ChrisHayward-dev/SapphireKicad/README.md

See the LastProduction branch for the most current revision
