ChrisHayward-dev/SapphireKicad/SapphirePinout.xlsx

Sheet: E Mini Pin Connection
Sapphire Pin Connection Table
 |  |  |  |  |  |  | Proposed E Series Mini
ATSAMD21E18_QFN
Pin E Series | Adafruit Name | Ports (J Series) | Ports | GCLK | SERCOM | Int | Sapphire | Global Name | Pullup | PinMode | Idle State | Use Interrupt | DS3231 Pin | DHLR Pin | TPS22929 GNSS Pin | TPS22929 SD Pin | Other
1 | 32 KHz xtal |  | PA00 |  | S1_0 | 0 | DS3231 32KHz | 32KHz | Y | Input |  |  | 1
2 | 32 KHz xtal |  | PA01 |  | S1_1 | 1 | FRAM CS | FRAM_CS | Y | Input |  | 1 | 3
3 | A0 |  | PA02 |  |  | 2 | RED_LED | RED_LED
4 | AREF |  | PA03 |  |  | 3 | AREF | AREF | N | Input
5 | A3 |  | PA04 |  | S0_0 | 4 | PB1 | PB1 | N | Input
6 | A4 |  | PA05 |  | S0_1 | 5 | VBAT_MON | VBAT_MON | N | Input
7 | D8/NEO PIXEL |  | PA06 | pwd | S0_2 | 6 | RS232_TXD5 | ~~RS232_TXD ~~ | ~~N~~ | ~~Input~~ | xmit
8 | D9 |  | PA07 | : | S0_3 | 7 | RS232_RXD5 | ~~RS232_RXD~~ | ~~N~~ | ~~Output~~ | recv
9 | VDDA
10 | GNDA
11 |  |  | PA08 |  | S0_0 | NMI | SD_CS | SD_CS | U | Output
12 |  |  | PA09 |  | S0_2/S2_1 | 17 | SD_CD | SD_CD | N | Output
13 | D1 |  | PA10 | GCLK4 | S0_2/S2_2 | 10 | SD_PWR | SD_PWR | U | Output
14 | D0 |  | PA11 | GCLK5 | S0_3/S2_3 | 11 | GNSS_PWR | GNSS_PWR | D
15 | D2/FL MISO |  | PA14 | GCLK0 | S2_2/S4_2 | 14 | TIMEMARK | GNSS_PPS | N | Input
16 | D5 |  | PA15 | GCLK1 | S2_3/S4_3 | 15 | RED_LED2 | RED_LED2 | N
17 | D11 |  | PA16 | GCLK2 | S1_0/S3_0 | 0 | SPI1_MOSI | SPI1_MOSI | N
18 | D13 |  | PA17 | GCLK3 | S1_1/S3_1 | 1 | SPI1_SCK | SPI1_SCK | N | Output
19 | D10 |  | PA18 |  | S1_2/S3_2 | 2 | DLHR_EOC | DLHR_EOC | N | Input |  | 2
20 | D12 |  | PA19 |  | S1_3/S3_3 | 3 | SPI1_MISO | SPI1_MISO | N | Input |  | 3
21 | SDA |  | PA22 |  | S3_0/S5_0 | 6 | mcu SDA | mcu SDA | U | I/O |  |  | 15
22 | SCL |  | PA23 |  | S3_1/S5_1 | 7 | mcu SCL | mcu SCL | U | I/O |  |  | 16
23 | D- |  | PA24 |  | S3_2/S5_2 | 12 | USB DM | USB DM |  | I/O
24 | D+ |  | PA25 |  | S3_3/S5_3 | 13 | USB DP | USB DP |  | I/O
25 | TXLED |  | PA27 | GCLK0 |  | 15 | GREEN_LED | GREEN_LED | N | Input
26 | RESET |  |  |  |  |  | RESET | RESET | U | Input |  |  | 4
27 | USBHOSTEN |  | PA28 | GCLK0 |  | 8 | LOCAL_PPS | LOCAL_PPS | N | Output
28 | GND
29 | VDDCORE
30 | VDDIN
31 | SWCLK |  | PA30 | GCLK0 | S1_2 | 10 | SWCLK | SWCLK | U | DEBUG
32 | SWDIO |  | PA31 |  | S1_3 | 11 | SWDIO/FRAM HOLD | SWDIO | U | DEBUG

Sheet: Copy of E Mini Pin Connection
Sapphire Pin Connection Table
 |  |  |  |  |  |  |  | Proposed E Series Mini
ATSAMD21E18_QFN
Pin E Series | Adafruit Name | Ports (J Series) | Ports | GCLK | SERCOM | Int | Prototype Sapphire Use | Sapphire | Global Name | Pullup | PinMode | Changes | Idle State | Use Interrupt | DS3231 Pin | DHLR Pin | TPS22929 GNSS Pin | TPS22929 SD Pin | Other
1 | 32 KHz xtal |  | PA00 |  | S1_0 | 0 | XTAL | DS3231 32KHz | 32KHz | Y | Input |  |  |  | 1
2 | 32 KHz xtal |  | PA01 |  | S1_1 | 1 | XTAL | DS3231 SQW | LOCAL_PPS | Y | Input | Unused |  | 1 | 3
3 | A0 |  | PA02 |  |  | 2 | VCXO cntrl | RED_LED | RED_LED
4 | AREF |  | PA03 |  |  | 3 | spare | AREF | AREF | N | Input
5 | A3 |  | PA04 |  | S0_0 | 4 | VCUR MON | PWR_GOOD | PWR_GOOD | N | Input
6 | A4 |  | PA05 |  | S0_1 | 5 | VBAT MON | VBAT_MON | VBAT_MON | N | Input
7 | D8/NEO PIXEL |  | PA06 | pwd | S0_2 | 6 | Green LED | ~~RS232_TXD ~~ | ~~RS232_TXD ~~ | ~~N~~ | ~~Input~~ | RS232_RXD | xmit
8 | D9 |  | PA07 | : | S0_3 | 7 | spare | ~~RS232_RXD~~ | ~~RS232_RXD~~ | ~~N~~ | ~~Output~~ | RS232_TXD | recv
9 | VDDA
10 | GNDA
11 |  |  | PA08 |  | S0_0 | NMI |  | SD_CS | SD_CS | U | Output
12 |  |  | PA09 |  | S0_2/S2_1 | 17 | spare | SD_CD | SD_CD | N | Output
13 | D1 |  | PA10 | GCLK4 | S0_2/S2_2 | 10 | spare | SD_PWR | SD_PWR | U | Output
14 | D0 |  | PA11 | GCLK5 | S0_3/S2_3 | 11 | spare | GNSS_PWR | GNSS_PWR | D
15 | D2/FL MISO |  | PA14 | GCLK0 | S2_2/S4_2 | 14 | Accel Int1 | RED_LED2 | RED_LED2 | N | Input
16 | D5 |  | PA15 | GCLK1 | S2_3/S4_3 | 15 | Accel Int2 | GNSS_PPS | GNSS_PPS | N
17 | D11 |  | PA16 | GCLK2 | S1_0/S3_0 | 0 | 7124 RDY | SPI1_MOSI | SPI1_MOSI | N
18 | D13 |  | PA17 | GCLK3 | S1_1/S3_1 | 1 | Red LED | SPI1_SCK | SPI1_SCK | N | Output
19 | D10 |  | PA18 |  | S1_2/S3_2 | 2 | DLHR EOC | DLHR_EOC | DLHR_EOC | N | Input |  |  | 2
20 | D12 |  | PA19 |  | S1_3/S3_3 | 3 | Timemark | SPI1_MISO | SPI1_MISO | N | Input |  |  | 3
21 | SDA |  | PA22 |  | S3_0/S5_0 | 6 | mcu SDA | mcu SDA | mcu SDA | U | I/O |  |  |  | 15
22 | SCL |  | PA23 |  | S3_1/S5_1 | 7 | mcu SCL | mcu SCL | mcu SCL | U | I/O |  |  |  | 16
23 | D- |  | PA24 |  | S3_2/S5_2 | 12 | USB DM | USB DM | USB DM |  | I/O
24 | D+ |  | PA25 |  | S3_3/S5_3 | 13 | USB DP | USB DP | USB DP |  | I/O
25 | TXLED |  | PA27 | GCLK0 |  | 15 | GNSS 3D fix | GNSS_GO2SLEEP | GNSS_GO2SLEEP | N | Input | GREEN_LED
26 | RESET |  |  |  |  |  |  | RESET | RESET | U | Input |  |  |  | 4
27 | USBHOSTEN |  | PA28 | GCLK0 |  | 8 | GNSS 2 sleep | GREEN_LED | GREEN_LED | N | Output | Local PPS
28 | GND
29 | VDDCORE
30 | VDDIN
31 | SWCLK |  | PA30 | GCLK0 | S1_2 | 10 | SWCLK | SWCLK | SWCLK | U | DEBUG
32 | SWDIO |  | PA31 |  | S1_3 | 11 | SWDIO | SWDIO | SWDIO | U | DEBUG

Sheet: Original BOM
Reference | Value | Footprint | Datasheet | MPN | Manufacturer |  |  | Tolerance | Type | voltge | count
> BT601, BT602 | Battery | geo_sci_SMU:Keystone_2464_batt_holder | ~ | 2464 | Keystone |  |  |  |  |  | 2
> C201, C401, C501, C502, C512, C516, C601, C607, C608, C613-C618, C701, C802, C809 | 10uF | ... | ~ | ... | ... |  |  | ... | ... | ... | 18
> C202, C301, C402, C403, C503-C505, C507, C511, C513-C515, C517-C521, C602, C605, C609, C610, C612, C702, C703, C801, C803, C805-C808, C813, C814, C816 | 100nF | ... | ~ | ... | ... |  |  | ... | ... | 50V | 33
 |  |  |  | CGA3E2X7R1H104K080AA | TDK |  |  | 10% | X7R | 50V
> C506, C603, C604, C606, C804, C817 | 1uF | Capacitors_SMD:C_0603 | ~ | CC0603KRX5R8BB105 | Yageo |  |  | 10% | X5R | 25V | 6
> C508, C509 | 22nF | Capacitors_SMD:C_0603 | ~ | GRM21B5C1H223JA01L | Murata |  |  | 5% | C0G | 50V | 2
C510 | 220nF | Capacitors_SMD:C_1206 | ~ | GRM31C5C1H224JE02L | Murata |  |  | 5% | CoG | 50V | 1
C611 | 2.2pF | Capacitors_SMD:C_0603 | ~ | CC0603KRX5R8BB105 | Yageo |  |  | 10% | X5R | 25V | 1
> C810, C811 | 12pF | Capacitors_SMD:C_0603 | ~ | GCM1885C2A120FA16D | Murata |  |  | 1% | C0G | 100V | 2
C815 | 4u7 | Capacitors_SMD:C_0603 | ~ | GRM188R61E475KE11D | Murata |  |  | 10% | X5R | 25V | 1
CR801 | TPD4E1U06DCK | TO_SOT_Packages_SMD:SOT-363_SC-70-6 |  | TPD4E1U06DCKR | Texas Instruments |  |  |  |  |  | 1
D601 | MBR180 | Diodes_SMD:D_SOD-123 | ~ | MBR180S1-7 | Diodes Inc |  |  |  |  |  | 1
D801 | RGB | geo_sci_SMU:SML_LX0303_RGB | https://www.mouser.com/datasheet/2/244/SML-LX0303SIUPGUSB-1509215.pdf | SML-LX0303SIUPGUSB | LUMEX |  |  |  |  |  | 1
D802 | GREEN | LEDs:LED_0603 | ~ | APHD1608LCGCK | Kingbright |  |  |  |  |  | 1
D803 | RED | LEDs:LED_0603 | ~ | APTD1608SURCK | Kingbright |  |  |  |  |  | 1
D804 | YELLOW | LEDs:LED_0603 | ~ | APHD1608LSYCK | Kingbright |  |  |  |  |  | 1
> FB401, FB501, FB502, FB801 | 600 | Resistors_SMD:R_0603 | ~ | BLM18KG601SZ1D | Murata |  | BLM18KG601SZ1D |  |  |  | 4
> FID101-FID103 | Fiducial | Fiducials:Fiducial_1mm_Dia_2.54mm_Outer_CopperTop | ~ |  |  |  |  |  |  |  | 3
> H101-H104 | MountingHole | Mounting_Holes:MountingHole_3.2mm_M3_Pad_Via | ~ |  |  |  |  |  |  |  | 4
J501 | Conn_01x02 | Connectors_Molex:Molex_KK-6410-02_02x2.54mm_Straight | ~ | 22-23-2023 | Molex |  |  |  |  |  | 1
J502 | Conn_02x03_Odd_Even | geo_sci_SMU:Socket_Strip_Straight_2x03_Pitch2.54mm | ~ | M20-9980346 | Harwin |  |  |  |  |  | 1
J801 | Conn_02x10_Odd_Even | geo_sci_SMU:Socket_Strip_Straight_2x10_Pitch2.54mmL_R | ~ | 77313-824-20LF | Amphenol FCI |  |  |  |  |  | 1
J802 | Conn_02x05_Odd_Even | geo_sci_SMU:Socket_Strip_Straight_2x05_Pitch2.54mm_shrouded | ~ | N2510-6002RB | 3M |  |  |  |  |  | 1
J803 | USB_B_Micro | geo_sci_SMU:uUSB_B | ~ | 10118192-0001LF | Amphenol FCI |  |  |  |  |  | 1
L601 | 1.2 uH |  | ~ |  |  |  |  |  |  |  | 1
> P501-P503 | SHUNT |  |  | 382811-6 | TE Connectivity |  |  |  |  |  | 3
P801 | sdcard_conn | geo_sci_SMU:Molex_1051620001_uSDcard | https://www.molex.com/pdm_docs/sd/1051620001_sd.pdf | 1051620001 | Molex |  |  |  |  |  | 1
Q601 | BC857B | TO_SOT_Packages_SMD:SOT-363_SC-70-6 | ~ | BC857BDW1T1G | On Semiconductor |  |  |  |  |  | 1
Q602 | IRLML6402 | TO_SOT_Packages_SMD:SOT-23 | ~ | IRLML6402TRPBF | Infineon Technologies |  |  |  |  |  | 1
> R201, R304, R704-R706 | 10K | Resistors_SMD:R_0603 | ~ | CRCW060310K0FKEA | Vishay |  |  | 1% | thick film |  | 5
> R202, R203, R301-R303, R401-R403, R504, R511-R514, R520, R523, R526, R527, R701-R703, R801, R803-R805, R807, R808, R814-R818, R840 | 51R1 | Resistors_SMD:R_0603 | ~ | CRCW060351R1FKEA | Vishay |  |  | 1% | thick film |  | 32
R503 | 2K0 | Resistors_SMD:R_0603 | ~ | CRCW06032K00FKEAC | Vishay |  |  | 1% | thick film |  | 1
R505 | 499K | Resistors_SMD:R_0603 | ~ | CRCW0603499KFKEB | Vishay |  |  |  |  |  | 1
> R502, R506 | 11K3 | Resistors_SMD:R_0603 | ~ | CRCW060311K3FKEA | Vishay |  |  |  |  |  | 2
R507 | 22K6 | Resistors_SMD:R_0603 | ~ | CRCW060322K6FKEA | Vishay |  |  |  |  |  | 1
> R501, R508, R510, R601-R603, R607-R610 | 100K | Resistors_SMD:R_0603 | ~ | CRCW0603100KFKEAC | Vishay |  |  |  |  |  | 10
> R509, R515-R519, R606, R841 | 1K0 | Resistors_SMD:R_0603 | ~ | CRCW06031K00FKEAC | Vishay |  |  | 1% | thick film |  | 8
> R522, R524, R525, R802, R806, R809-R811, R820, R822-R830, R832, R834-R839, R843, R844 | 47K5 | Resistors_SMD:R_0603 | ~ | CRCW060347K5FKEAC | Vishay |  |  | 1% | thick film |  | 27
R604 | 150K | Resistors_SMD:R_0603 | ~ | CRCW0603150KFKEB | Vishay |  |  |  |  |  | 1
R605 | 0R1 | Resistors_SMD:R_1206 | ~ | SR732BTTDR100F | KOA Speer |  |  |  |  |  | 1
> R611, R612 | ? | Resistors_SMD:R_0603 | ~ | CRCW0603100KFKEAC | Vishay |  |  |  |  |  | 2
R813 | 68K1 | Resistors_SMD:R_0603 | ~ | CRCW060368K1FKEB | Vishay |  |  |  |  |  | 1
> R819, R821 | 3K16 | Resistors_SMD:R_0603 | ~ | CRCW06033K16FKEA | Vishay |  |  | 1% | thick film |  | 2
> R842, R846 | 2K2 | Resistors_SMD:R_0603 | ~ | CRCW06032K20FKEA | Vishay |  |  | 1% | thick film |  | 2
> R812, R845 | 4K75 | Resistors_SMD:R_0603 | ~ | CRCW06034K75FKEAC | Vishay |  |  | 1% | thick film |  | 2
SW801 | PB_SW | geo_sci_SMU:SW_PB_4.5x4.5mm |  | PTS647SN50SMTR2LFS | C&K |  |  |  |  |  | 1
TP501 | TP | geo_sci_SMU:TP_Keystone |  | 5007 | Keystone Electronics |  |  |  |  |  | 1
TP502 | GND | geo_sci_SMU:TP_Keystone |  | 5006 | Keystone Electronics |  |  |  |  |  | 1
U201 | SIM33ELA | geo_sci_SMU:SIM33ELA | http://en.simcom.com/upload/file/1544000733.pdf | SIM33ELA | SimCom |  |  |  |  |  | 1
U301 | BMP388 | geo_sci_SMU:BMP388 | https://ae-bst.resource.bosch.com/media/_tech/media/datasheets/BST-BMP388-DS001.pdf | BMP388 | Bosch Sensortec |  |  |  |  |  | 1
U401 | DLHR_pressure_sense | geo_sci_SMU:DLHR_E1BD | https://www.allsensors.com/cad/DS-0350_Rev_B.PDF | DLHR-F05D-E1BD-C | All Sensors |  |  |  |  |  | 1
U501 | OPA2388 | ... | http://www.ti.com/lit/ds/symlink/opa2388.pdf | OPA2388IDGKR | Texas Instruments |  |  |  |  |  | 1
U502 | BLVR_pressure_sensor | geo_sci_SMU:BLVR_B1NS-D | https://www.allsensors.com/datasheets/DS-0280-Rev-A2.pdf | BLVR-L05D-B1NS-P | All Sensors |  |  |  |  |  | 1
U503 | Si5351B | geo_sci_SMU:QFN-20-1EP_4x4mm_Pitch0.5mm | https://www.silabs.com/documents/public/data-sheets/Si5351-B.pdf | SI5351B-B-GMR | Silicon Labs |  |  |  |  |  | 1
U504 | AD7124 | Housings_SSOP:TSSOP-24_4.4x7.8mm_Pitch0.65mm | https://www.analog.com/media/en/technical-documentation/data-sheets/AD7124-4.pdf | AD7124-4BRUZ | Analog Devices |  |  |  |  |  | 1
U505 | LVC2G00 | Housings_SOIC:SOIC-8_3.9x4.9mm_Pitch1.27mm |  | SN74LVC2G00DCTR | Texas Instruments |  |  |  |  |  | 1
U601 | INA181 | TO_SOT_Packages_SMD:SOT-23-6 | http://www.ti.com/lit/ds/symlink/ina181.pdf | INA181A3IDBVR | Texas Instruments | 100V/V |  |  |  |  | 1
U602 | TLV70233 | TO_SOT_Packages_SMD:SOT-23-5 | http://www.ti.com/lit/ds/symlink/tlv702.pdf | TLV70233DBVR | Texas Instruments |  |  |  |  |  | 1
U603 | TPS63060 | Package_SON:Texas_S-PWSON-N10_ThermalVias | http://www.ti.com/lit/ds/symlink/tps63060.pdf |  |  |  |  |  |  |  | 1
U701 | LIS2DE12 | Housings_LGA:LGA-12_2x2mm_Pitch0.5mm | https://www.st.com/resource/en/datasheet/lis2DE12.pdf | LIS2DE12TR | ST Microelectronics |  |  |  |  |  | 1
U801 | APX811 | TO_SOT_Packages_SMD:SOT-143 | https://www.mouser.com/datasheet/2/115/APX811_812-9047.pdf | APX811-29UG-7 | Diodes Inc |  |  |  |  |  | 1
U802 | NCP5623 | Housings_SSOP:TSSOP-14_4.4x5mm_Pitch0.65mm | https://www.onsemi.com/pub/Collateral/NCP5623-D.PDF | NCP5623DTBR2G | On Semiconductor |  |  |  |  |  | 1
U803 | ATSAMD21G18A | Housings_QFP:TQFP-48_7x7mm_Pitch0.5mm | http://ww1.microchip.com/downloads/en/DeviceDoc/SAMD21-Family-DataSheet-DS40001882D.pdf | ATSAMD21G18A-AU | Microchip |  |  |  |  |  | 1
Y501 | 27MHz | geo_sci_SMU:AB11AIG_1.6x2mm | ~ | ABM11AIG-27.000MHz-1-T | Abracon |  |  |  |  |  | 1
Y801 | 32.768KHz | geo_sci_SMU:ABS25_8mmx3.8mm | https://www.mouser.com/datasheet/2/3/abs25-35653.pdf | ABS25-32.768KHZ-T | Abracon |  |  |  |  |  | 1

Sheet: Operations Calculations
Operations Calculations
DS3231 Accuracy | 2 | ppm
Daily Drift | 0.1728 | seconds
Run Time | 30 | days
Maximum Drift | 5.184 | Seconds
Sample Rate | 16 | Hz
Sample Period | 0.0625 | Seconds
Time to drift 1 sample | 31250 | Seconds | 8.7 | Hours
Required precision | 0.01 | Seconds
Update Period | 5000 | Seconds | 1.4 | Hours
GPS Current | 30 | mA
GPS Lock Time | 30 | Seconds
GPS Power Req | 0.825 | mWH
GPS Power/Day | 14.256 | mWH /day
Recorder Base Current | 6 | mA | Battery Size | AAA | AA | C
Recorder Base Power | 19.8 | mWH | Capacity (mAH) | 750 | 2500 | 8000
Recorder Base Power/Day | 475.2 | mWH/day
Total Power/Day | 489.456 | mWH/day
Cell Capacity | 2500 | mAH
Number Cells | 4
Total Power | 15000 | mWH
Derating | 80.00%
Run Time | 24.5 | Days

Sheet: Pneumatics
Backing Volume Calculator
Constants
air shear viscosity | 0.00018013 | gm/(cm-sec) |  |  | 0.00018013 | gm/(mm-s) | pjoise
atmospheric pressure | 81 | KPa |  |  | 810000 | Pa
adiabatic gas constant | 1.403 |  |  |  | 1.403
Hyperdermic Needle Case
Backing Volume | 2 | ml
Capillary length | 0.75 | in |  |  | 1.905 | cm
Capillary radius | 36.5 | gauge | 0.002359191754 | in | 0.005992347056 | cm
RC Model
Resistance | 677693.4845 | acoustic ohms
Capacitance | 1.759897222e-06 | acoustic farads
RC constant | 1.19
RC cutoff | 0.13 | Hz |  |  | 7.49 | seconds
Capillary Case
Backing Volume | 2 | ml |  |  | 2 | ml
Capillary length | 0.016 | m |  |  | 1.6 | cm
Capillary radius | 30 | um | 0.001181102362 | in | 0.003 | cm
Max outside diameter | 373 | um |  |  | 0.01468503937 | in
AWG Outside | 20.7 | gauge
RC Model
Resistance | 9060686.98 | acoustic ohms
Capacitance | 1.759897222e-06 | acoustic farads
RC constant | 15.95
RC cutoff | 0.00998 | Hz |  |  | 100.19 | seconds
Adiabatic to isothermal Transistion
Thermal conductivity | 0.025 | W/(m K) | kg m^2 s^-3/m K |  | 0.00025 | W/(cm K)
Heat Capacity/volume | 1100 | J/m^2/K | kg m^2 s^-3/m^2/K |  | 0.0011 | J/cm^3/K
Thermal diffusivity | 2.272727273e-05 | 1/m |  |  | 0.2272727273 | 1/cm
Length | 1.1 | in |  |  | 2.79 | cm
Diameter | 0.38 | in |  |  | 0.97 | cm
Volume | 0.12 | in^3 |  |  | 2.04 | ml
Internal Surface | 1.54 | in^2 |  |  | 25.24 | cm^2
Characteristic Size | 0.08 | cm |  |  | 0.08 | cm
Transistion Freq |  |  |  |  | 11.02 | Hz
Fore Volume
Case Height | 1.8 | in |  |  | 4.57 | cm
Case Width | 2.3 | in |  |  | 5.84 | cm
Case Length | 3.45 | in |  |  | 8.76 | cm
Nominal Volume | 14.28 | in^3 |  |  | 234.06 | cm^3
Battery Diameter | 0.55 | in |  |  | 1.40 | cm
Battery Length | 1.92 | in |  |  | 4.88 | cm
Number Batteries | 8 |  | includes case bosses
Battery Volume | 3.65 | in^3 |  |  | 59.80 | cm^3
Internal Volume | 10.63 | in^3 |  |  | 174.26 | cm^3
Capacitance | 0.0001533359275 | Acoustic farads
Resistance | 200 | Acoustic Ohms
RC Constant | 0.03
RC cutoff | 5.18975 | Hz |  |  | 0.19 | seconds

Sheet: Maker Verions
Maker Version Costs
Part | Price | Qty | Extended
Adalogger | $19.95 | 1 | $19.95
Stacking Header | $1.25 | 2 | $2.50
DS3231 | $13.95 | 1 | $13.95
Feather GPS | $39.95 | 1 | $39.95
Feather Proto | $4.95 | 1 | $4.95
Feather Doubler | $7.50 | 1 | $7.50
DLHR sensor | $50.00 | 1 | $50.00
Total |  |  |  | $138.80
3 AA battery holder | $7.99 | 0.25 | $2.00
SK-13 enclosure | $13.19 | 1 | $13.19

Sheet: PackCalculation
Pack Calculation
 |  |  |  |  | This calculation is for the WH-02 design with all the goodies, the 3 channel adc with C-cell option
WH-02 with hose connector
Height | 3 | in |  |  | 2.3
Length | 6 | in |  |  | 3.7
Width | 4.5 | in |  |  | 2.55
Weight
C-Cell (3) | 210 | gm | 70.00 | gm
AA-Cell (3) | 72 | gm | 24.00 | gm
AA-Cell (4) | 96 | gm | 24.00 | gm
AA-LiCell (3) | 42 | gm | 14.00 | gm | 58.33% | Lithium to alkaline weight
Backing V | 23 | gm
PCB | 80 | gm
base plate | 19 | gm
WH-02 | 184 | gm
Total 3-C | 516 | gm | 40.69767442%
Total 3-AA | 378 | gm | 19.04761905%
Total 4-AA | 402 | gm | 23.88059701% |  | 230 | gm
Total 4-AA Li | 348 | gm | 12.06896552% |  | 190 | gm
Total No Bat | 306 | gm |  |  | 134 | gm
Pack Size
Num High | 5 | unit
Num long | 4 | unit
Num Wide | 5 | unit
Totals
Num Units | 100
Weight 3C | 51.6 | kg | 113.66 | lbs
Weight 3AA | 37.8 | kg | 83.26 | lbs
Weight 4AA | 40.2 | kg | 88.55 | lbs | 23 | 50.66
Weight 3AA Li | 34.8 | kg | 76.65 | lbs | 19 | 41.85
Weigth w/o bat | 30.6 | kg | 67.40 | lbs | 13.4 | 29.52
Height | 12 | in | 1.00 | ft | 11.5 | 0.96
Length | 24 | in | 2.00 | ft | 14.8 | 1.23
Width | 22.5 | in | 1.88 | ft | 12.75 | 1.06
 |  |  |  |  |  |  | 1.26
