ChrisHayward-dev/SapphireKicad/Custom_3dModels/LGA-12_STM.step

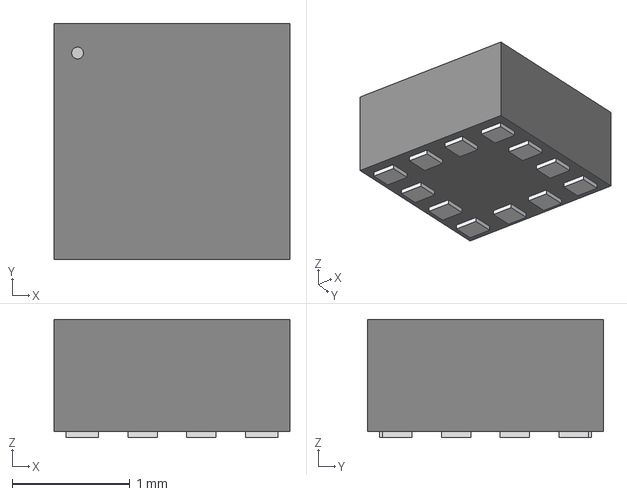
[picture p1: CAD file, 2023-02-20]
Custom_3dModels/LGA-12_STM.step
2.00 x 2.00 x 1.00 mm
