ChrisHayward-dev/SapphireKicad/Custom_3dModels/Trash/DLHR-F50D-E1BD-C-NAV8.stp

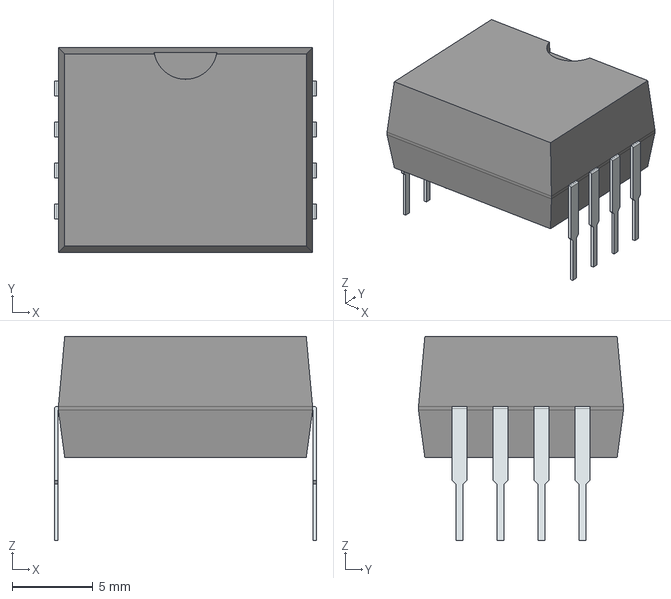
[picture p2: CAD file, 2022-09-25]
Custom_3dModels/Trash/DLHR-F50D-E1BD-C-NAV8.stp
16.2 x 12.7 x 12.7 mm
PinsArrayLR
