ChrisHayward-dev/SapphireKicad/Sapphire_AnalogMicR2/Sapphire_AnalogMic.step

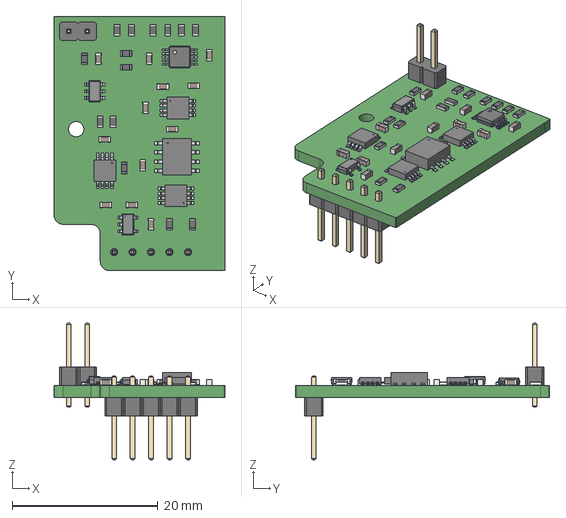
[picture p3: CAD file, 2022-09-22]
Sapphire_AnalogMicR2/Sapphire_AnalogMic.step
23.5 x 34.9 x 18.8 mm
