ChrisHayward-dev/SapphireKicad/Custom_3dModels/RSCSK2043R3D01004T.stp

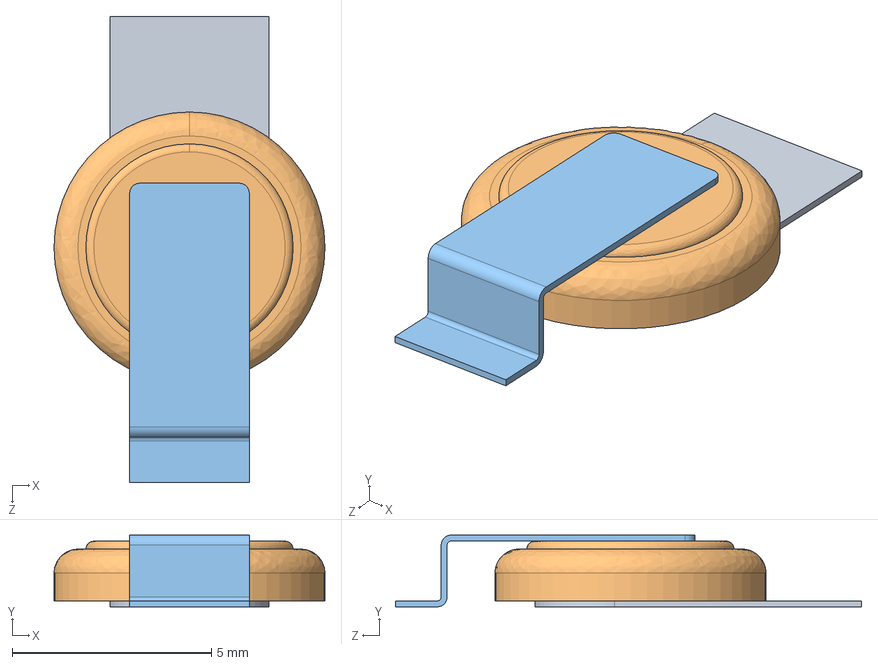
[picture p4: CAD file, 2023-02-20]
Custom_3dModels/RSCSK2043R3D01004T.stp
6.80 x 1.80 x 11.7 mm
