ChrisHayward-dev/SapphireKicad/Custom_3dModels/5525DSO-DB001DS.step

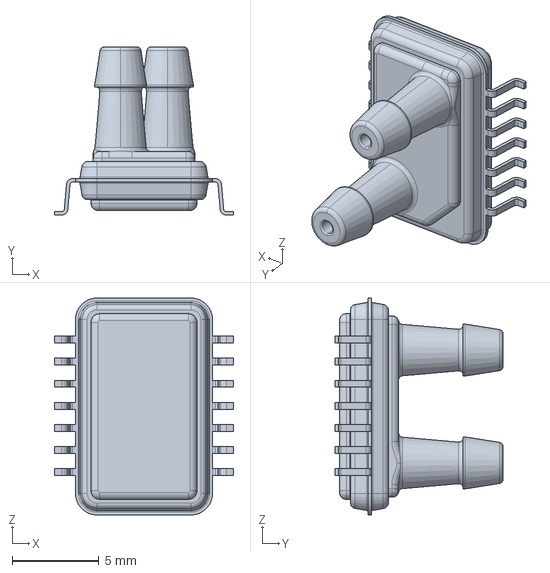
[picture p5: CAD file, 2022-10-13]
Custom_3dModels/5525DSO-DB001DS.step
10.3 x 9.68 x 12.5 mm
