ChrisHayward-dev/SapphireKicad/Custom_3dModels/IND_TAIYO_NR3012_TAY.step

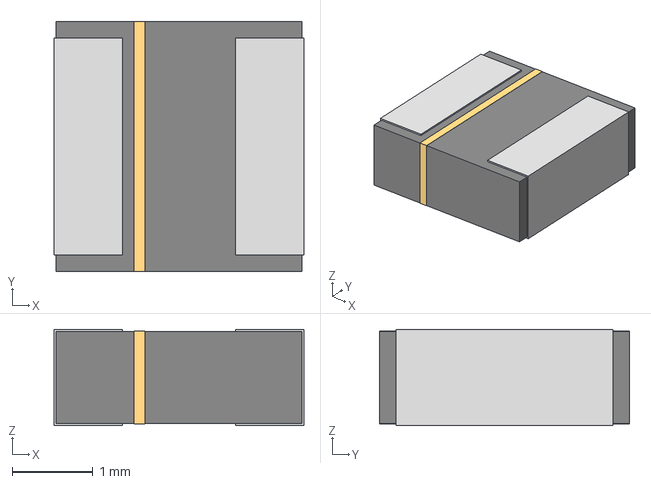
[picture p6: CAD file, 2022-10-03]
Custom_3dModels/IND_TAIYO_NR3012_TAY.step
3.10 x 3.10 x 1.19 mm
