ChrisHayward-dev/SapphireKicad/Custom_3dModels/CONB127P-2R-34W_TH.STEP

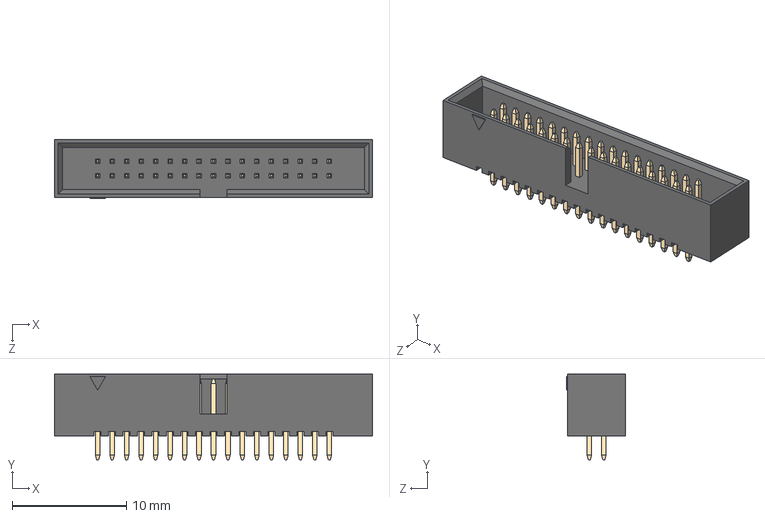
[picture p7: CAD file, 2022-09-25]
Custom_3dModels/CONB127P-2R-34W_TH.STEP
27.9 x 7.50 x 5.20 mm
