ChrisHayward-dev/SapphireKicad/Custom_3dModels/GNSS_module.step

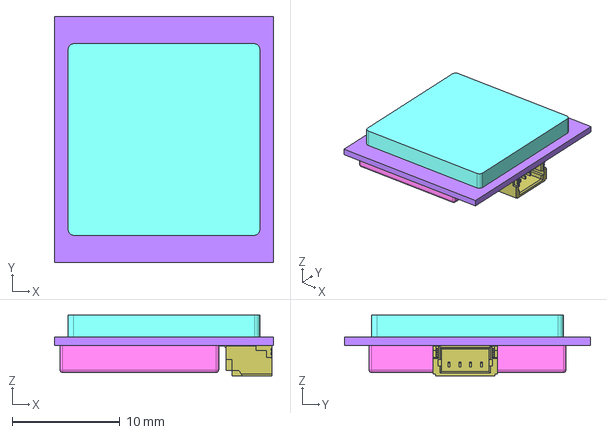
[picture p8: CAD file, 2022-09-25]
Custom_3dModels/GNSS_module.step
20.3 x 22.9 x 5.63 mm
