ChrisHayward-dev/SapphireKicad/Custom_3dModels/CONB127P-2R-20W_TH.STEP

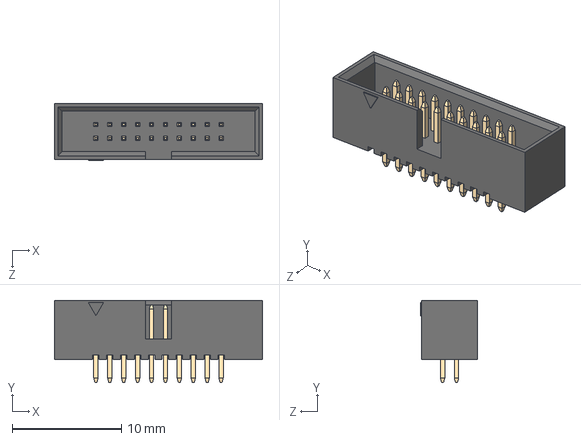
[picture p9: CAD file, 2022-09-25]
Custom_3dModels/CONB127P-2R-20W_TH.STEP
19.0 x 7.50 x 5.20 mm
