ChrisHayward-dev/SapphireKicad/Custom_3dModels/3220-10-0100.igs

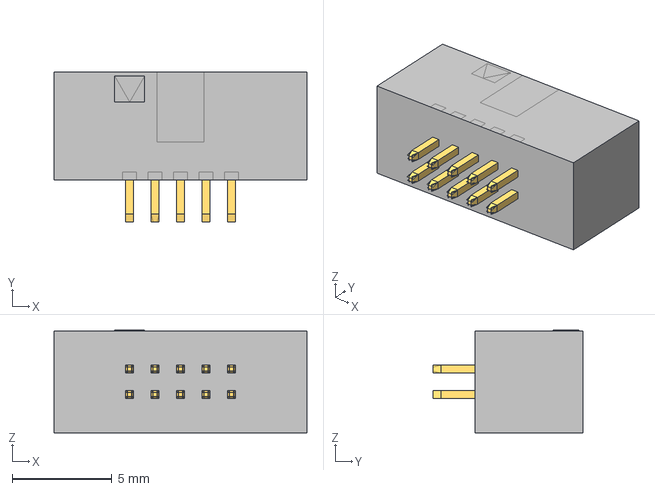
[picture p11: CAD file, 2022-09-25]
Custom_3dModels/3220-10-0100.igs
12.7 x 7.50 x 5.13 mm
