ChrisHayward-dev/SapphireKicad/Custom_3dModels/2908-05WB-MG--3DModel-STEP-56544.stp

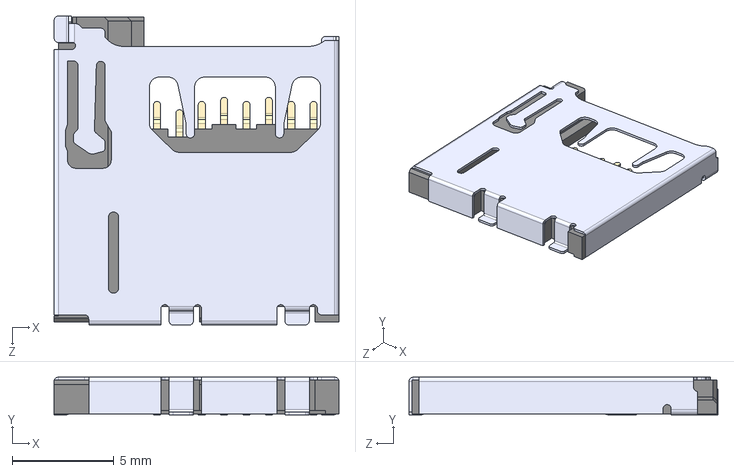
[picture p12: CAD file, 2022-09-25]
Custom_3dModels/2908-05WB-MG--3DModel-STEP-56544.stp
14.0 x 1.85 x 15.2 mm
