ChrisHayward-dev/SapphireKicad/Custom_3dModels/PTS810SJK250SMTRLFS--3DModel-STEP-56544.stp

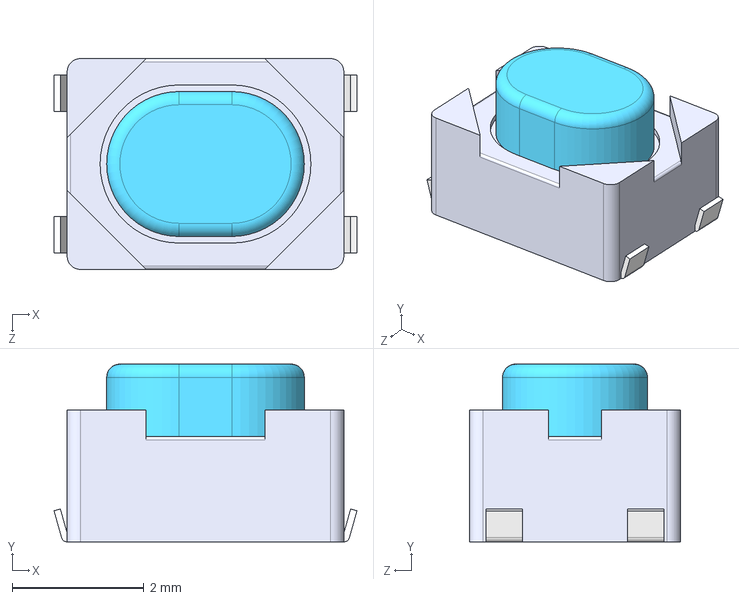
[picture p13: CAD file, 2022-09-25]
Custom_3dModels/PTS810SJK250SMTRLFS--3DModel-STEP-56544.stp
4.60 x 2.70 x 3.20 mm
