ChrisHayward-dev/SapphireKicad/Custom_3dModels/REF2030AIDDCR.STEP

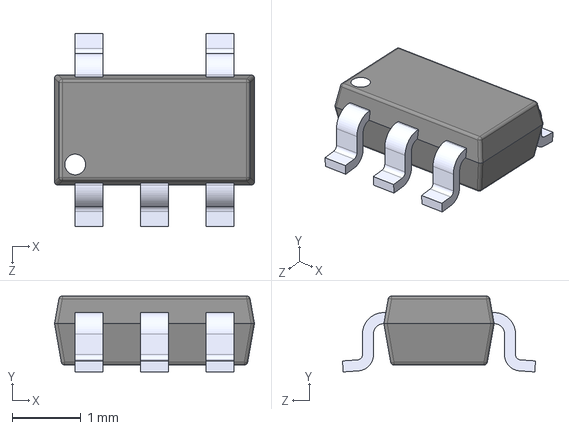
[picture p14: CAD file, 2022-09-25]
Custom_3dModels/REF2030AIDDCR.STEP
2.90 x 1.10 x 2.80 mm
