ChrisHayward-dev/SapphireKicad/Custom_3dModels/MAX7404.step

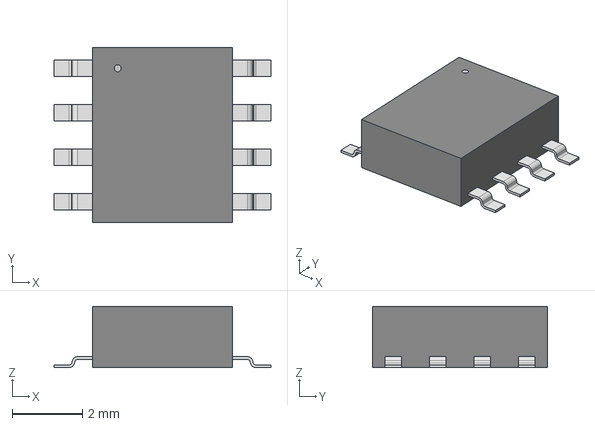
[picture p15: CAD file, 2022-09-25]
Custom_3dModels/MAX7404.step
6.20 x 5.00 x 1.75 mm
