ChrisHayward-dev/SapphireKicad/Custom_3dModels/Adafruit LIS3DH.step

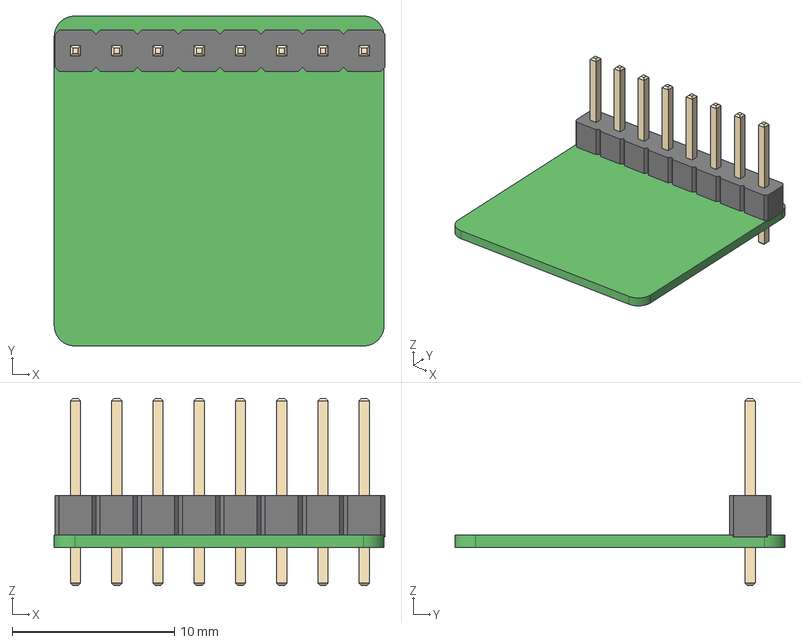
[picture p16: CAD file, 2022-09-25]
Custom_3dModels/Adafruit LIS3DH.step
20.4 x 20.3 x 11.5 mm
