ChrisHayward-dev/SapphireKicad/Custom_3dModels/CONB127P-2R-40W_TH.STEP

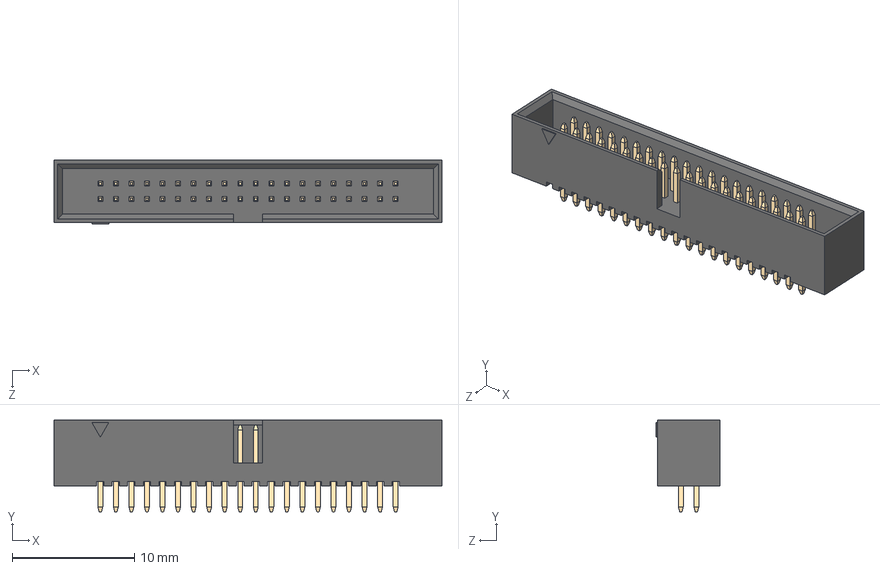
[picture p17: CAD file, 2022-09-25]
Custom_3dModels/CONB127P-2R-40W_TH.STEP
31.7 x 7.50 x 5.20 mm
