ChrisHayward-dev/SapphireKicad/Custom_3dModels/DAC7571.stp

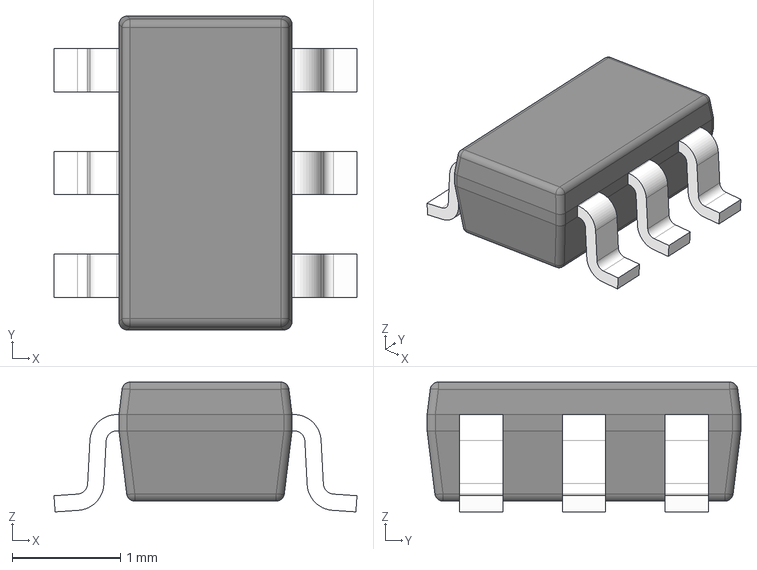
[picture p18: CAD file, 2022-09-25]
Custom_3dModels/DAC7571.stp
2.80 x 2.90 x 1.20 mm
BODY-SOT
LEAD-SOT x 6
