ChrisHayward-dev/SapphireKicad/Custom_3dModels/EVQP7-JA-01P.stp

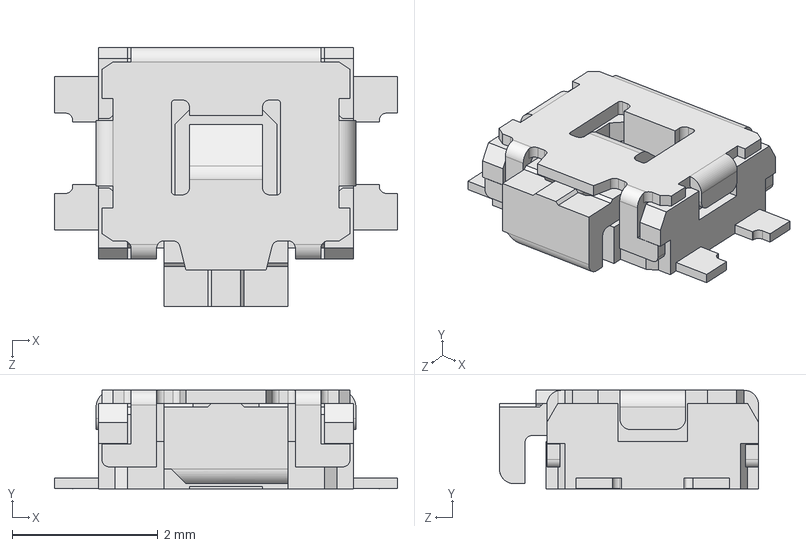
[picture p19: CAD file, 2022-09-25]
Custom_3dModels/EVQP7-JA-01P.stp
4.70 x 1.35 x 3.55 mm
