ChrisHayward-dev/SapphireKicad/Custom_3dModels/CONB127P-2R-14W_TH.STEP

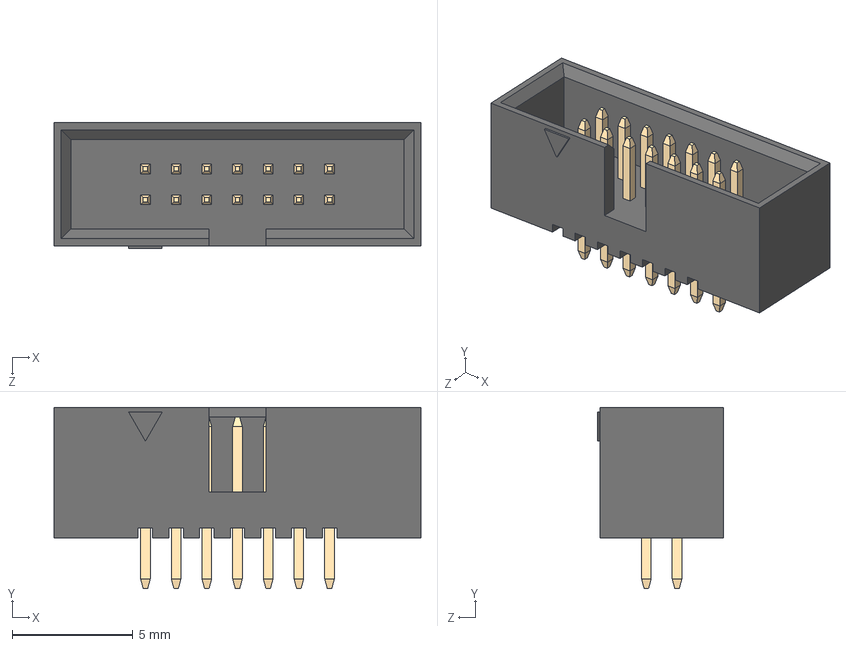
[picture p20: CAD file, 2022-09-25]
Custom_3dModels/CONB127P-2R-14W_TH.STEP
15.2 x 7.50 x 5.20 mm
