ChrisHayward-dev/SapphireKicad/Custom_3dModels/MSOP8_MC_MCH.step

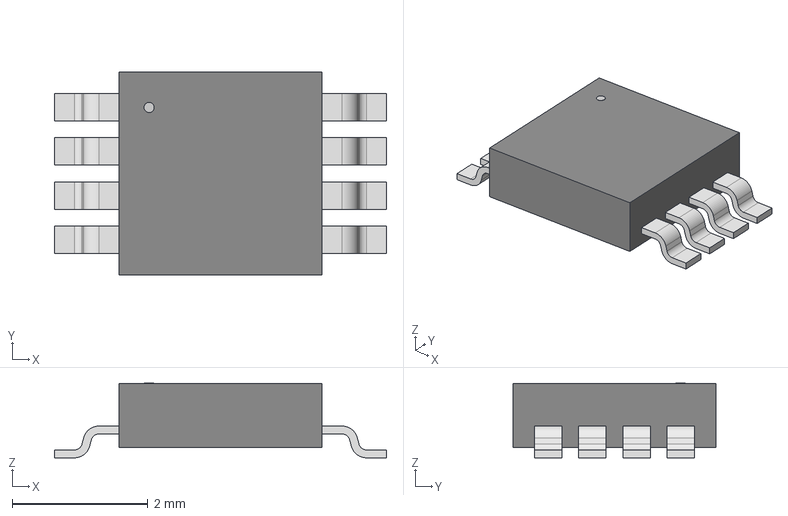
[picture p21: CAD file, 2022-09-25]
Custom_3dModels/MSOP8_MC_MCH.step
4.90 x 3.00 x 1.10 mm
