ChrisHayward-dev/SapphireKicad/Custom_3dModels/CONB127P-2R-50W_TH.STEP

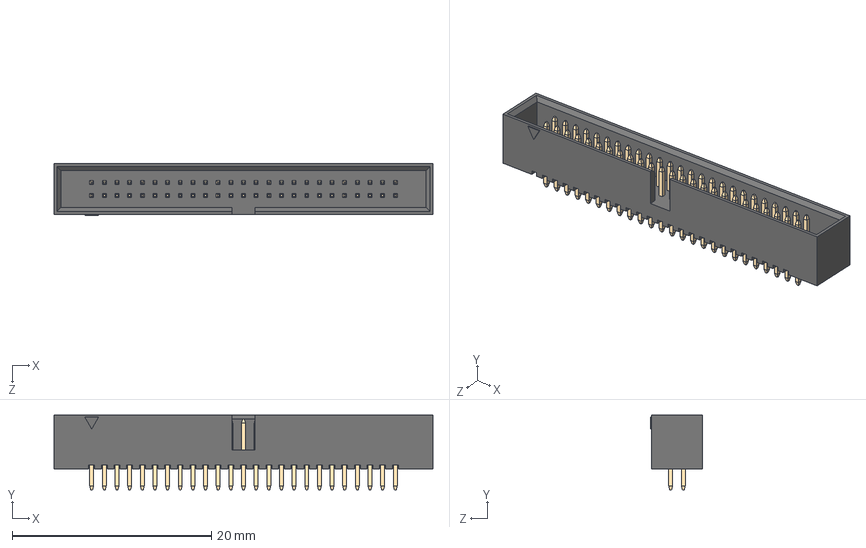
[picture p22: CAD file, 2022-09-25]
Custom_3dModels/CONB127P-2R-50W_TH.STEP
38.0 x 7.50 x 5.20 mm
