ChrisHayward-dev/SapphireKicad/Custom_3dModels/EEE-1EA100WR.stp

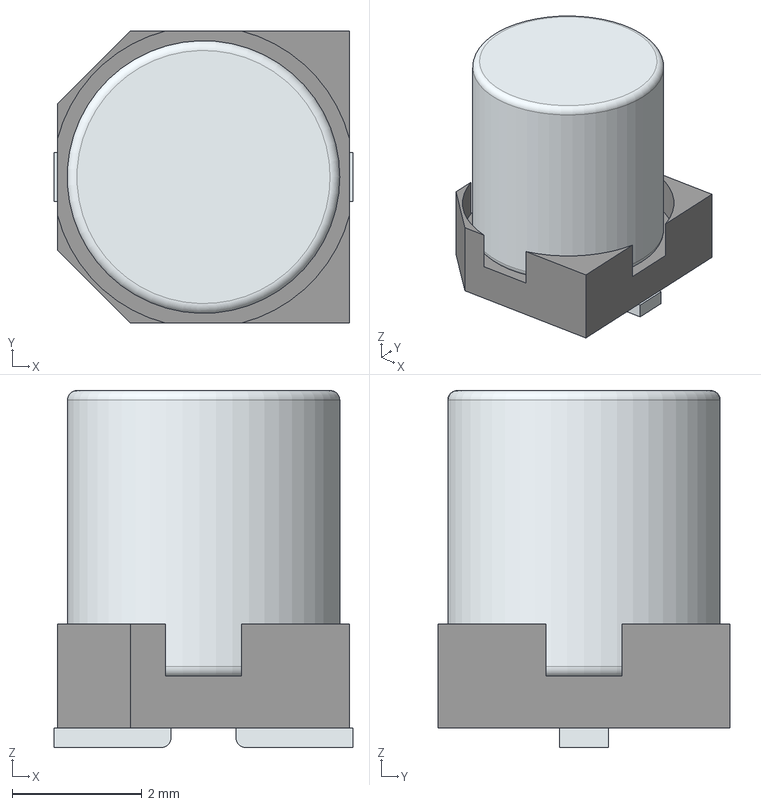
[picture p23: CAD file, 2022-09-25]
Custom_3dModels/EEE-1EA100WR.stp
4.60 x 4.50 x 5.50 mm
Base
Pin1Fillet
Pin2Fillet
