ChrisHayward-dev/SapphireKicad/Custom_3dModels/IND_74439344022_WRE.step

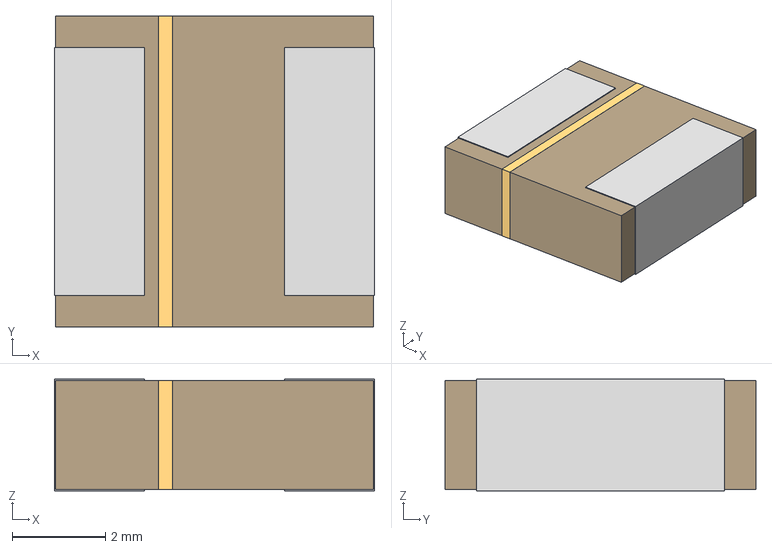
[picture p24: CAD file, 2022-09-25]
Custom_3dModels/IND_74439344022_WRE.step
6.86 x 6.66 x 2.39 mm
