ChrisHayward-dev/SapphireKicad/Custom_3dModels/TC33X-2-202E.step

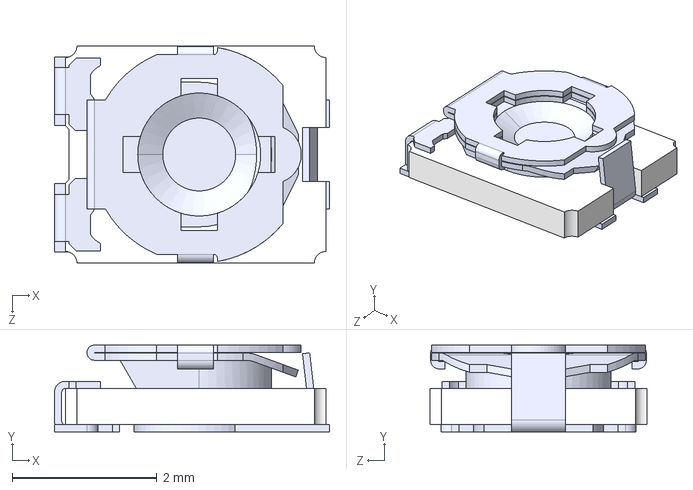
[picture p25: CAD file, 2022-09-25]
Custom_3dModels/TC33X-2-202E.step
3.80 x 1.20 x 3.00 mm
