ChrisHayward-dev/SapphireKicad/Custom_3dModels/CONB127P-2R-26W_TH.STEP

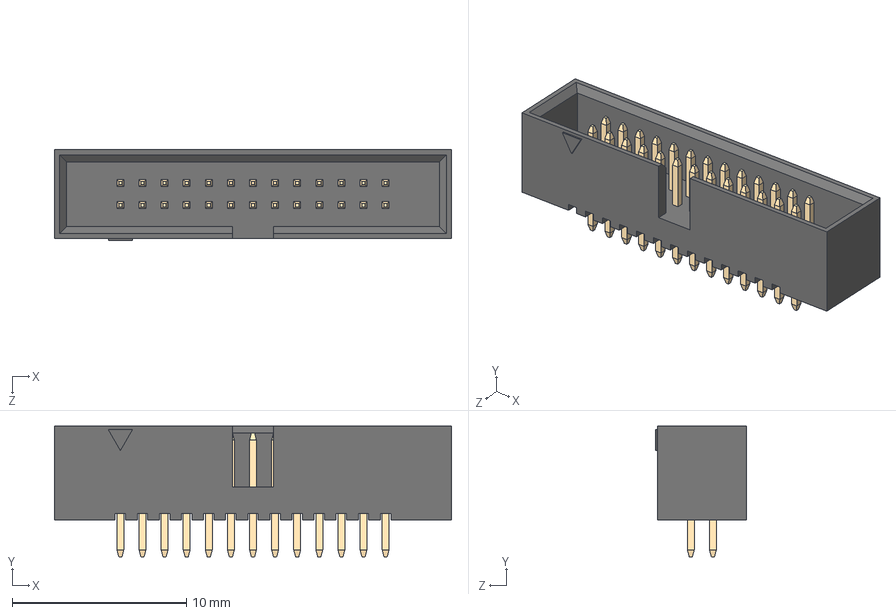
[picture p26: CAD file, 2022-09-25]
Custom_3dModels/CONB127P-2R-26W_TH.STEP
22.8 x 7.50 x 5.20 mm
