ChrisHayward-dev/SapphireKicad/Custom_3dModels/CONB127P-2R-30W_TH.STEP

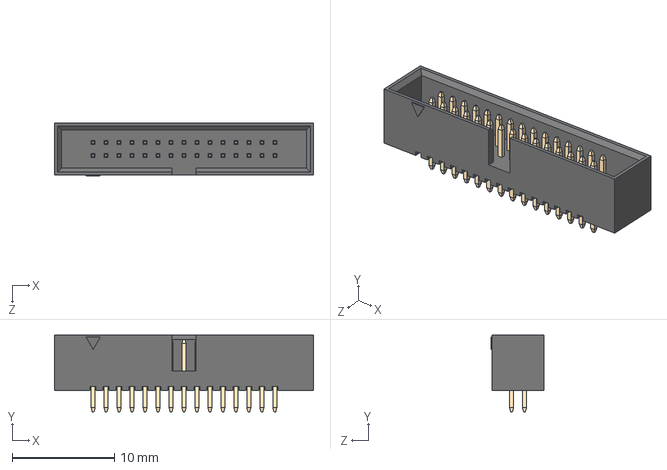
[picture p27: CAD file, 2022-09-25]
Custom_3dModels/CONB127P-2R-30W_TH.STEP
25.4 x 7.50 x 5.20 mm
