ChrisHayward-dev/SapphireKicad/Custom_3dModels/PCA9536D.stp

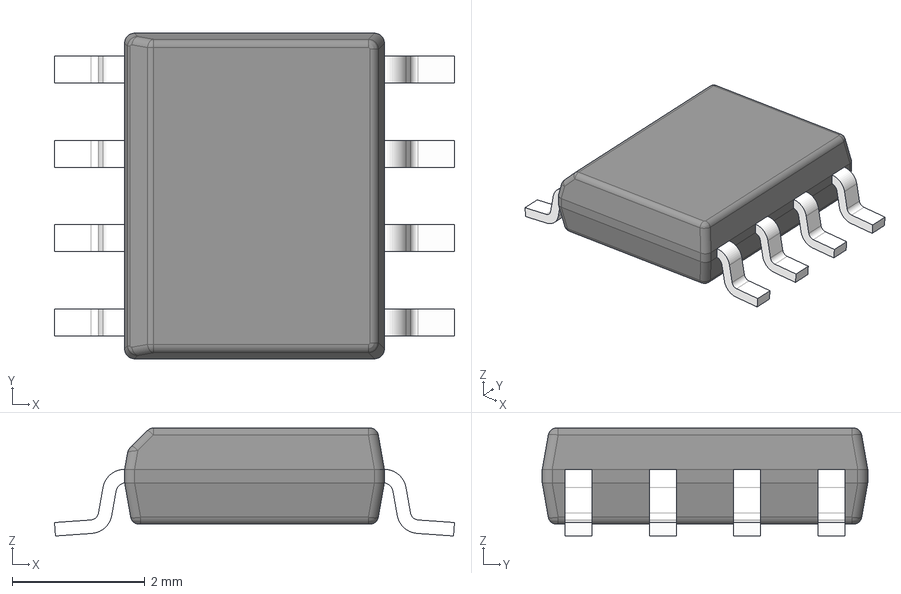
[picture p28: CAD file, 2022-09-25]
Custom_3dModels/PCA9536D.stp
6.02 x 4.90 x 1.63 mm
BODY-SO
LEAD-D0008A x 8
