ChrisHayward-dev/SapphireKicad/Custom_3dModels/TQFP32_MC.step

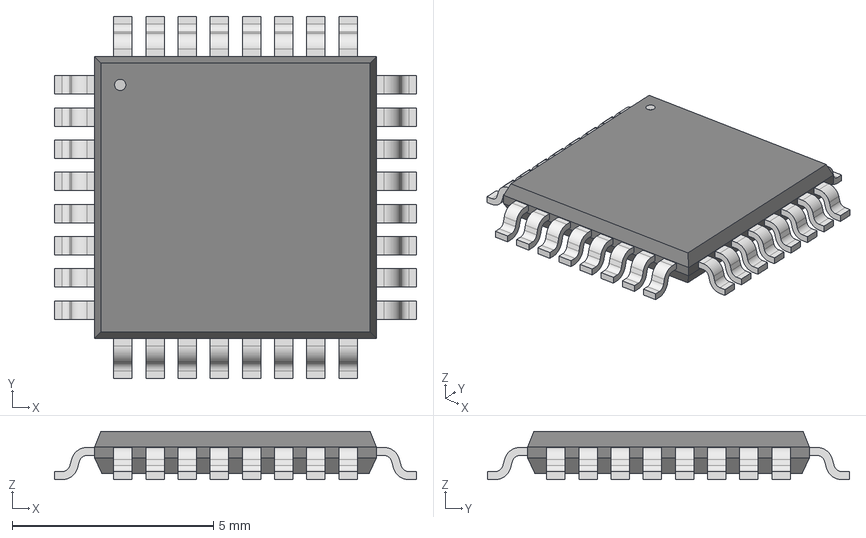
[picture p29: CAD file, 2022-09-25]
Custom_3dModels/TQFP32_MC.step
9.00 x 9.00 x 1.20 mm
