ChrisHayward-dev/SapphireKicad/Custom_3dModels/CAM-M8Q-0--3DModel-STEP-56544.stp

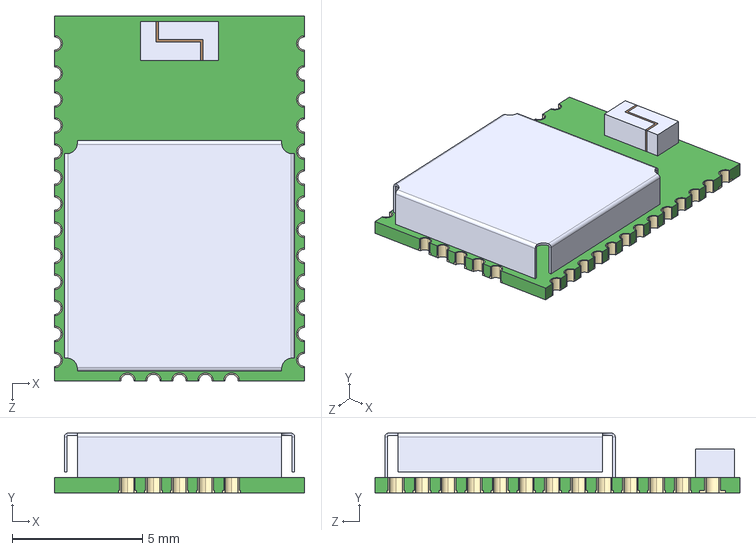
[picture p30: CAD file, 2022-09-25]
Custom_3dModels/CAM-M8Q-0--3DModel-STEP-56544.stp
9.60 x 2.30 x 14.0 mm
