ChrisHayward-dev/SapphireKicad/Custom_3dModels/FPT-8P-M02_FUJ.step

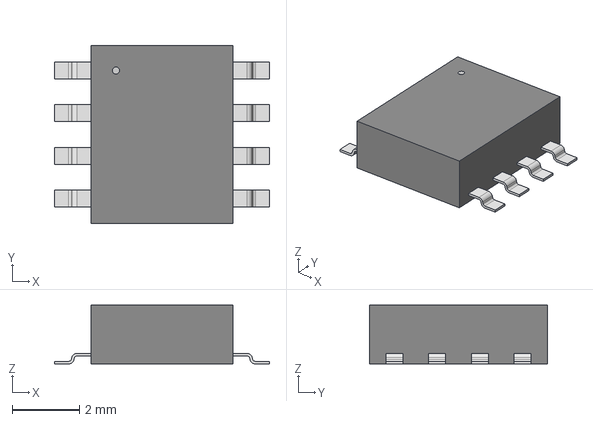
[picture p31: CAD file, 2022-09-25]
Custom_3dModels/FPT-8P-M02_FUJ.step
6.40 x 5.31 x 1.75 mm
