ChrisHayward-dev/SapphireKicad/Custom_3dModels/Adafruit_BMP388.step

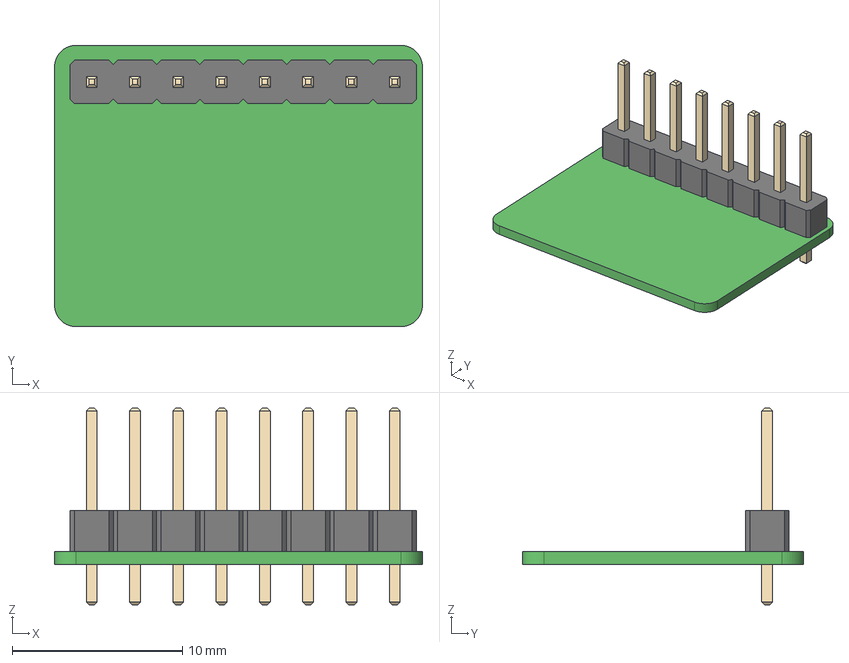
[picture p32: CAD file, 2022-09-25]
Custom_3dModels/Adafruit_BMP388.step
21.6 x 16.5 x 11.5 mm
