ChrisHayward-dev/SapphireKicad/Custom_3dModels/CONB127P-2R-16W_TH.STEP

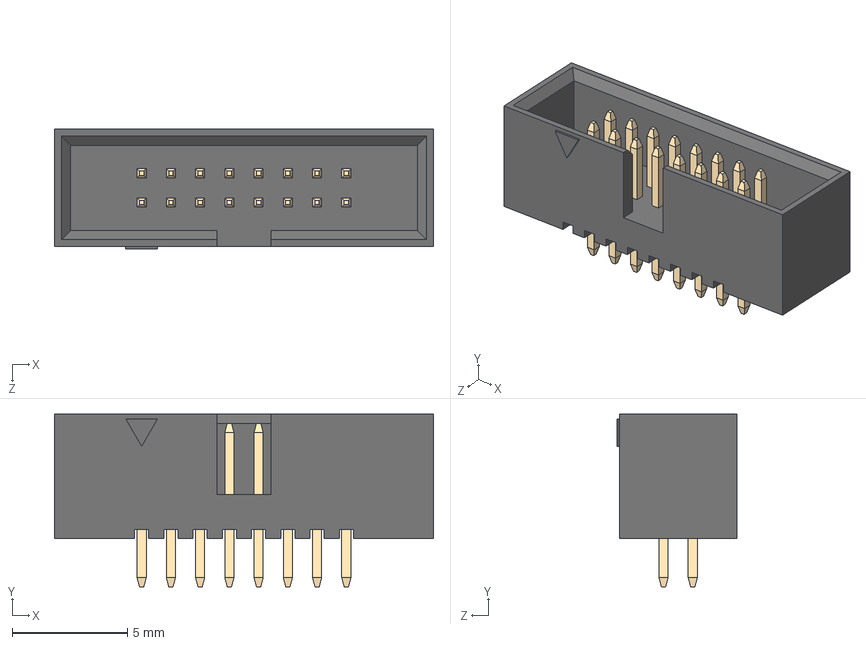
[picture p33: CAD file, 2022-09-25]
Custom_3dModels/CONB127P-2R-16W_TH.STEP
16.5 x 7.50 x 5.20 mm
