ChrisHayward-dev/SapphireKicad/Custom_3dModels/S2B-PH-SM4-TB(LF)(SN)--3DModel-STEP-56544.stp

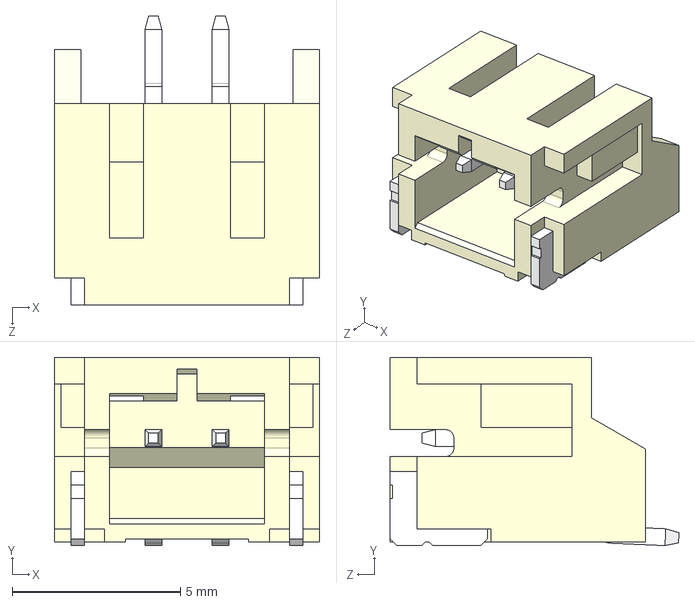
[picture p34: CAD file, 2022-09-25]
Custom_3dModels/S2B-PH-SM4-TB(LF)(SN)--3DModel-STEP-56544.stp
7.90 x 5.60 x 8.60 mm
