ChrisHayward-dev/SapphireKicad/(list of files, cad)

Other CAD files:
Custom_3dModels/TQFP32_MC-M.step
Custom_3dModels/TQFP32_MC-L.step
Custom_3dModels/014441219.stp
Custom_3dModels/10118193-0001LF--3DModel-STEP-56544.STEP
Custom_3dModels/74439344010_STP_WE-XHMI-6030_rev1.stp
Custom_3dModels/TPS22860DBVR.step
Custom_3dModels/TPS62150.stp
Custom_3dModels/TPS82150SILR.stp
Custom_3dModels/Trash/DLHR-F50D-E1BD-C-NAV8.stl
