ChrisHayward-dev/SapphireKicad/PowerDesign1.pdf

## WEBENCH ® Design Report

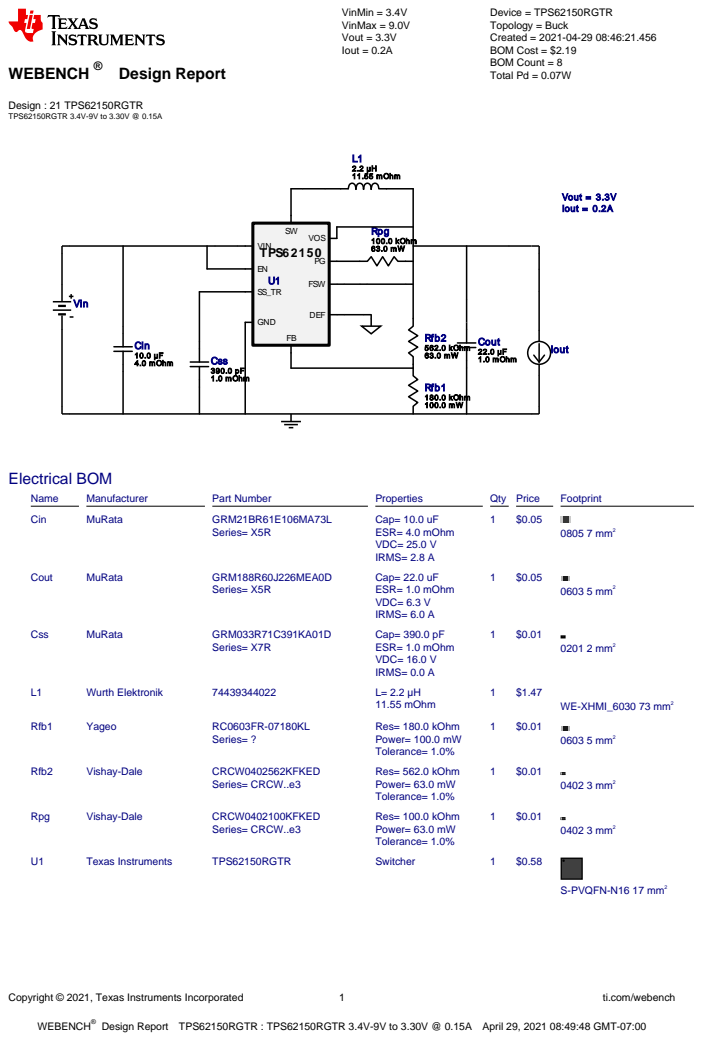
[picture p35: page 1]
Copyright © 2021, Texas Instruments Incorporated; ti.com/webench; WEBENCH®; Design : 21 TPS62150RGTR TPS62150RGTR 3.4V-9V to 3.30V @ 0.15A; VinMin = 3.4V VinMax = 9.0V Vout = 3.3V Iout = 0.2A; Device = TPS62150RGTR Topology = Buck Created = 2021-04-29 08:46:21.456 BOM Cost = $2.19 BOM Count = 8 Total Pd = 0.07W; Cin 10.0 µF 4.0 mOhm; TPS62150; GND; DEF; FSW; VIN; VOS; Rfb1 180.0 kOhm 100.0 mW; Css 390.0 pF 1.0 mOhm; Rpg 100.0 kOhm 63.0 mW; Vout = 3.3V Iout = 0.2A; Rfb2 562.0 kOhm 63.0 mW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

Design Report TPS62150RGTR : TPS62150RGTR 3.4V-9V to 3.30V @ 0.15A April 29, 2021 08:49:48 GMT-07:00

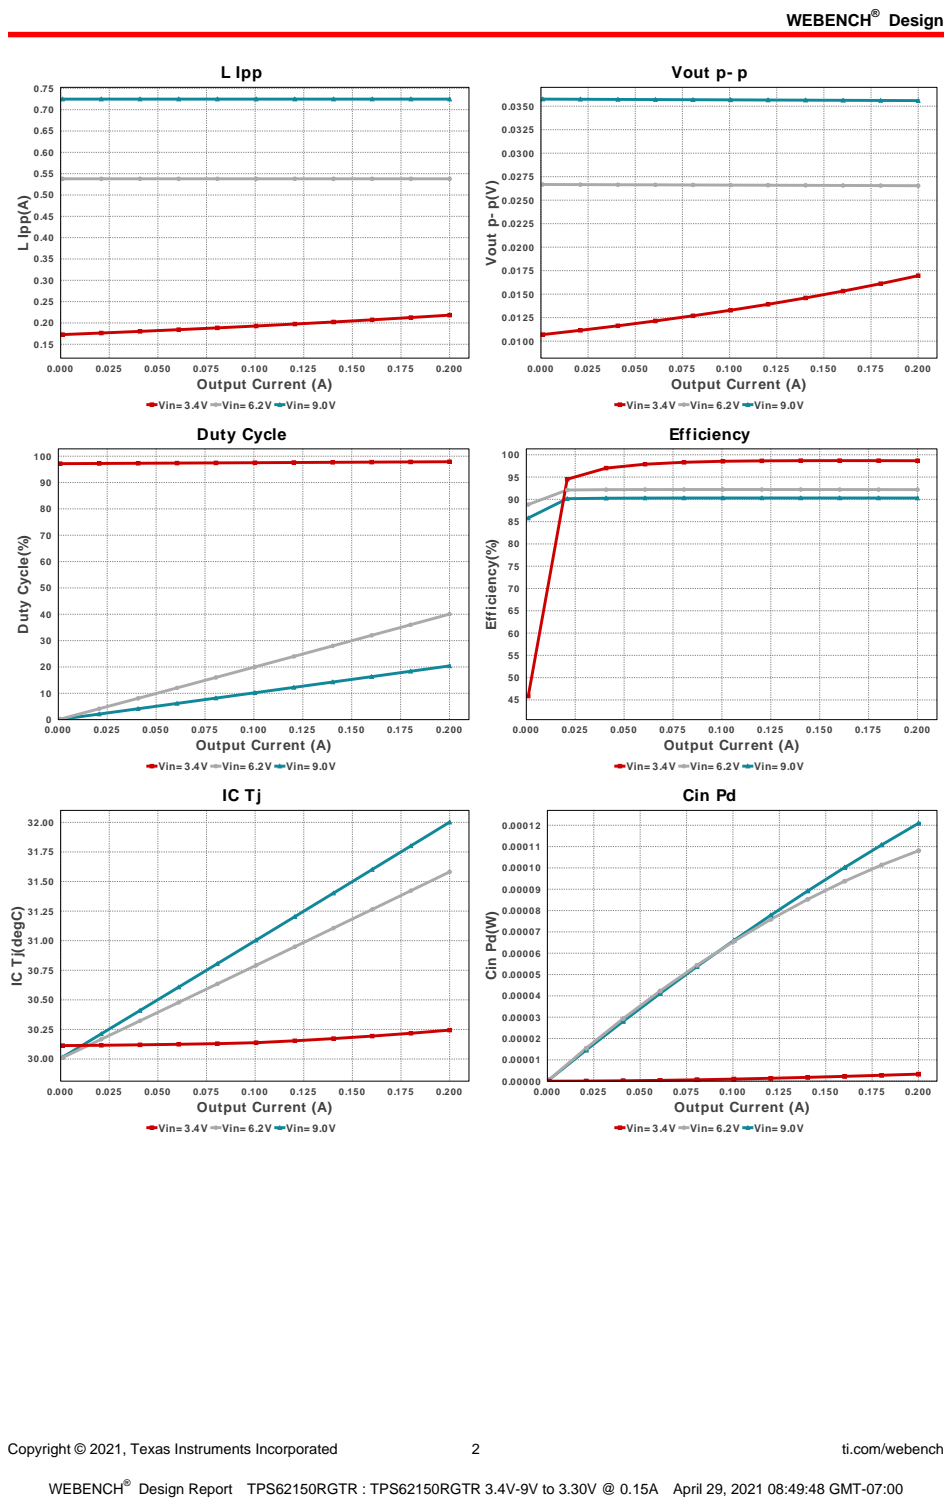
[picture p36: page 2]
Design; Copyright © 2021, Texas Instruments Incorporated; ti.com/webench; L Ipp; 0.200 Output Current (A); L Ipp(A); Vout p- p; Vout p- p(V); Duty Cycle(%); Efficiency(%); Cin Pd(W)

Vin= 3.4V Vin= 6.2V Vin= 9.0V
Duty Cycle

Efficiency

Cin Pd

IC Tj(degC)

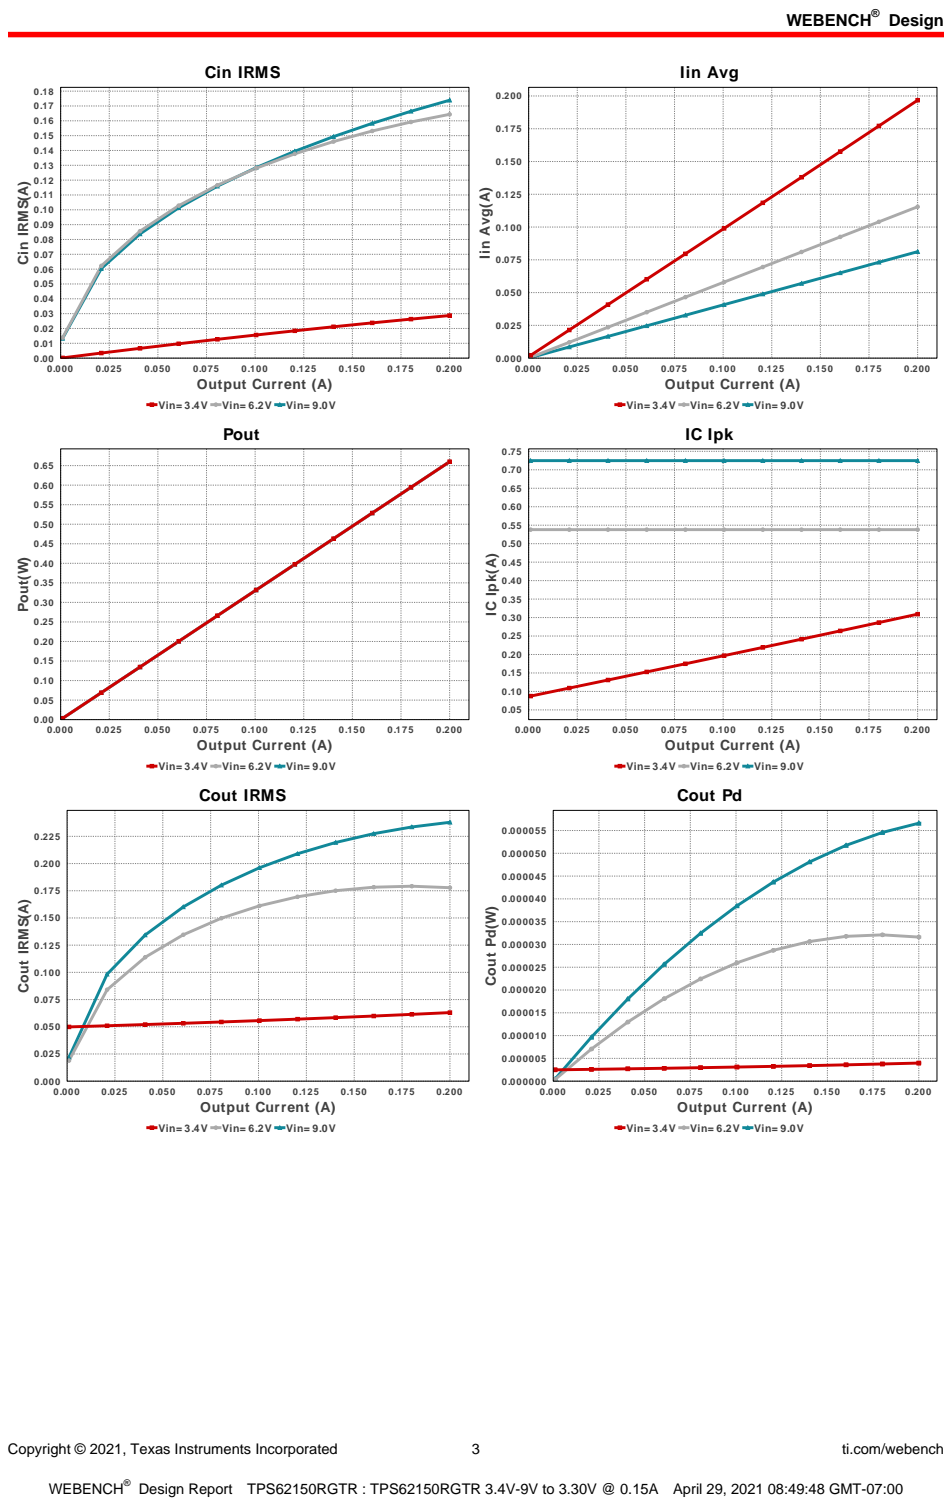
[picture p37: page 3]
Copyright © 2021, Texas Instruments Incorporated; ti.com/webench; Cin IRMS; 0.200 Output Current (A); Cin IRMS(A); Iin Avg; Iin Avg(A); Pout; Pout(W); IC Ipk; IC Ipk(A); Cout IRMS(A); Cout Pd(W)

Vin= 3.4V Vin= 6.2V Vin= 9.0V

Cout IRMS

Cout Pd

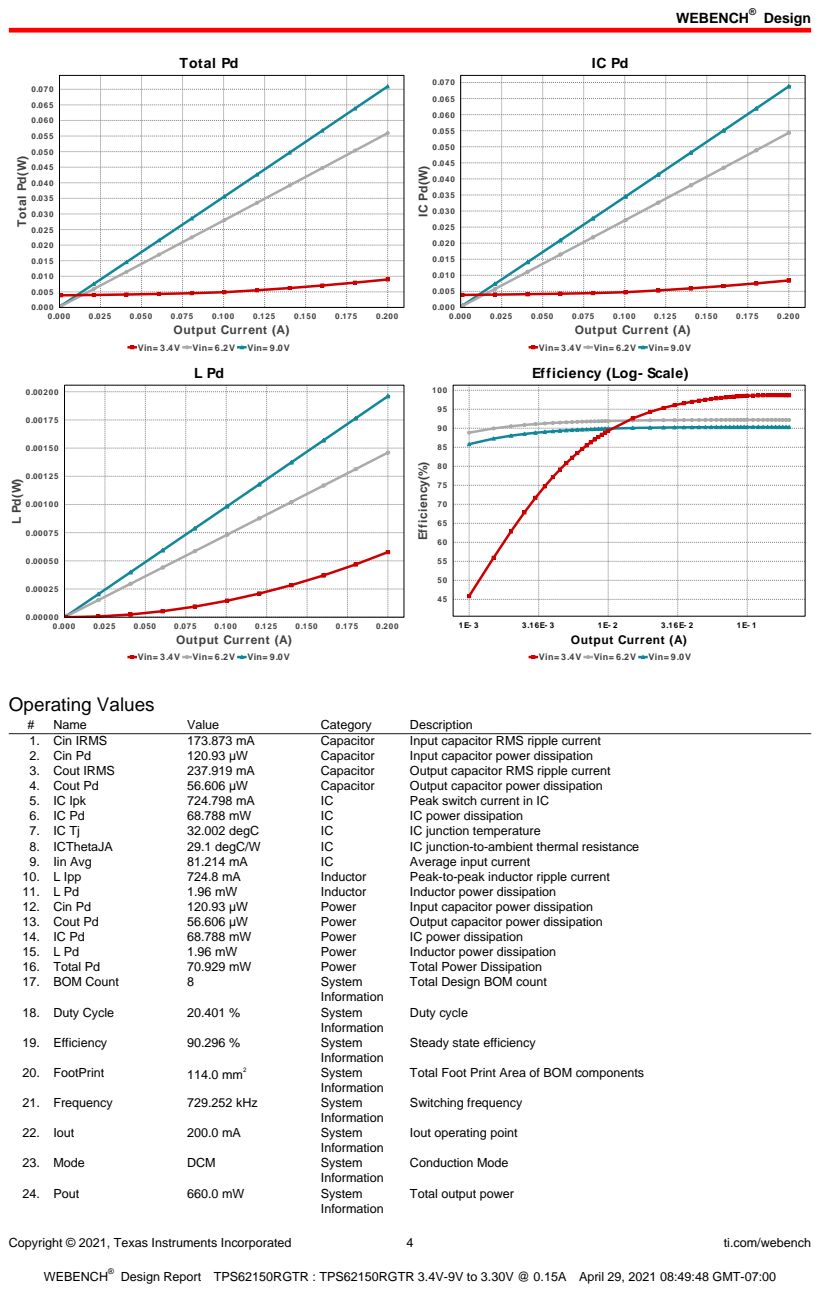
[picture p38: page 4]
Copyright © 2021, Texas Instruments Incorporated; ti.com/webench; Total Pd; 0.200 Output Current (A); Total Pd(W); 1E- 1 Output Current (A); Efficiency(%); Operating Values; Name; Value; Category; Description; 1. Cin IRMS; Capacitor; Input capacitor RMS ripple current; 2. Cin Pd; Input capacitor power dissipation; 3. Cout IRMS; Output capacitor RMS ripple current; 4. Cout Pd; Output capacitor power dissipation; 5. IC Ipk; Peak switch current in IC; IC power dissipation; 32.002 degC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

Vin= 3.4V Vin= 6.2V Vin= 9.0V

Efficiency (Log- Scale)

Total Design BOM count

Steady state efficiency

Total Foot Print Area of BOM components

Iout operating point

Total output power

Copyright © 2021, Texas Instruments Incorporated | 5 | ti.com/webench
# | Name | Value | Category | Description

25. Total BOM | $2.19 | System
| | | Information | Total BOM Cost
26. Vin | 9.0 V | System
| | | Information | Vin operating point
27. Vout | 3.3 V | System
| | | Information | Operational Output Voltage
28. Vout Actual | 3.298 V | System
| | | Information | Vout Actual calculated based on selected voltage divider resistors
29. Vout Tolerance | 3.358 % | System
| | | Information | Vout Tolerance based on IC Tolerance (full load) and voltage divider resistors if applicable
30. Vout p-p | 35.595 mV | System
| | | Information | Peak-to-peak output ripple voltage

## Design Inputs

Name | Value | Description
| Iout | | 200.0 m | Maximum Output Current
VinMax | 9.0 | Maximum input voltage
VinMin | 3.4 | Minimum input voltage
Vout | 3.3 | Output Voltage
| base_pn | | TPS62150 | Base Product Number
source | DC | Input Source Type
Ta | 30.0 | Ambient temperature


Copyright © 2021, Texas Instruments Incorporated | 6 | ti.com/webench

## Assembly

## Component Testing

Some published data on components in datasheets such as Capacitor ESR and Inductor DC resistance is based on conservative values that will guarantee that the components always exceed the specification. For design purposes it is usually better to work with typical values. Since this data is not always available it is a good practice to measure the Capacitance and ESR values of Cin and Cout, and the inductance and DC resistance of L1 before assembly of the board. Any large discrepancies in values should be electrically simulated in WEBENCH to check for instabilities and thermally simulated in WebTHERM to make sure critical temperatures are not exceeded.

## Soldering Component to Board

If board assembly is done in house it is best to tack down one terminal of a component on the board then solder the other terminal. For surface mount parts with large tabs, such as the DPAK, the tab on the back of the package should be pre-tinned with solder, then tacked into place by one of the pins. To solder the tab town to the board place the iron down on the board while resting against the tab, heating both surfaces simultaneously. Apply light pressure to the top of the plastic case until the solder flows around the part and the part is flush with the PCB. If the solder is not flowing around the board you may need a higher wattage iron (generally 25W to 30W is enough).

## Initial Startup of Circuit

It is best to initially power up the board by setting the input supply voltage to the lowest operating input voltage 3.4V and set the input supply's current limit to zero. With the input supply off connect up the input supply to Vin and GND. Connect a digital volt meter and a load if needed to set the minimum Iout of the design from Vout and GND. Turn on the input supply and slowly turn up the current limit on the input supply. If the voltage starts to rise on the input supply continue increasing the input supply current limit while watching the output voltage. If the current increases on the input supply, but the voltage remains near zero, then there may be a short or a component misplaced on the board. Power down the board and visually inspect for solder bridges and recheck the diode and capacitor polarities. Once the power supply circuit is operational then more extensive testing may include full load testing, transient load and line tests to compare with simulation results.

## Load Testing

The setup is the same as the initial startup, except that an additional digital voltmeter is connected between Vin and GND, a load is connected between Vout and GND and a current meter is connected in series between Vout and the load. The load must be able to handle at least rated output power + 50% ( 7.5 watts for this design). Ideally the load is supplied in the form of a variable load test unit. It can also be done in the form of suitably large power resistors. When using an oscilloscope to measure waveforms on the prototype board, the ground leads of the oscilloscope probes should be as short as possible and the area of the loop formed by the ground lead should be kept to a minimum. This will help reduce ground lead inductance and eliminate EMI noise that is not actually present in the circuit.

## Design Assistance

1. Feature Highlights: DCS-Control(TM) Architecture with upto 1A output current, 3V to 17V Input Voltage Range, Adjustable output voltage from 0.9V to 6VSelectable operating frequency, Optional Softstart Capacitor for slow startup, Tracking,Pin selectable output voltage (nominal, +5%) Seamless Power Save Mode for Light Load Efficiency, Power Good Output, 100% Duty Cycle mode, Short Circuit Protection, Thermal Shutdown
2. Master key : 037E22F8EF040D24[v1]
3. TPS62150 Product Folder : http://www.ti.com/product/TPS62150 : contains the data sheet and other resources.

Copyright © 2021, Texas Instruments Incorporated | 7 | ti.com/webench

Important Notice and Disclaimer

TI provides technical and reliability data (including datasheets), design resources (including reference designs), application or other design advice, web tools, safety information, and other resources AS IS and with all faults, and disclaims all warranties. These resources are intended for skilled developers designing with TI products. You are solely responsible for (1) selecting the appropriate TI products for your application, (2) designing, validating and testing your application, and (3) ensuring your application meets applicable standards, and any other safety, security, or other requirements.

These resources are subject to change without notice. TI grants you permission to use these resources only for development of an application that uses the TI products described in the resource. Other reproduction and display of these resources is prohibited. No license is granted to any other TI intellectual property right or to any third party intellectual property right. TI disclaims responsibility for, and you will fully indemnify TI and its representatives against, any claims, damages, costs, losses, and liabilities arising out of your use of these resources.

Providing these resources does not expand or otherwise alter TI's applicable Terms of Sale or other applicable terms available either on ti.com or provided in conjunction with TI products.
