ChrisHayward-dev/SapphireKicad/SapphireMini_Review1 PCB.pdf

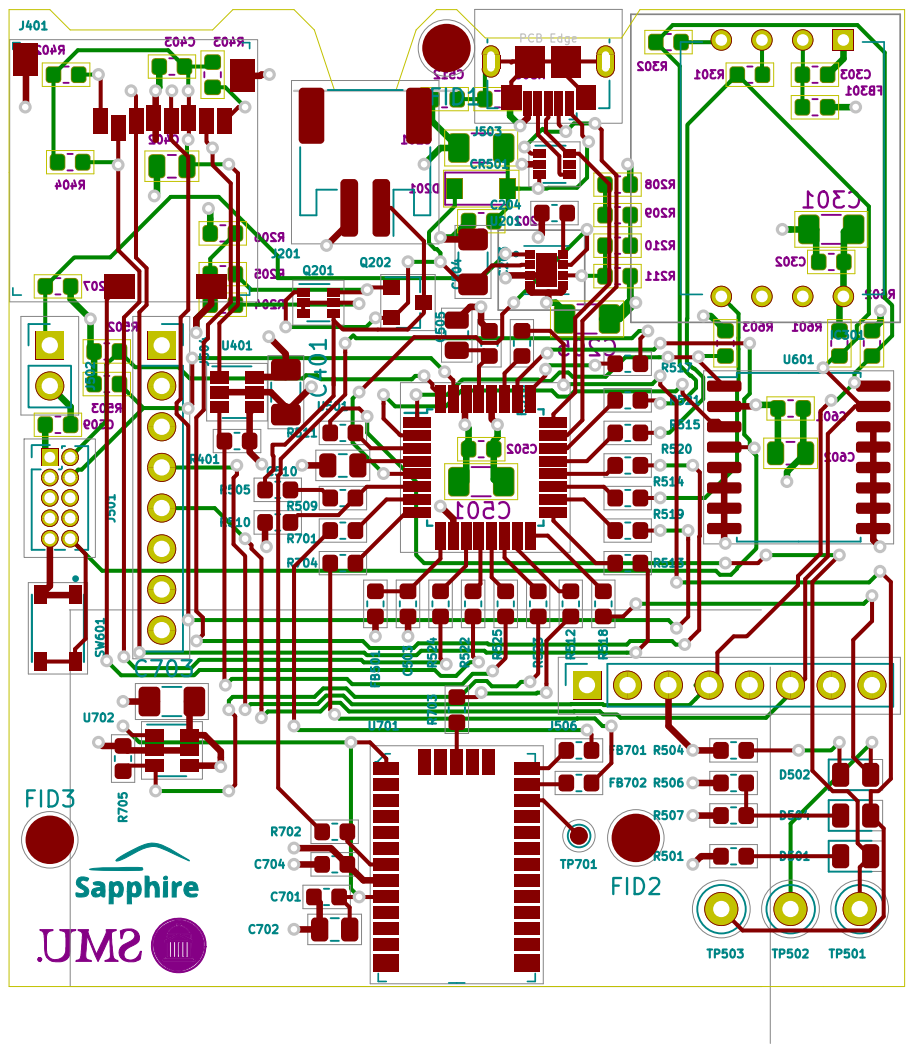
[picture p47: page 1]
