ChrisHayward-dev/SapphireKicad/SapphineMinimal.kicad_pcb

## KiCad design SapphineMinimal.kicad_pcb (2024-02-04)

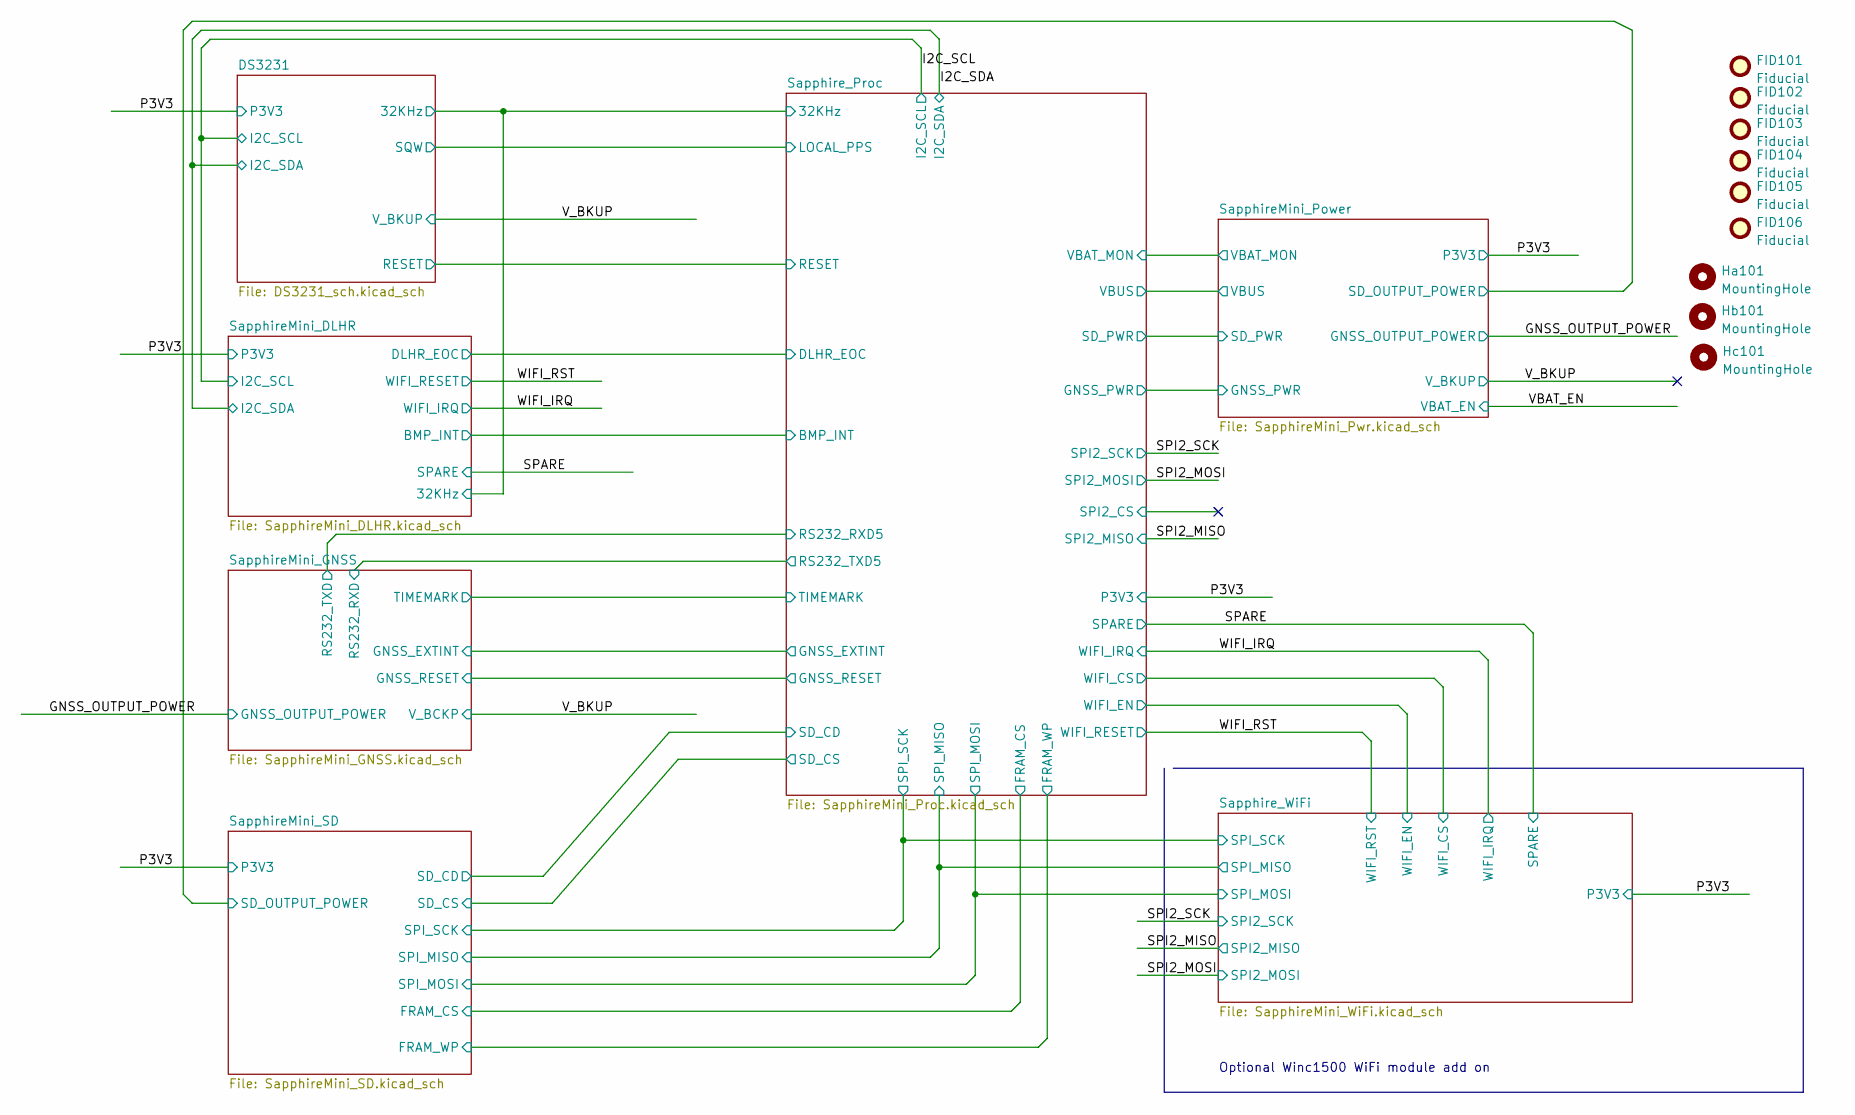
[picture p55: schematic SapphineMinimal.kicad_sch, Sapphire Mini M2]

Parts:
FID101, FID102, FID103, FID104, FID105, FID106: Fiducial; Fiducial_0.5mm_Mask1mm
Ha101: MountingHole; MountingHole_3.2mm_M3
Hb101: MountingHole; MountingHole_3.2mm_M3
Hc101: MountingHole; MountingHole_3.2mm_M3

Notes on the sheet:
Optional Winc1500 WiFi module add on

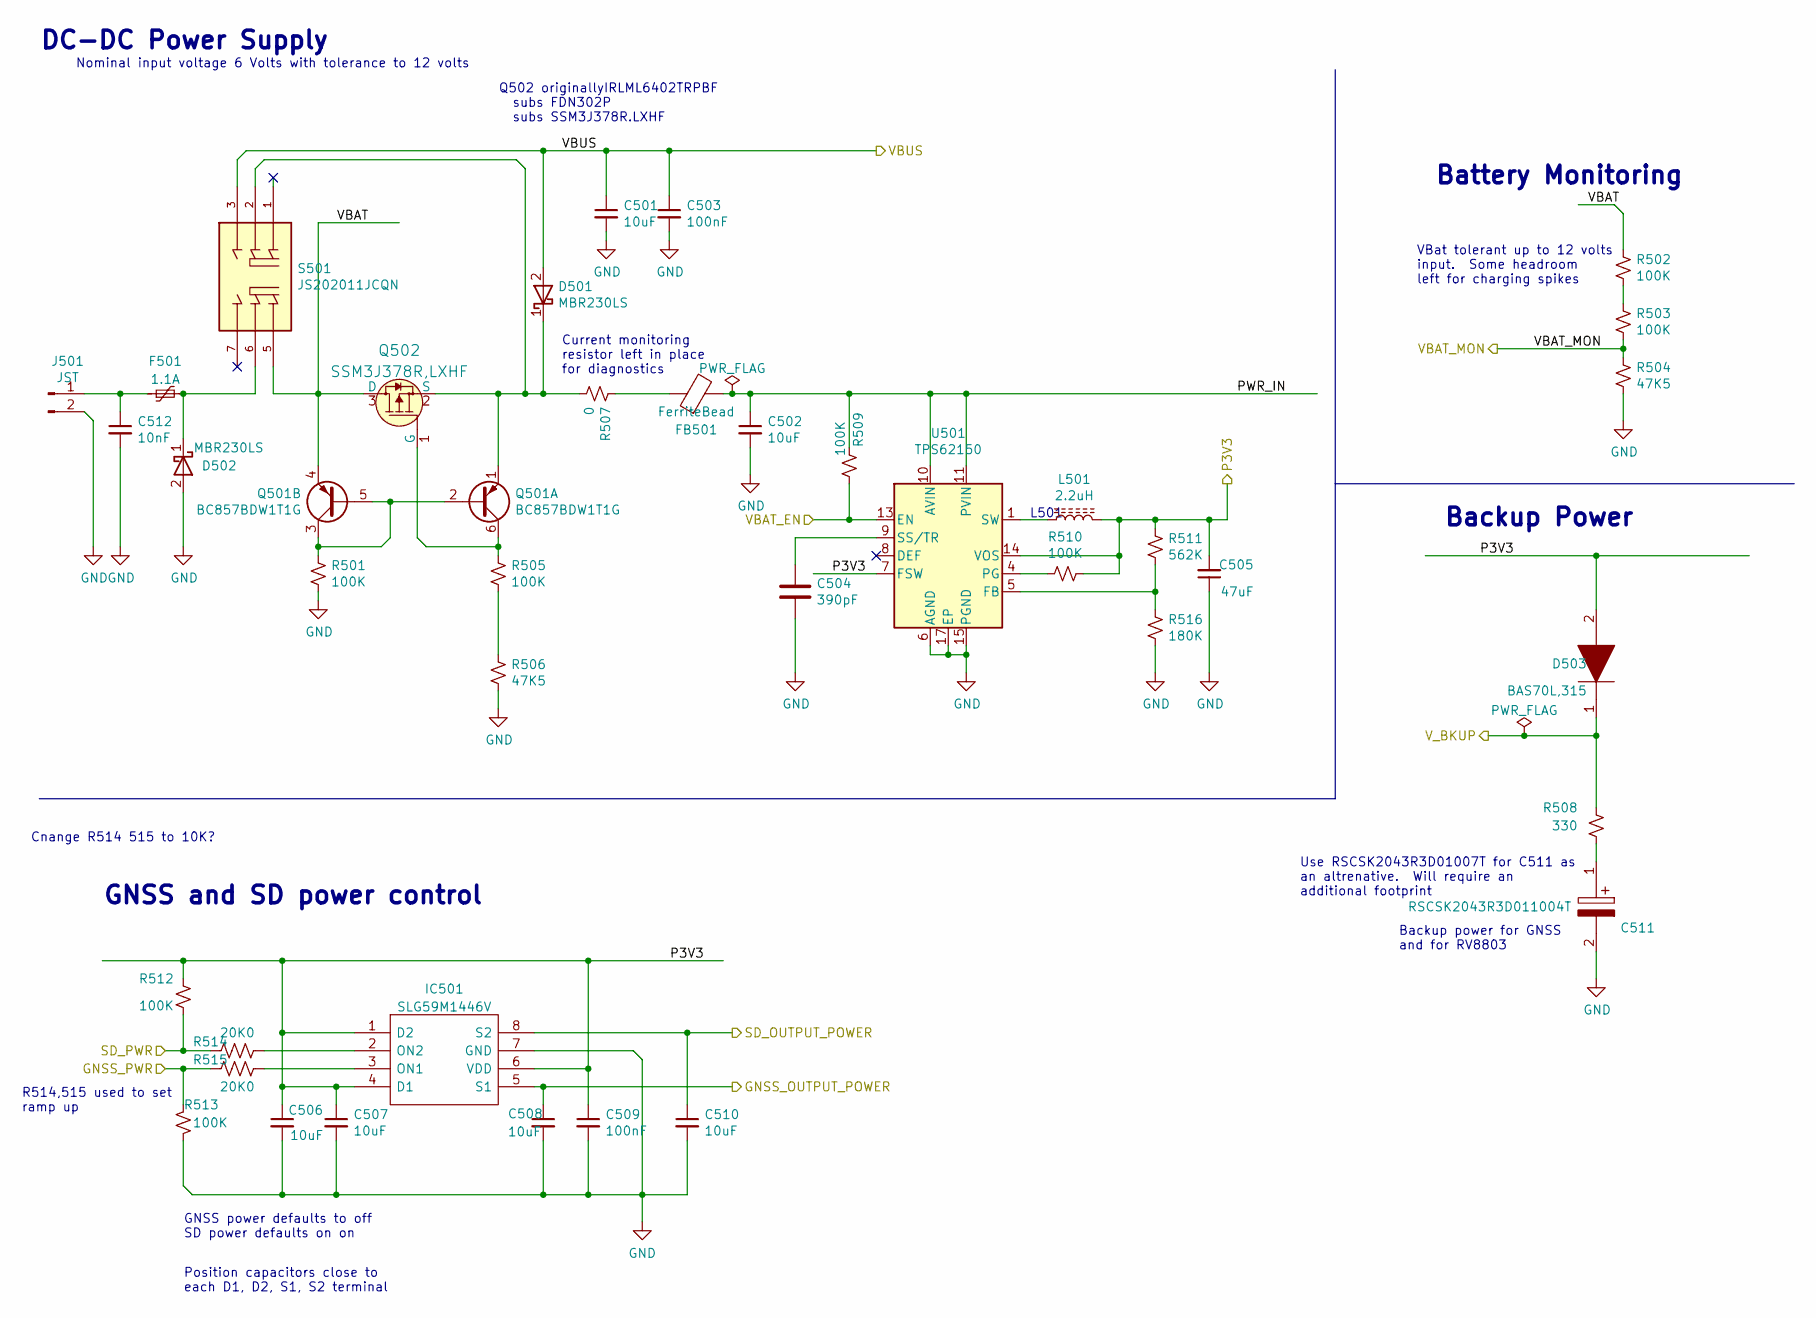
[picture p56: schematic SapphireMini_Pwr.kicad_sch, Sapphire Mini M2]

Parts:
C501, C506, C507, C508, C510: 10uF; C_0805_2012Metric; Voltage Rating (DC) 25 volt; Voltage 25; MPN CL21A106KAYNNNE; Digi-Key_PN 490-10748-1-ND
C502: 10uF; C_0805_2012Metric; Voltage Rating (DC) 16 volt; Voltage 16; MPN GRM21BR61E106MA73L; Digi-Key_PN 490-10748-1-ND
C503, C509: 100nF; C_0402_1005Metric; Tolerance 10%; Voltage 25; MPN CL05A104KA5NNNC; DigiKey Price 0.10
C504: 390pF; C_0603_1608Metric; MPN CL10C391JB81PNC; Digi-Key_PN 1276-2284-1-ND
C505: 47uF; C_1210_3225Metric; Voltage Rating (DC) 16 volt; Voltage 16; MPN CL32A476KOJNNNE; Digi-Key_PN 490-10748-1-ND
C511: RSCSK2043R3D011004T; RSCSK2043R3D01004T; Mouser Part Number 80-FC0H224ZFTBR24
C512: 10nF; C_0402_1005Metric; Tolerance 10%; Voltage 25; MPN CL05B103KB5NNNC; DigiKey Price 0.10
D501, D502: MBR230LS; D_SOD-123; MPN MBR230LS; DigiKey Price 0.29
D503: BAS70L,315; PESD5V0S1BL315; Mouser Part Number 771-BAS70L315
F501: 1.1A; R_1812_4532Metric; MPN 0ZCG0110CF2B
FB501: FerriteBead; L_0603_1608Metric; MPN BLM18AG221SN1D
IC501: SLG59M1446V; Manufacturer_Part_Number SLG59M1446V
J501: JST; JST_PH_S2B-PH-SM4-TB_1x02-1MP_P2.00mm_Horizontal; MPN JST S2B-PH-SM4-TB(LF)(SN); DigiKey Price 0.58
L501: 2.2uH; 74439344022; MPN 74439344022; Digi-Key_PN 732-10701-1-ND
Q501: BC857BDW1T1G; SOT-363_SC-70-6; MPN BC857BDW1T1G; DigiKey Price 0.24
Q502: SSM3J378R,LXHF; SOT-23-3; MPN SSM3J378R,LXHF; Digi-Key_PN IRLML6402PBFCT-ND
R501, R502, R503, R505, R509, R512, R513: 100K; R_0603_1608Metric; Tolerance 5%; MPN CRCW0603100KFKEAC; DigiKey Price 0.05
R504, R506: 47K5; R_0603_1608Metric; Tolerance 1%; MPN CRCW060347K5FKEAC; DigiKey Price 0.10
R507: 0; R_0603_1608Metric; MPN RMCF0603ZT0R00; Digi-Key_PN WSLJ-.1CT-ND
R508: 330; R_0603_1608Metric; Tolerance 1%; MPN RC0603JR-07330RL; DigiKey Price 0.10
R510: 100K; R_0603_1608Metric; MPN CRCW0603100KFKEAC; Digi-Key_PN 541-3950-1-ND
R511: 562K; R_0603_1608Metric; MPN CRCW0603562KFKEA; Digi-Key_PN 541-562KHCT-ND
R514, R515: 20K0; R_0603_1608Metric; MPN RMCF0603FT20K0
R516: 180K; R_0603_1608Metric; MPN CRCW0603180KFKEAC; Digi-Key_PN 541-5203-1-ND
S501: JS202011JCQN; SW_JS202011JCQN_handSolder; PARTREV 11 Nov 19; Digi-Key_PN CKN10723CT-ND
U501: TPS62150; VQFN-16-1EP_3x3mm_P0.5mm_EP1.68x1.68mm_ThermalVias; MPN TPS62150RGTT; Digi-Key_PN 296-30007-1-ND

Connections:
/GNSS_OUTPUT_POWER: C508.1, IC501.5 (S1); also elsewhere on the board
/P3V3: C505.2, C506.1, C507.1, C509.1, D503.2, IC501.1 (D2), IC501.4 (D1), IC501.6 (VDD), L501.2, R510.1, R511.1, R512.1, U501.7 (FSW), U501.14 (VOS); also elsewhere on the board
/SapphireMini_Power/GNSS_PWR: R513.1, R515.1; also elsewhere on the board
/SapphireMini_Power/PWR_IN: C502.1, FB501.2, R509.1, U501.10 (AVIN), U501.11 (PVIN), U501.12 (PVIN)
/SapphireMini_Power/SD_OUTPUT_POWER: C510.1, IC501.8 (S2); also elsewhere on the board
/SapphireMini_Power/SD_PWR: R512.2, R514.1; also elsewhere on the board
/SapphireMini_Power/VBAT: Q501.4 (E2), Q502.3 (D), R502.1, S501.5
/SapphireMini_Power/VBAT_MON: R503.2, R504.1; also elsewhere on the board
/SapphireMini_Power/VBUS: C501.1, C503.1, D501.2 (A), S501.3; also elsewhere on the board
/VBAT_EN: R509.2, U501.13 (EN)
/V_BKUP: D503.1, R508.2; also elsewhere on the board
GND: C501.2, C502.2, C503.2, C504.2, C505.1, C506.2, C507.2, C508.2, C509.2, C510.2, C511.2, C512.2, D502.2 (A), IC501.7 (GND), J501.2, R501.2, R504.2, R506.2, R513.2, R516.2, U501.6 (AGND), U501.15 (PGND), U501.16 (PGND), U501.17 (EP); also elsewhere on the board
unnamed: C504.1, U501.9 (SS/TR)
unnamed: C511.1, R508.1
unnamed: C512.1, F501.1, J501.1
unnamed: D501.1 (K), Q501.1 (E1), Q502.2 (S), R507.1, S501.2
unnamed: D502.1 (K), F501.2, S501.6
unnamed: FB501.1, R507.2
unnamed: IC501.2 (ON2), R514.2
unnamed: IC501.3 (ON1), R515.2
unnamed: L501.1, U501.1 (SW), U501.2 (SW), U501.3 (SW)
unnamed: Q501.2 (B1), Q501.3 (C2), Q501.5 (B2), R501.1
unnamed: Q501.6 (C1), Q502.1 (G), R505.1
unnamed: R502.2, R503.1
unnamed: R505.2, R506.1
unnamed: R510.2, U501.4 (PG)
unnamed: R511.2, R516.1, U501.5 (FB)

Notes on the sheet:
L501
R514,515 used to set ramp up
Current monitoring resistor left in place for diagnostics
GNSS power defaults to off SD power defaults on on
DC-DC Power Supply
VBat tolerant up to 12 volts input. Some headroom left for charging spikes
Battery Monitoring
Position capacitors close to each D1, D2, S1, S2 terminal
Nominal input voltage 6 Volts with tolerance to 12 volts
Backup Power
Use RSCSK2043R3D01007T for C511 as an altrenative. Will require an additional footprint
Cnange R514 515 to 10K?
Backup power for GNSS and for RV8803
Q502 originallyIRLML6402TRPBF subs FDN302P subs SSM3J378R.LXHF
GNSS and SD power control

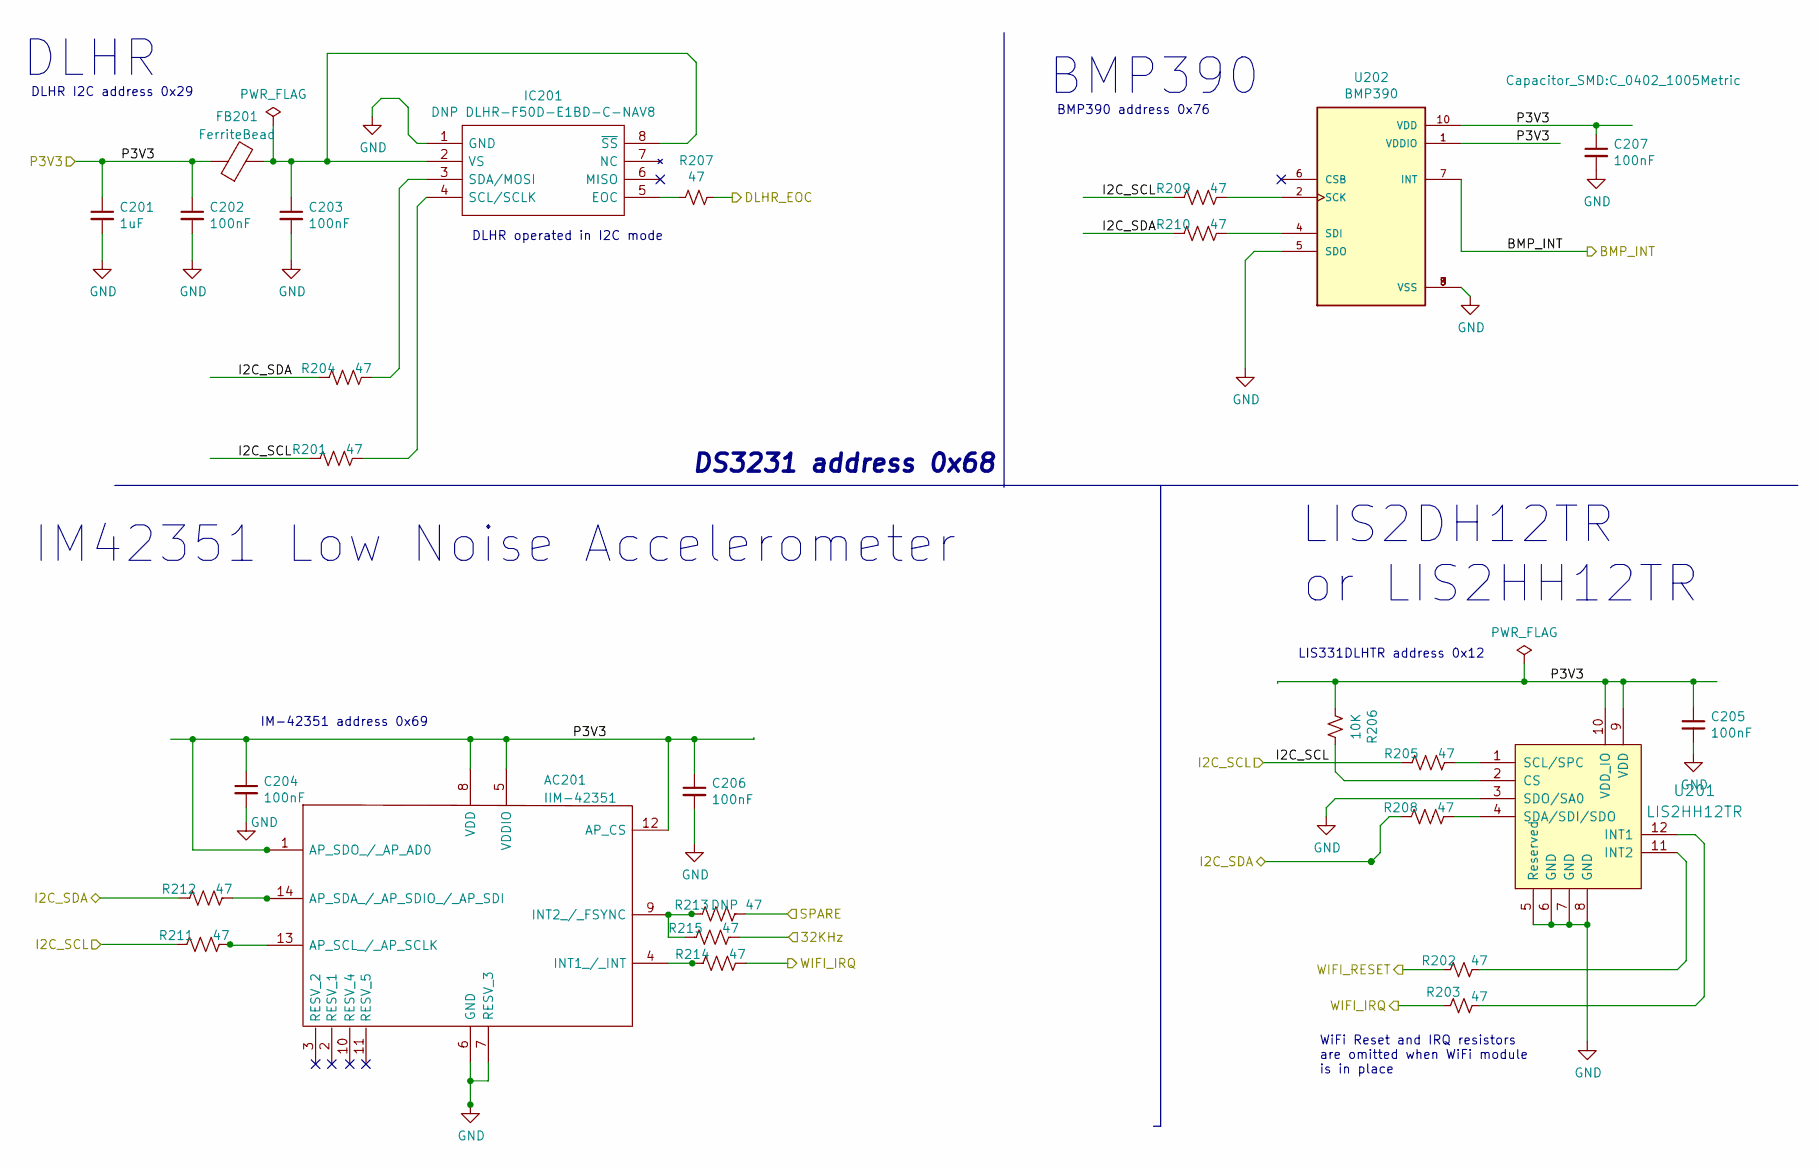
[picture p57: schematic SapphireMini_DLHR.kicad_sch, Sapphire Mini M2]

Parts:
AC201: IIM-42351; IIM42352; Manufacturer_Part_Number IIM-42351; Mouser Part Number 410-IIM-42351
C201: 1uF; C_0805_2012Metric; Tolerance 10%; Voltage 16; MPN CL21B105KOFNNNG; DigiKey Price 0.06
C202, C203, C204, C205, C206, C207: 100nF; C_0402_1005Metric; Tolerance 10%; Voltage 25; MPN CL05A104KA5NNNC; DigiKey Price 0.10
FB201: FerriteBead; L_0603_1608Metric; MPN BLM18AG221SN1D
IC201: DNP DLHR-F50D-E1BD-C-NAV8; DLHRF50DE1BDCNAV8; Manufacturer_Part_Number DLHR-F50D-E1BD-C-NAV8; Mouser Part Number 683-LHRF50DE1BDCNAV8
R201, R204, R205, R208, R209, R210, R211, R212, R214, R215: 47; R_0603_1608Metric; MPN CRCW060347R0FKEAC
R202, R203, R207: 47; R_0603_1608Metric; Tolerance 5%; MPN CRCW060347R0FKEAC; DigiKey Price 0.05
R206: 10K; R_0603_1608Metric; Tolerance 5%; MPN CRCW060310K0FKEAC; DigiKey Price 0.05
R213: DNP 47; R_0603_1608Metric; MPN CRCW060347R0FKEAC
U201: LIS2HH12TR; LIS2DH12TR; MPN LIS2DH12TR; Digi-Key_PN 497-14851-1-ND
U202: BMP390; BMP388; PARTREV 1.1; Digi-Key_PN 828-1079-1-ND

Connections:
/DS3231/32KHz: R215.1; also elsewhere on the board
/I2C_SCL: R201.2, R205.2, R209.2, R211.2; also elsewhere on the board
/I2C_SDA: R204.2, R208.2, R210.2, R212.2; also elsewhere on the board
/P3V3: AC201.1 (AP_SDO_/_AP_AD0), AC201.5 (VDDIO), AC201.8 (VDD), AC201.12 (AP_CS), C201.1, C202.1, C204.1, C205.1, C206.1, C207.1, FB201.1, R206.2, U201.9 (VDD), U201.10 (VDD_IO), U202.1 (VDDIO), U202.10 (VDD); also elsewhere on the board
/SPARE: R213.1; also elsewhere on the board
/SapphireMini_DLHR/BMP_INT: U202.7 (INT); also elsewhere on the board
/SapphireMini_DLHR/DLHR_EOC: R207.1; also elsewhere on the board
/WIFI_IRQ: R203.2, R214.1; also elsewhere on the board
/WIFI_RST: R202.2; also elsewhere on the board
GND: AC201.6 (GND), AC201.7 (RESV_3), C201.2, C202.2, C203.2, C204.2, C205.2, C206.2, C207.2, IC201.1 (GND), U201.3 (SDO/SA0), U201.5 (Reserved), U201.6 (GND), U201.7 (GND), U201.8 (GND), U202.3 (VSS), U202.5 (SDO), U202.8 (VSS), U202.9 (VSS); also elsewhere on the board
unnamed: AC201.4 (INT1_/_INT), R214.2
unnamed: AC201.9 (INT2_/_FSYNC), R213.2, R215.2
unnamed: AC201.13 (AP_SCL_/_AP_SCLK), R211.1
unnamed: AC201.14 (AP_SDA_/_AP_SDIO_/_AP_SDI), R212.1
unnamed: C203.1, FB201.2, IC201.2 (VS), IC201.8 (~SS)
unnamed: IC201.3 (SDA/MOSI), R204.1
unnamed: IC201.4 (SCL/SCLK), R201.1
unnamed: IC201.5 (EOC), R207.2
unnamed: R202.1, U201.11 (INT2)
unnamed: R203.1, U201.12 (INT1)
unnamed: R205.1, U201.1 (SCL/SPC)
unnamed: R206.1, U201.2 (CS)
unnamed: R208.1, U201.4 (SDA/SDI/SDO)
unnamed: R209.1, U202.2 (SCK)
unnamed: R210.1, U202.4 (SDI)

Notes on the sheet:
IM-42351 address 0x69
BMP390 address 0x76
LIS2DH12TR
LIS331DLHTR address 0x12
or LIS2HH12TR
DLHR operated in I2C mode
BMP390
DLHR
DS3231 address 0x68
IM42351 Low Noise Accelerometer
WiFi Reset and IRQ resistors are omitted when WiFi module is in place
DLHR I2C address 0x29

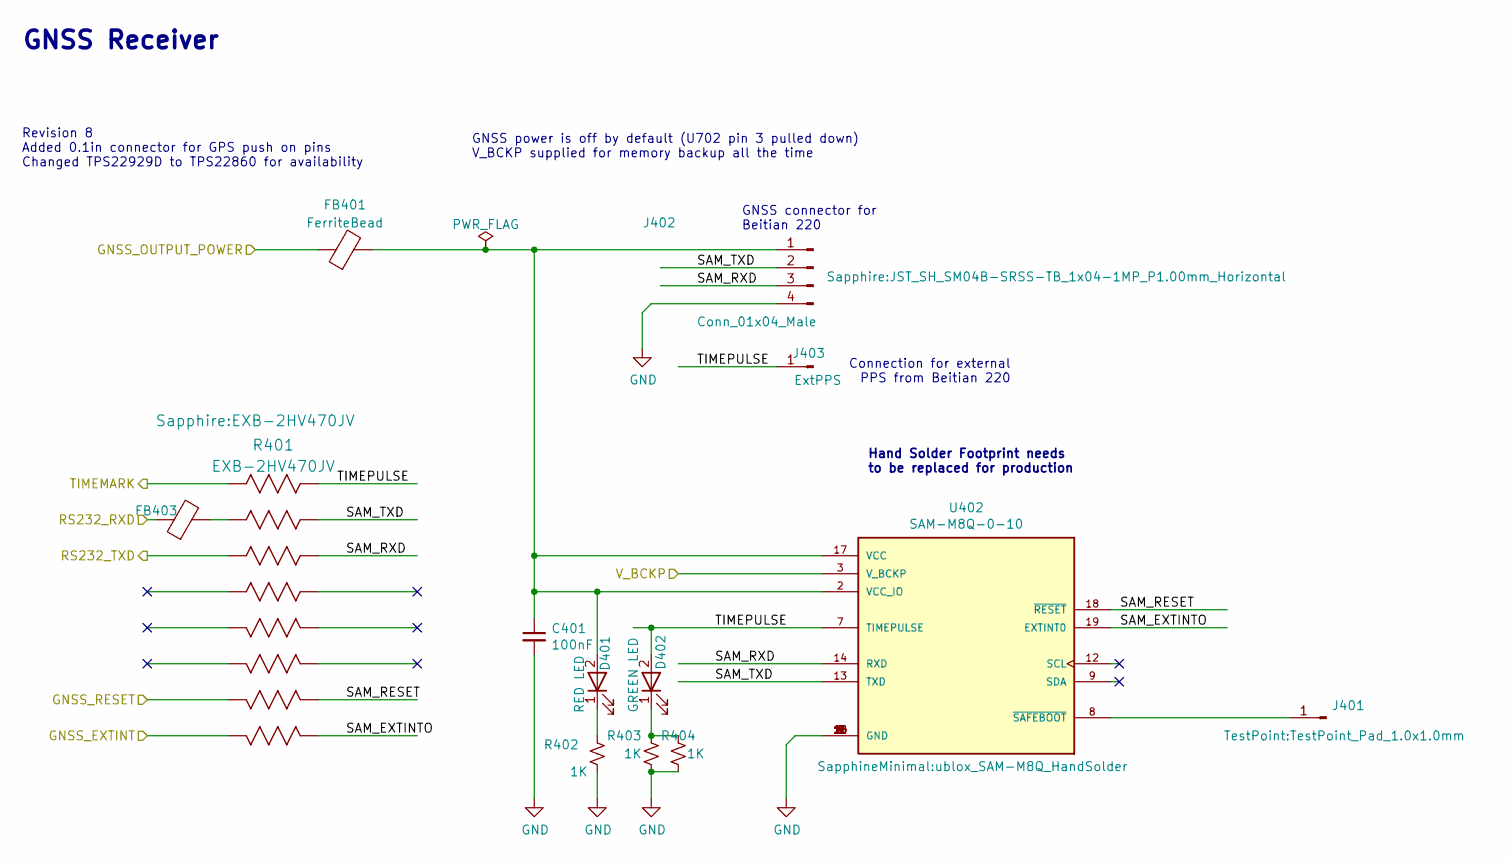
[picture p58: schematic SapphireMini_GNSS.kicad_sch, Sapphire Mini M2]

Parts:
C401: 100nF; C_0402_1005Metric; Tolerance 10%; Voltage 25; MPN CL05A104KA5NNNC; DigiKey Price 0.10
D401: RED LED; LED_0805_2012Metric; MPN LTST-S220KRKT; DigiKey Price 0.28
D402: GREEN LED; LED_0805_2012Metric; MPN LTST-S220KGKT; DigiKey Price 0.28
FB401, FB403: FerriteBead; L_0603_1608Metric; MPN BLM18AG221SN1D
J401: DNP Conn_01x01_Male; TestPoint_Pad_1.0x1.0mm; MPN DNP
J402: Conn_01x04_Male; JST_SH_SM04B-SRSS-TB_1x04-1MP_P1.00mm_Horizontal; MPN SM04B-SRSS-TB(LF)(SN); Digi-Key_PN 455-1804-1-ND
J403: ExtPPS; TestPoint_Pad_1.5x1.5mm
R401: EXB-2HV470JV; MPN EXB-2HV470JV
R402, R403, R404: 1K; R_0603_1608Metric; Tolerance 5%; MPN CRCW06031K00FKEAC; DigiKey Price 0.05
U402: SAM-M8Q-0-10; ublox_SAM-M8Q_HandSolder; PARTREV R07

Connections:
/GNSS_OUTPUT_POWER: FB401.1; also elsewhere on the board
/SapphireMini_GNSS/GNSS_EXTINT: R401.8; also elsewhere on the board
/SapphireMini_GNSS/GNSS_RESET: R401.7; also elsewhere on the board
/SapphireMini_GNSS/RS232_RXD: FB403.1; also elsewhere on the board
/SapphireMini_GNSS/RS232_TXD: R401.3; also elsewhere on the board
/SapphireMini_GNSS/SAM_EXTINTO: R401.9, U402.19 (EXTINT0)
/SapphireMini_GNSS/SAM_RESET: R401.10, U402.18 (~RESET)
/SapphireMini_GNSS/SAM_RXD: J402.3, R401.14, U402.14 (RXD)
/SapphireMini_GNSS/SAM_TXD: J402.2, R401.15, U402.13 (TXD)
/SapphireMini_GNSS/TIMEPULSE: D402.2 (A), J403.1, R401.16, U402.7 (TIMEPULSE)
/Sapphire_Proc/TIMEMARK: R401.1; also elsewhere on the board
/V_BKUP: U402.3 (V_BCKP); also elsewhere on the board
GND: C401.2, J402.4, R402.1, R403.1, R404.1, U402.1 (GND), U402.4 (GND), U402.5 (GND), U402.6 (GND), U402.10 (GND), U402.11 (GND), U402.15 (GND), U402.16 (GND), U402.20 (GND); also elsewhere on the board
unnamed: C401.1, D401.2 (A), FB401.2, J402.1, U402.2 (VCC_IO), U402.17 (VCC)
unnamed: D401.1 (K), R402.2
unnamed: D402.1 (K), R403.2, R404.2
unnamed: FB403.2, R401.2
unnamed: J401.1, U402.8 (~SAFEBOOT)

Notes on the sheet:
Revision 8 Added 0.1in connector for GPS push on pins Changed TPS22929D to TPS22860 for availability
GNSS power is off by default (U702 pin 3 pulled down) V_BCKP supplied for memory backup all the time
Connection for external PPS from Beitian 220
GNSS connector for Beitian 220
GNSS Receiver
Hand Solder Footprint needs to be replaced for production

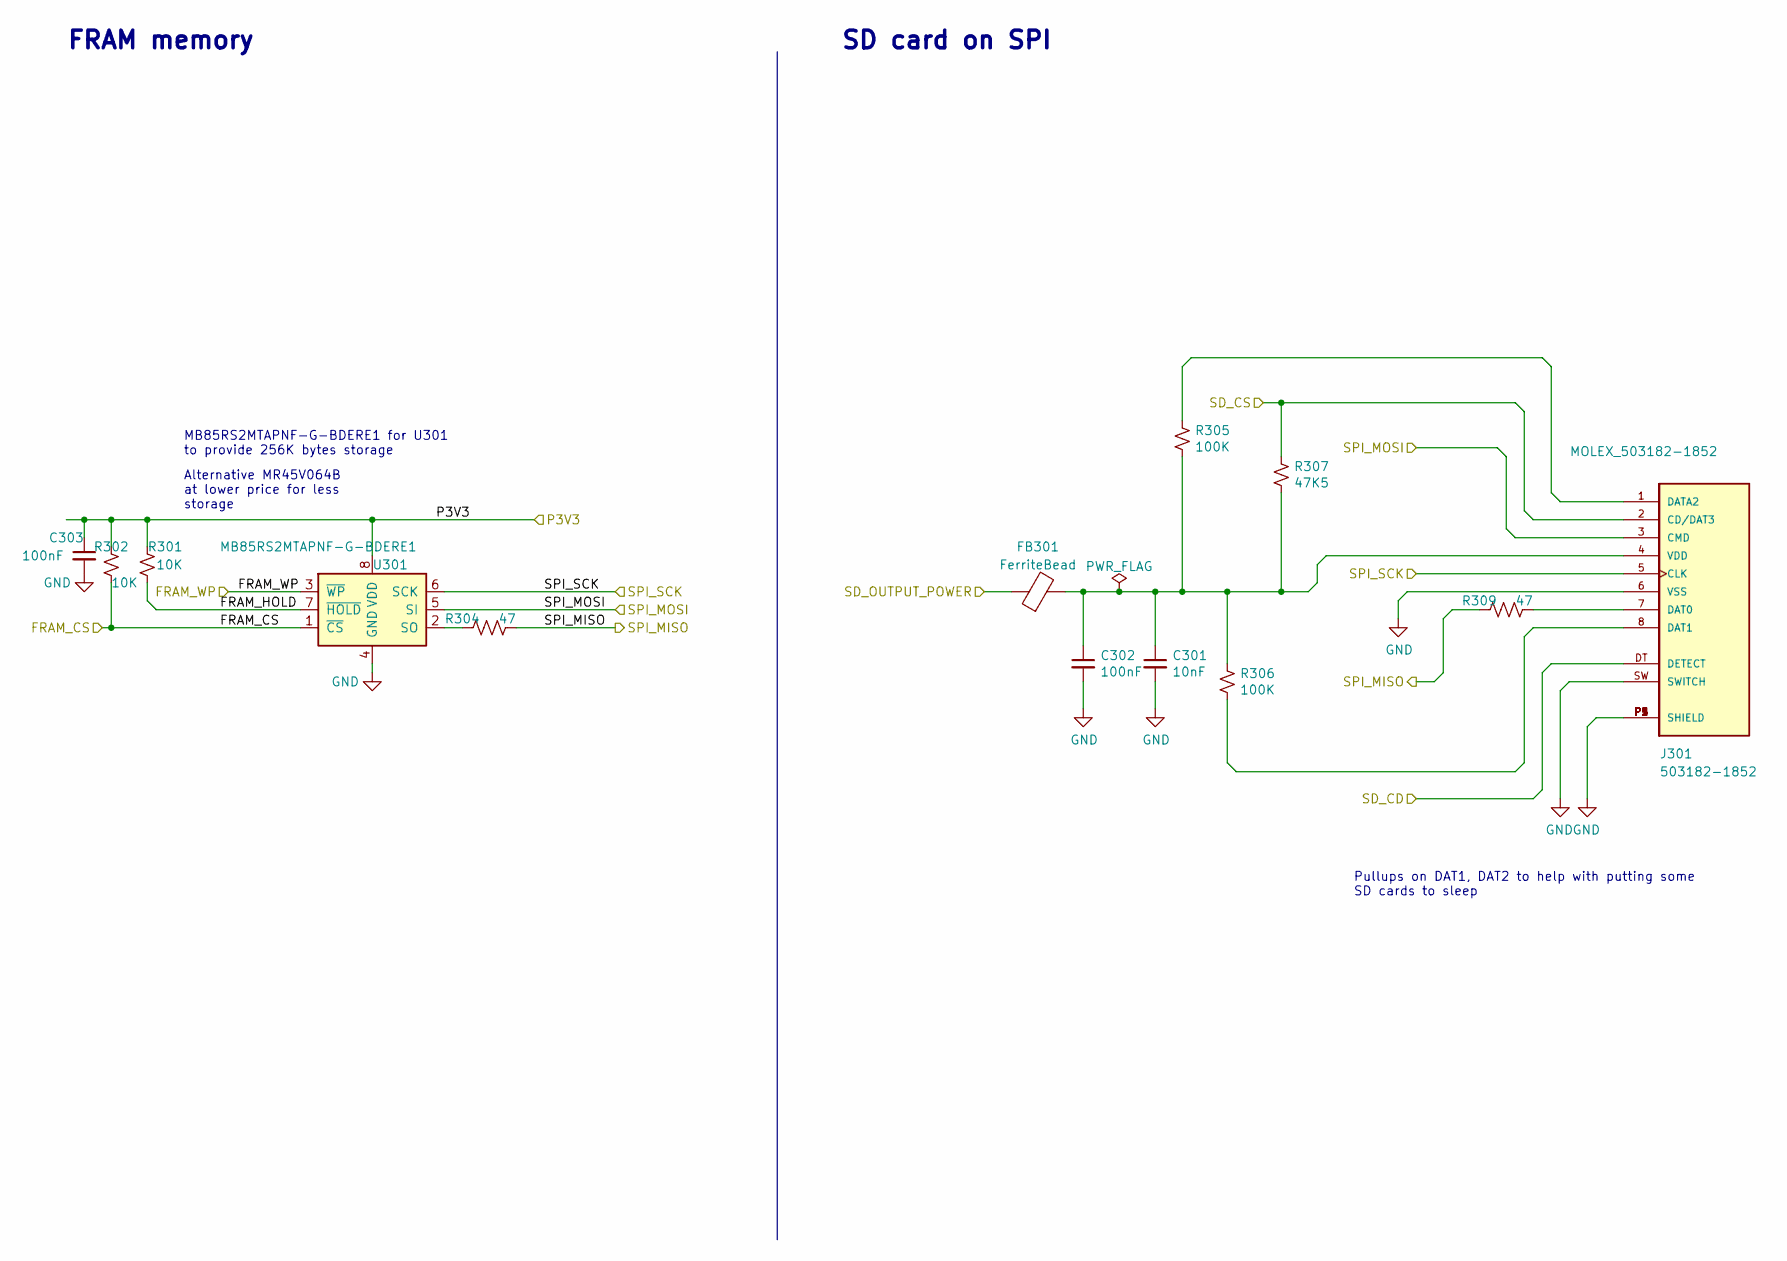
[picture p59: schematic SapphireMini_SD.kicad_sch, Sapphire Mini M2]

Parts:
C301: 10nF; C_0402_1005Metric; Tolerance 10%; Voltage 25; MPN CL05B103KB5NNNC; DigiKey Price 0.10
C302, C303: 100nF; C_0402_1005Metric; Tolerance 10%; Voltage 25; MPN CL05A104KA5NNNC; DigiKey Price 0.10
FB301: FerriteBead; L_0603_1608Metric; MPN BLM18AG221SN1D
J301: 503182-1852; MOLEX_503182-1852; MPN 503182-1852
R301, R302: 10K; R_0603_1608Metric; Tolerance 5%; MPN CRCW060310K0FKEAC; DigiKey Price 0.05
R304, R309: 47; R_0603_1608Metric; MPN CRCW060347R0FKEAC
R305, R306: 100K; R_0603_1608Metric; Tolerance 5%; MPN CRCW0603100KFKEAC; DigiKey Price 0.05
R307: 47K5; R_0603_1608Metric; Tolerance 1%; MPN CRCW060347K5FKEAC; DigiKey Price 0.10
U301: MB85RS2MTAPNF-G-BDERE1; SOP-8_3.9x4.9mm_P1.27mm; MPN MB85RS2MTAPNF-G-BDERE1; Digi-Key_PN MR45V064BMAZAATLCT-ND

Connections:
/P3V3: C303.1, R301.2, R302.2, U301.8 (VDD); also elsewhere on the board
/SapphireMini_Power/SD_OUTPUT_POWER: FB301.1; also elsewhere on the board
/SapphireMini_SD/FRAM_CS: R302.1, U301.1 (~CS); also elsewhere on the board
/SapphireMini_SD/FRAM_HOLD: R301.1, U301.7 (~HOLD)
/SapphireMini_SD/FRAM_WP: U301.3 (~WP); also elsewhere on the board
/SapphireMini_SD/SD_CS: J301.2 (CD/DAT3), R307.2; also elsewhere on the board
/SapphireMini_SD/SPI_MISO: R304.1, R309.2; also elsewhere on the board
/SapphireMini_SD/SPI_MOSI: J301.3 (CMD), U301.5 (SI); also elsewhere on the board
/SapphireMini_SD/SPI_SCK: J301.5 (CLK), U301.6 (SCK); also elsewhere on the board
/Sapphire_Proc/SD_CD: J301.DT (DETECT); also elsewhere on the board
GND: C301.2, C302.2, C303.2, J301.6 (VSS), J301.P1 (SHIELD), J301.P2 (SHIELD), J301.P3 (SHIELD), J301.P4 (SHIELD), J301.P5 (SHIELD), J301.SW (SWITCH), U301.4 (GND); also elsewhere on the board
unnamed: C301.1, C302.1, FB301.2, J301.4 (VDD), R305.2, R306.1, R307.1
unnamed: J301.1 (DATA2), R305.1
unnamed: J301.7 (DAT0), R309.1
unnamed: J301.8 (DAT1), R306.2
unnamed: R304.2, U301.2 (SO)

Notes on the sheet:
FRAM memory
Alternative MR45V064B at lower price for less storage
SD card on SPI
MB85RS2MTAPNF-G-BDERE1 for U301 to provide 256K bytes storage
Pullups on DAT1, DAT2 to help with putting some SD cards to sleep
