ChrisHayward-dev/SapphireKicad/SapphineMinimal.kicad_pcb

## KiCad design SapphineMinimal.kicad_pcb (continued)

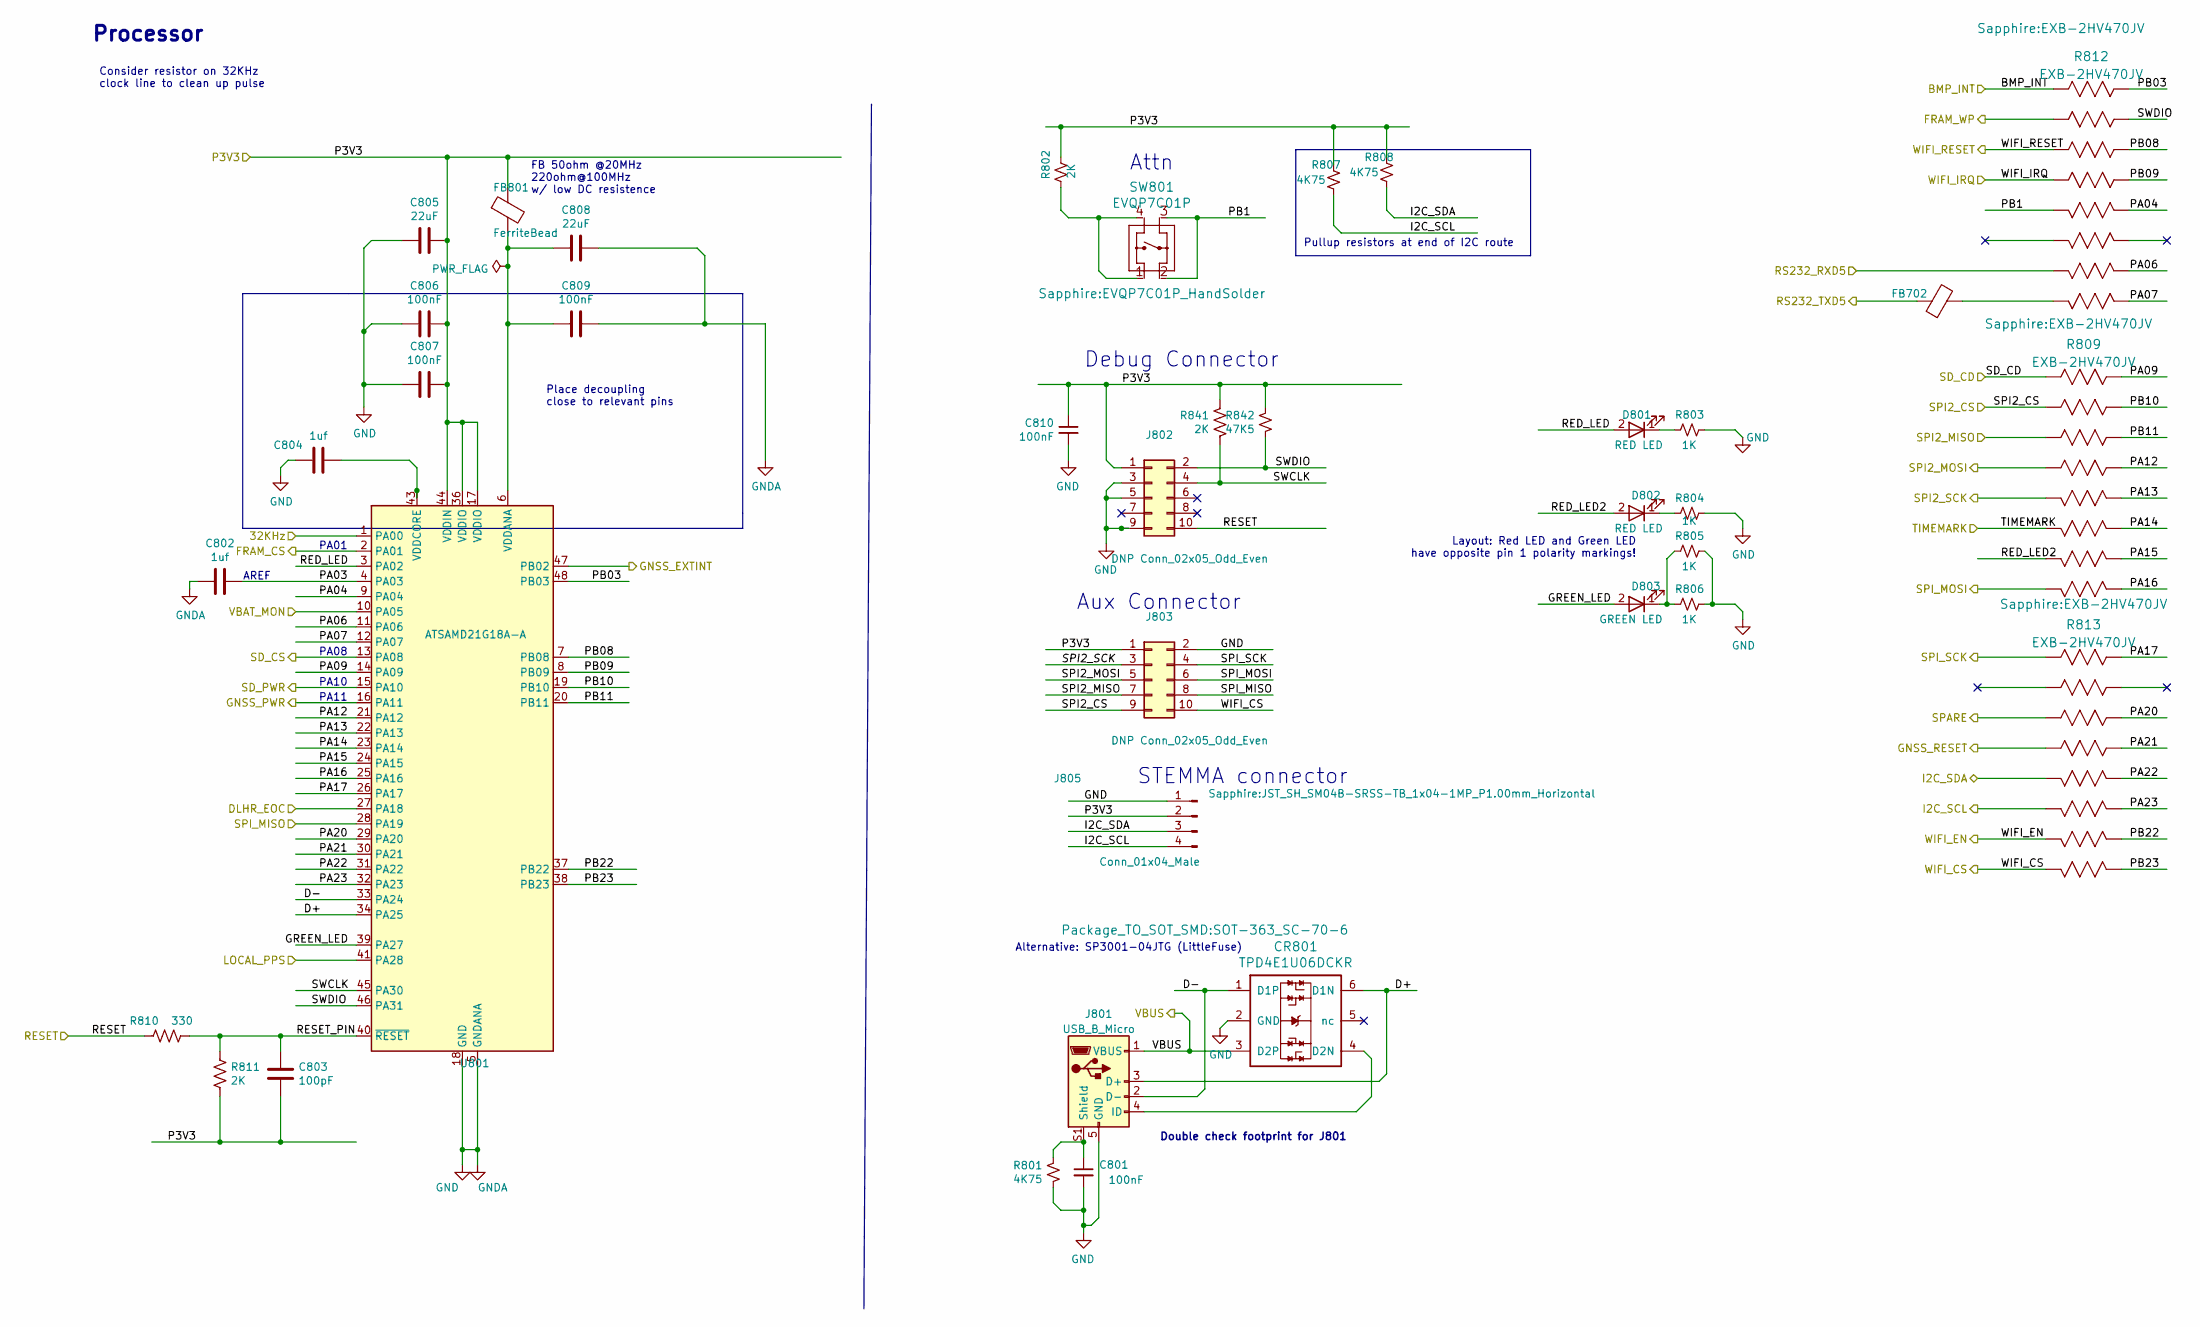
[picture p60: schematic SapphireMini_Proc.kicad_sch, Sapphire Mini M2]

Parts:
C801, C810: 100nF; C_0402_1005Metric; Tolerance 10%; Voltage 25; MPN CL05A104KA5NNNC; DigiKey Price 0.10
C802, C804: 1uf; C_0603_1608Metric; Voltage 16; MPN CL21B105KOFNNNG
C803: 100pF; C_0603_1608Metric; MPN 06035A101JAT2A
C805, C808: 22uF; C_0805_2012Metric; Voltage 16; MPN CL21A226MAYNNNE
C806, C807, C809: 100nF; C_0402_1005Metric; Voltage 25; MPN CL05A104KA5NNNC
CR801: TPD4E1U06DCKR; SOT-363_SC-70-6; MPN SP3001-04JTG; Digi-Key_PN F2915CT-ND
D801, D802: RED LED; LED_0805_2012Metric; MPN LTST-S220KRKT; DigiKey Price 0.28
D803: GREEN LED; LED_0805_2012Metric; MPN LTST-S220KGKT; DigiKey Price 0.28
FB702, FB801: FerriteBead; L_0603_1608Metric; MPN BLM18AG221SN1D
J801: USB_B_Micro; FCI_10118193-0001LF; MPN 10118193-0001LF
J802, J803: DNP Conn_02x05_Odd_Even; 3220-10-0100-00; MPN 3220-10-0100-00; DigiKey Price 0.58
J805: Conn_01x04_Male; JST_SH_SM04B-SRSS-TB_1x04-1MP_P1.00mm_Horizontal; MPN SM04B-SRSS-TB(LF)(SN); Digi-Key_PN 455-1804-1-ND
R801, R807, R808: 4K75; R_0603_1608Metric; Tolerance 5%; MPN CRCW06034K75FKEAC; DigiKey Price 0.05
R802: 2K; R_0603_1608Metric; Tolerance 5%; MPN CRCW06032K00FKEAC; DigiKey Price 0.05
R803, R804, R805, R806: 1K; R_0603_1608Metric; Tolerance 5%; MPN CRCW06031K00FKEAC; DigiKey Price 0.05
R809, R812, R813: EXB-2HV470JV; MPN EXB-2HV470JV
R810: 330; R_0603_1608Metric; MPN RC0603JR-07330RL
R811, R841: 2K; R_0603_1608Metric; MPN CRCW06032K00FKEAC
R842: 47K5; R_0603_1608Metric; Tolerance 1%; MPN CRCW060347K5FKEAC; DigiKey Price 0.10
SW801: EVQP7C01P; EVQP7C01P_HandSolder; MPN EVQ-P7C01P; Digi-Key_PN P16765CT-ND
U801: ATSAMD21G18A-A; TQFP-48_7x7mm_P0.5mm; MPN ATSAMD21G18A-AUT

Connections:
/DS3231/32KHz: U801.1 (PA00); also elsewhere on the board
/DS3231/SQW: U801.41 (PA28); also elsewhere on the board
/I2C_SCL: J805.4, R807.2, R813.6; also elsewhere on the board
/I2C_SDA: J805.3, R808.2, R813.5; also elsewhere on the board
/P3V3: C803.1, C805.1, C806.1, C807.1, C810.1, FB801.1, J802.1, J803.1, J805.2, R802.1, R807.1, R808.1, R811.2, R841.1, R842.2, U801.17 (VDDIO), U801.36 (VDDIO), U801.44 (VDDIN); also elsewhere on the board
/SPARE: R813.3; also elsewhere on the board
/SPI2_MISO: J803.7, R809.3; also elsewhere on the board
/SPI2_MOSI: J803.5, R809.4; also elsewhere on the board
/SPI2_SCK: J803.3, R809.5; also elsewhere on the board
/SapphireMini_DLHR/BMP_INT: R812.1; also elsewhere on the board
/SapphireMini_DLHR/DLHR_EOC: U801.27 (PA18); also elsewhere on the board
/SapphireMini_GNSS/GNSS_EXTINT: U801.47 (PB02); also elsewhere on the board
/SapphireMini_GNSS/GNSS_RESET: R813.4; also elsewhere on the board
/SapphireMini_GNSS/RS232_RXD: FB702.1; also elsewhere on the board
/SapphireMini_GNSS/RS232_TXD: R812.7; also elsewhere on the board
/SapphireMini_Power/GNSS_PWR: U801.16 (PA11); also elsewhere on the board
/SapphireMini_Power/SD_PWR: U801.15 (PA10); also elsewhere on the board
/SapphireMini_Power/VBAT_MON: U801.10 (PA05); also elsewhere on the board
/SapphireMini_Power/VBUS: CR801.3 (D2P), J801.1 (VBUS); also elsewhere on the board
/SapphireMini_SD/FRAM_CS: U801.2 (PA01); also elsewhere on the board
/SapphireMini_SD/FRAM_WP: R812.2; also elsewhere on the board
/SapphireMini_SD/SD_CS: U801.13 (PA08); also elsewhere on the board
/SapphireMini_SD/SPI_MISO: J803.8, U801.28 (PA19); also elsewhere on the board
/SapphireMini_SD/SPI_MOSI: J803.6, R809.8; also elsewhere on the board
/SapphireMini_SD/SPI_SCK: J803.4, R813.1; also elsewhere on the board
/Sapphire_Proc/D+: CR801.6 (D1N), J801.3 (D+), U801.34 (PA25)
/Sapphire_Proc/D-: CR801.1 (D1P), J801.2 (D-), U801.33 (PA24)
/Sapphire_Proc/GREEN_LED: D803.2 (A), U801.39 (PA27)
/Sapphire_Proc/PA03: C802.1, U801.4 (PA03)
/Sapphire_Proc/PA04: R812.12, U801.9 (PA04)
/Sapphire_Proc/PA06: R812.10, U801.11 (PA06)
/Sapphire_Proc/PA07: R812.9, U801.12 (PA07)
/Sapphire_Proc/PA09: R809.16, U801.14 (PA09)
/Sapphire_Proc/PA12: R809.13, U801.21 (PA12)
/Sapphire_Proc/PA13: R809.12, U801.22 (PA13)
/Sapphire_Proc/PA14: R809.11, U801.23 (PA14)
/Sapphire_Proc/PA15: R809.10, U801.24 (PA15)
/Sapphire_Proc/PA16: R809.9, U801.25 (PA16)
/Sapphire_Proc/PA17: R813.16, U801.26 (PA17)
/Sapphire_Proc/PA20: R813.14, U801.29 (PA20)
/Sapphire_Proc/PA21: R813.13, U801.30 (PA21)
/Sapphire_Proc/PA22: R813.12, U801.31 (PA22)
/Sapphire_Proc/PA23: R813.11, U801.32 (PA23)
/Sapphire_Proc/PB1: R812.5, SW801.2, SW801.3
/Sapphire_Proc/PB03: R812.16, U801.48 (PB03)
/Sapphire_Proc/PB08: R812.14, U801.7 (PB08)
/Sapphire_Proc/PB09: R812.13, U801.8 (PB09)
/Sapphire_Proc/PB10: R809.15, U801.19 (PB10)
/Sapphire_Proc/PB11: R809.14, U801.20 (PB11)
/Sapphire_Proc/PB22: R813.10, U801.37 (PB22)
/Sapphire_Proc/PB23: R813.9, U801.38 (PB23)
/Sapphire_Proc/RED_LED: D801.2 (A), U801.3 (PA02)
/Sapphire_Proc/RED_LED2: D802.2 (A), R809.7
/Sapphire_Proc/RESET: J802.10, R810.2; also elsewhere on the board
/Sapphire_Proc/RESET_PIN: C803.2, R810.1, R811.1, U801.40 (~RESET)
/Sapphire_Proc/SD_CD: R809.1; also elsewhere on the board
/Sapphire_Proc/SPI2_CS: J803.9, R809.2
/Sapphire_Proc/SWCLK: J802.4, R841.2, U801.45 (PA30)
/Sapphire_Proc/SWDIO: J802.2, R812.15, R842.1, U801.46 (PA31)
/Sapphire_Proc/TIMEMARK: R809.6; also elsewhere on the board
/Sapphire_Proc/WIFI_CS: J803.10, R813.8; also elsewhere on the board
/Sapphire_Proc/WIFI_EN: R813.7; also elsewhere on the board
/WIFI_IRQ: R812.4; also elsewhere on the board
/WIFI_RST: R812.3; also elsewhere on the board
GND: C801.2, C802.2, C804.2, C805.2, C806.2, C807.2, C808.1, C809.1, C810.2, CR801.2 (GND), J801.5 (GND), J802.3, J802.5, J802.9, J803.2, J805.1, R801.1, R803.2, R804.2, R805.2, R806.2, U801.5 (GNDANA), U801.18 (GND), U801.35 (GND), U801.42 (GND); also elsewhere on the board
unnamed: C801.1, J801.S1 (Shield), R801.2
unnamed: C804.1, U801.43 (VDDCORE)
unnamed: C808.2, C809.2, FB801.2, U801.6 (VDDANA)
unnamed: CR801.4 (D2N), J801.4 (ID)
unnamed: D801.1 (K), R803.1
unnamed: D802.1 (K), R804.1
unnamed: D803.1 (K), R805.1, R806.1
unnamed: FB702.2, R812.8
unnamed: R802.2, SW801.1, SW801.4

Notes on the sheet:
PA08
PA10
PA11
Double check footprint for J801
Processor
Layout: Red LED and Green LED have opposite pin 1 polarity markings!
Debug Connector
AREF
Attn
Alternative: SP3001-04JTG (LittleFuse)
PA01
Pullup resistors at end of I2C route
FB 50ohm @20MHz 220ohm@100MHz w/ low DC resistence
STEMMA connector
Consider resistor on 32KHz clock line to clean up pulse
Place decoupling close to relevant pins
Aux Connector

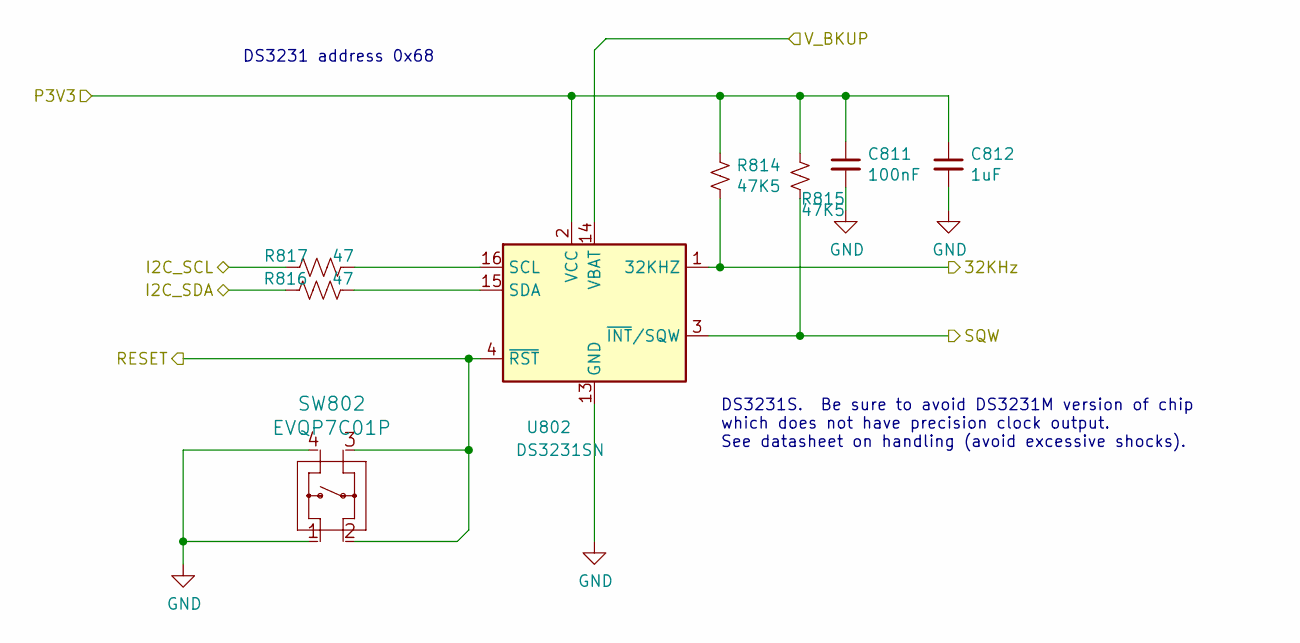
[picture p61: schematic DS3231_sch.kicad_sch]

Parts:
C811: 100nF; C_0402_1005Metric; Tolerance 10%; Voltage 25; MPN CL05A104KA5NNNC; DigiKey Price 0.10
C812: 1uF; C_0805_2012Metric; Tolerance 10%; Voltage 16; MPN CL21B105KOFNNNG; DigiKey Price 0.06
R814, R815: 47K5; R_0603_1608Metric; Tolerance 1%; MPN CRCW060347K5FKEAC; DigiKey Price 0.10
R816, R817: 47; R_0603_1608Metric; MPN CRCW060347R0FKEAC
SW802: EVQP7C01P; EVQP7C01P_HandSolder; MPN EVQ-P7C01P; Digi-Key_PN P16765CT-ND
U802: DS3231SN; SOIC-16W_7.5x10.3mm_P1.27mm; MPN DS3231SN#T&R; Digi-Key_PN DS3231SN#T&RCT-ND

Connections:
/DS3231/32KHz: R814.2, U802.1 (32KHZ); also elsewhere on the board
/DS3231/SQW: R815.2, U802.3 (~INT/SQW); also elsewhere on the board
/I2C_SCL: R817.2; also elsewhere on the board
/I2C_SDA: R816.2; also elsewhere on the board
/P3V3: C811.1, C812.1, R814.1, R815.1, U802.2 (VCC); also elsewhere on the board
/Sapphire_Proc/RESET: SW802.2, SW802.3, U802.4 (~RST); also elsewhere on the board
/V_BKUP: U802.14 (VBAT); also elsewhere on the board
GND: C811.2, C812.2, SW802.1, SW802.4, U802.5 (GND), U802.6 (GND), U802.7 (GND), U802.8 (GND), U802.9 (GND), U802.10 (GND), U802.11 (GND), U802.12 (GND), U802.13 (GND); also elsewhere on the board
unnamed: R816.1, U802.15 (SDA)
unnamed: R817.1, U802.16 (SCL)

Notes on the sheet:
DS3231 address 0x68
DS3231S. Be sure to avoid DS3231M version of chip which does not have precision clock output. See datasheet on handling (avoid excessive shocks).

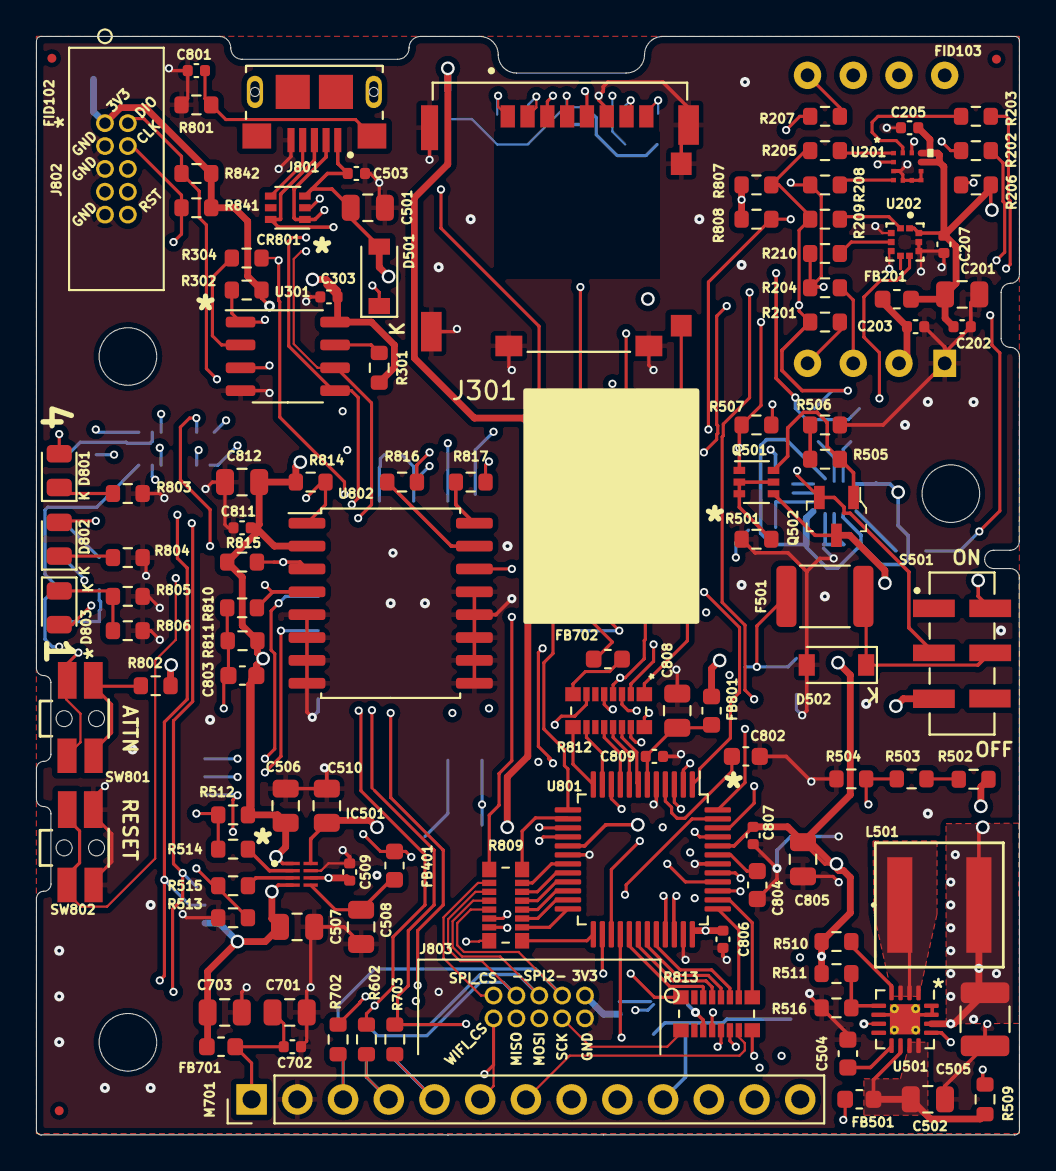
[picture p62: board SapphineMinimal.kicad_pcb from above]

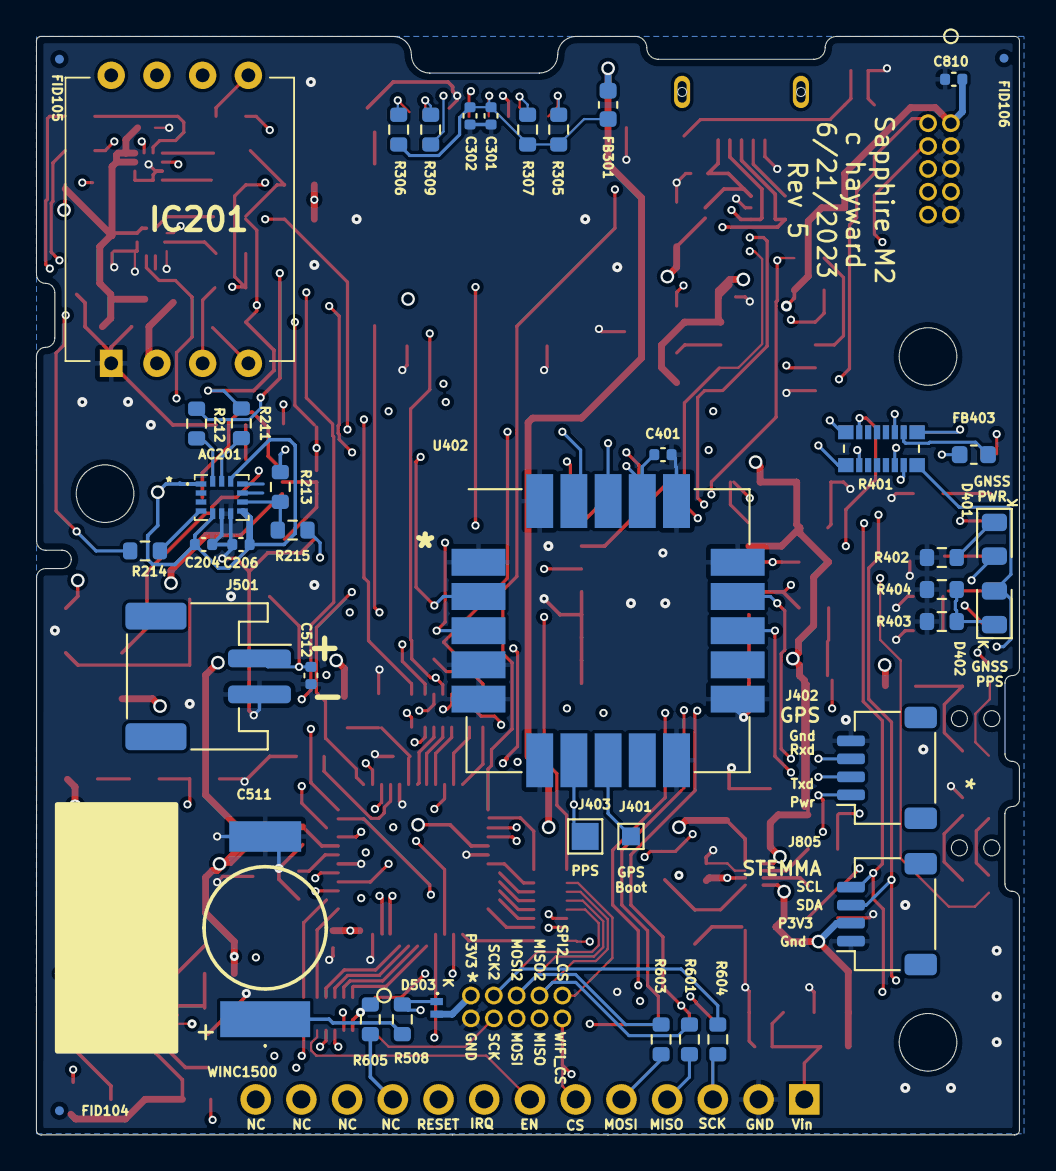
[picture p63: board SapphineMinimal.kicad_pcb from below]

Board: 4 copper layers, 54.6 x 61.0 mm, 159 parts (42 on the bottom side), 133 nets.

Other parts of the board:
C701, C703: 22uF; C_0805_2012Metric
C702: 100nF; C_0402_1005Metric
FB701: FerriteBead; L_0603_1608Metric
M701: DNP AdafruitWINC1500; PinHeader_1x13_P2.54mm_Vertical
R601: 0; R_0603_1608Metric
R602: DNP 0; R_0603_1608Metric
R603, R604: 47; R_0603_1608Metric
R605, R702, R703: DNP 47; R_0603_1608Metric

Their connections:
/P3V3: C703.1, FB701.1; also elsewhere on the board
/SPARE: R605.2; also elsewhere on the board
/SPI2_MISO: R601.1; also elsewhere on the board
/SPI2_MOSI: R603.2; also elsewhere on the board
/SPI2_SCK: R604.2; also elsewhere on the board
/SapphireMini_SD/SPI_MISO: R602.1; also elsewhere on the board
/SapphireMini_SD/SPI_MOSI: R703.2; also elsewhere on the board
/SapphireMini_SD/SPI_SCK: R702.2; also elsewhere on the board
/Sapphire_Proc/WIFI_CS: M701.6 (CS); also elsewhere on the board
/Sapphire_Proc/WIFI_EN: M701.7 (EN); also elsewhere on the board
/Sapphire_WiFi/WSPI_MISO: M701.4 (MISO), R601.2, R602.2
/Sapphire_WiFi/WSPI_MOSI: M701.5 (MOSI), R603.1, R703.1
/Sapphire_WiFi/WSPI_SCK: M701.3 (SCK), R604.1, R702.1
/WIFI_IRQ: M701.8 (IRQ); also elsewhere on the board
/WIFI_RST: M701.9 (RST); also elsewhere on the board
GND: C701.2, C702.2, C703.2, M701.2 (Gnd); also elsewhere on the board
unnamed: C701.1, C702.1, FB701.2, M701.1 (Vin)
unnamed: M701.10 (WAKE), R605.1
