ChrisHayward-dev/SapphireKicad/SapphirePowerSubsystem/SapphirePowerSubsystem.kicad_pcb

## KiCad design SapphirePowerSubsystem/SapphirePowerSubsystem.kicad_pcb (2023-03-04)

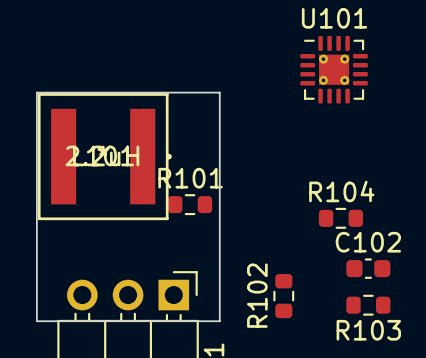
[picture p64: board SapphirePowerSubsystem.kicad_pcb from above]

Board: 2 copper layers, 10.2 x 12.7 mm, 8 parts (0 on the bottom side), 8 nets, no tracks yet.

Parts:
C102: 390pF; C_0603_1608Metric
J101: Conn_01x03_Male; PinHeader_1x03_P2.54mm_Horizontal
L101: 2.2uH; 74439344022
R101, R102: 100K; R_0603_1608Metric
R103: 562K; R_0603_1608Metric
R104: 180K; R_0603_1608Metric
U101: TPS62150; VQFN-16-1EP_3x3mm_P0.5mm_EP1.68x1.68mm_ThermalVias

Connections:
/P3V3: J101.3, L101.1, R102.1, R103.1, U101.7 (FSW), U101.14 (VOS)
/VBAT_EN: R101.2, U101.13 (EN)
/Vin: J101.1, R101.1, U101.10 (AVIN), U101.11 (PVIN), U101.12 (PVIN)
GND: C102.2, J101.2, R104.2, U101.6 (AGND), U101.15 (PGND), U101.16 (PGND), U101.17 (EP)
unnamed: C102.1, U101.9 (SS/TR)
unnamed: L101.2, U101.1 (SW), U101.2 (SW), U101.3 (SW)
unnamed: R102.2, U101.4 (PG)
unnamed: R103.2, R104.1, U101.5 (FB)
