ChrisHayward-dev/SapphireKicad/Sapphire_AnalogMicR1/Sapphire_AnalogMic.kicad_pcb

## KiCad design Sapphire_AnalogMicR1/Sapphire_AnalogMic.kicad_pcb (2022-09-22)

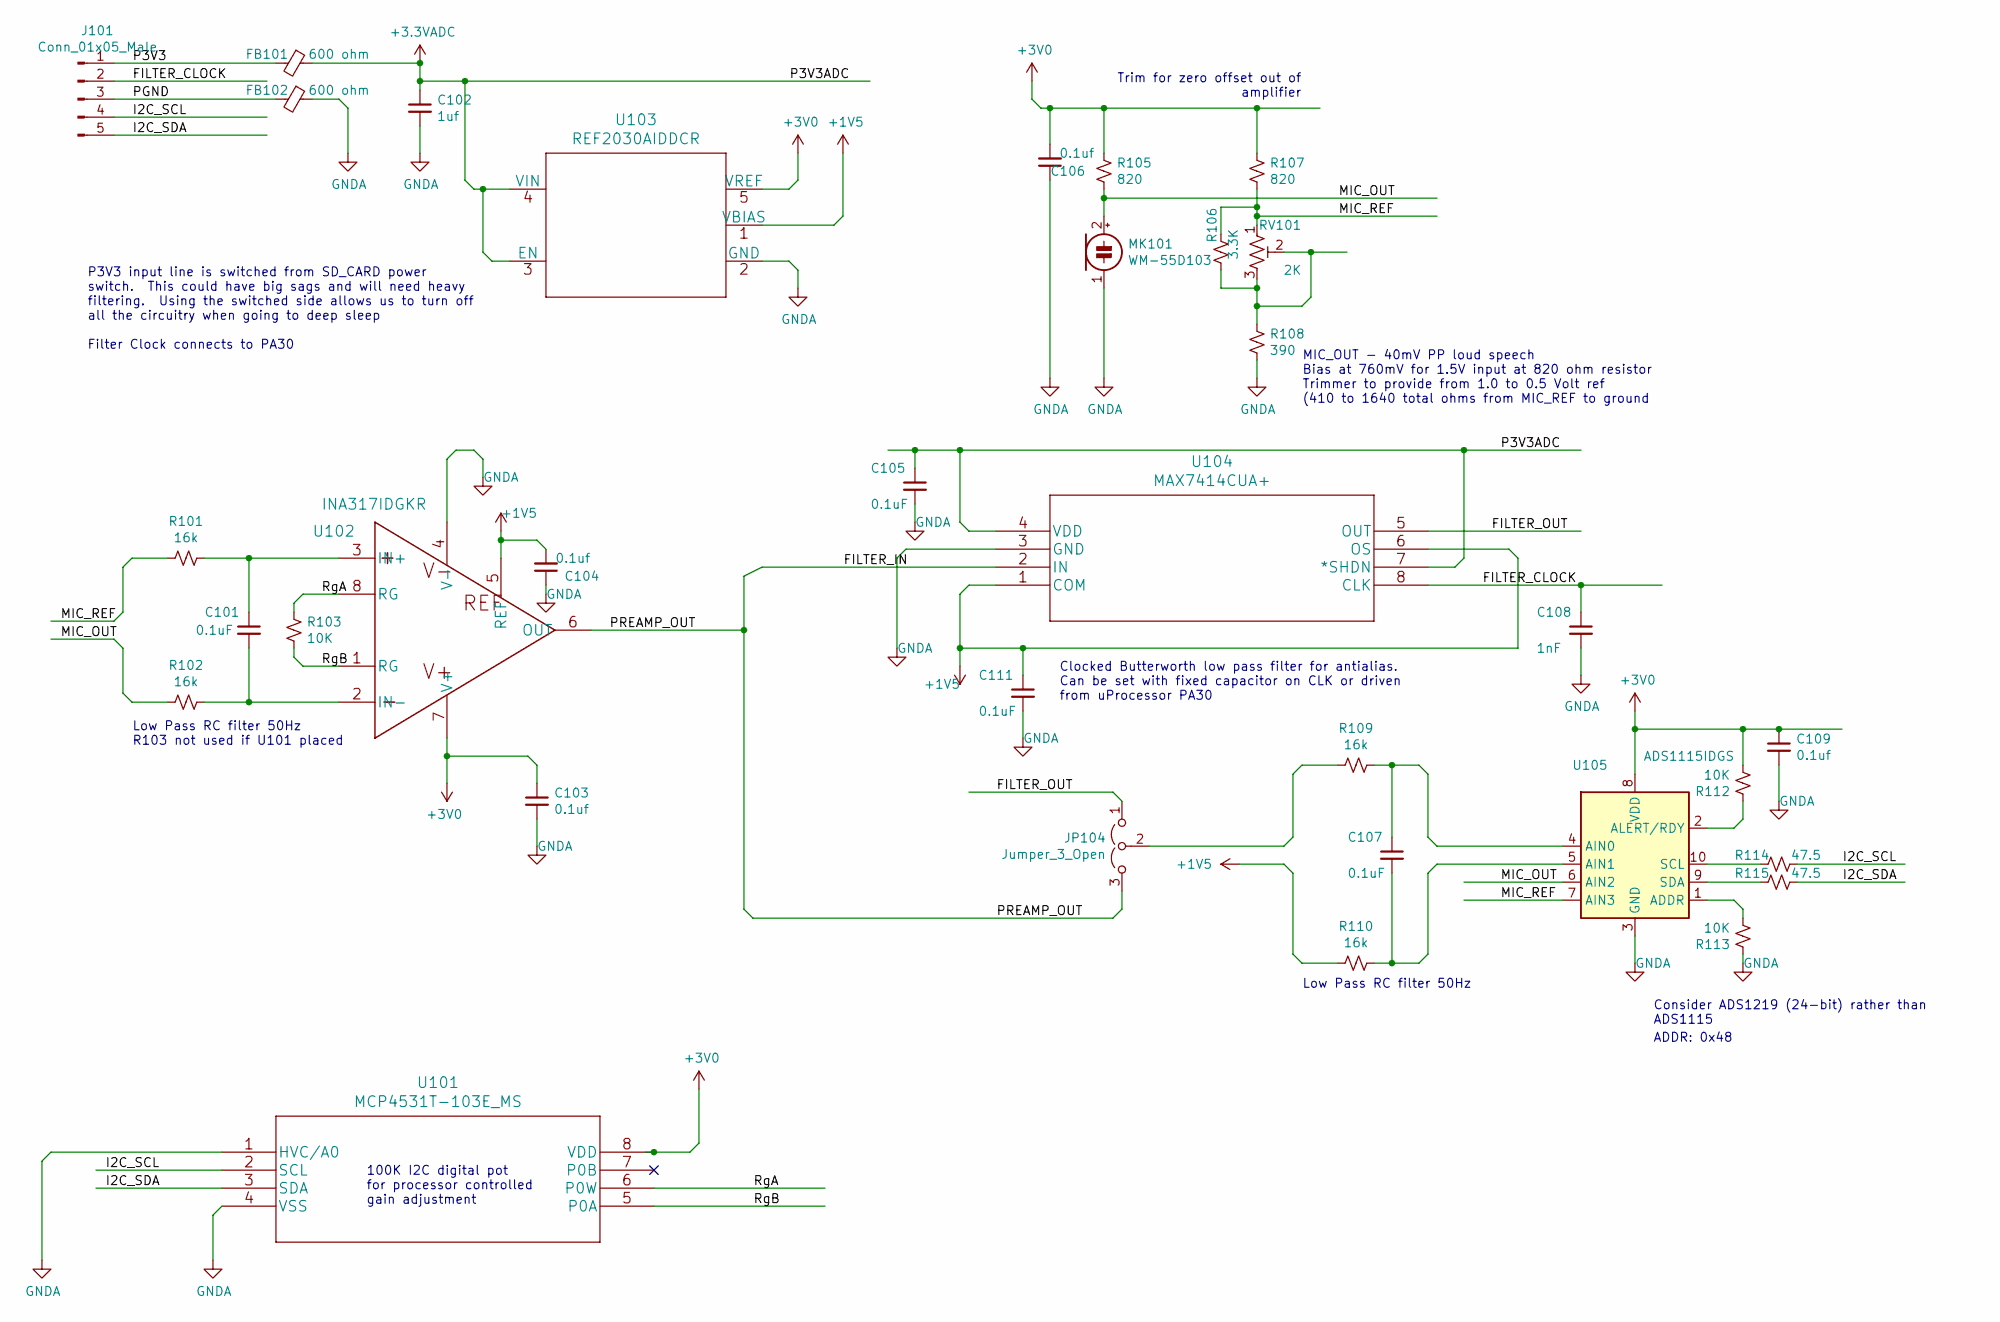
[picture p65: schematic Sapphire_AnalogMic.sch, Sapphire Mini Electret Microphone]

Parts:
C101, C105, C107, C111: 0.1uF; C_0603_1608Metric
C102: 1uf; C_0603_1608Metric
C103, C104, C106, C109: 0.1uf; C_0603_1608Metric
C108: 1nF; C_0603_1608Metric
FB101, FB102: 600 ohm; R_0603_1608Metric
J101: Conn_01x05_Male; PinHeader_1x05_P2.54mm_Vertical
JP104: Jumper_3_Open; SolderJumper-3_P1.3mm_Open_RoundedPad1.0x1.5mm_NumberLabels
MK101: WM-55D103; PinHeader_1x02_P2.54mm_Vertical
R101, R102, R109, R110: 16k; R_0603_1608Metric
R103, R112, R113: 10K; R_0603_1608Metric
R105, R107: 820; R_0603_1608Metric
R106: 3.3K; R_0603_1608Metric
R108: 390; R_0603_1608Metric
R114, R115: 47.5; R_0603_1608Metric
RV101: 2K; Potentiometer_Bourns_3296W_Vertical
U101: MCP4531T-103E_MS; MAX7414CUA&plus_
U102: INA317IDGKR
U103: REF2030AIDDCR
U104: MAX7414CUA+; MAX7414CUA&plus_
U105: ADS1115IDGS; TSSOP-10_3x3mm_P0.5mm

Connections:
+1V5: C104.2, C111.1, R110.2, U102.5 (REF), U103.1 (VBIAS), U104.1 (COM), U104.6 (OS)
+3.3VADC: C102.1, C105.1, FB101.1, U103.3 (EN), U103.4 (VIN), U104.4 (VDD), U104.7 (*SHDN)
+3V0: C103.1, C106.2, C109.1, R105.1, R107.1, R112.2, U101.8 (VDD), U102.7 (V+), U103.5 (VREF), U105.8 (VDD)
/FILTER_CLOCK: C108.1, J101.2, U104.8 (CLK)
/FILTER_IN: JP104.3 (B), U102.6 (OUT), U104.2 (IN)
/FILTER_OUT: JP104.1 (A), U104.5 (OUT)
/I2C_SCL: J101.4, R114.1, U101.2 (SCL)
/I2C_SDA: J101.5, R115.1, U101.3 (SDA)
/MIC_OUT: MK101.2 (+), R102.2, R105.2, U105.6 (AIN2)
/MIC_REF: R101.2, R106.1, R107.2, RV101.1, U105.7 (AIN3)
/P3V3: FB101.2, J101.1
/PGND: FB102.2, J101.3
/RgA: R103.1, U101.6 (P0W), U102.8 (RG)
/RgB: R103.2, U101.5 (P0A), U102.1 (RG)
GNDA: C102.2, C103.2, C104.1, C105.2, C106.1, C108.2, C109.2, C111.2, FB102.1, MK101.1 (-), R108.2, R113.1, U101.1 (HVC/A0), U101.4 (VSS), U102.4 (V-), U103.2 (GND), U104.3 (GND), U105.3 (GND)
unnamed: C101.1, R101.1, U102.3 (IN+)
unnamed: C101.2, R102.1, U102.2 (IN-)
unnamed: C107.1, R109.1, U105.4 (AIN0)
unnamed: C107.2, R110.1, U105.5 (AIN1)
unnamed: JP104.2 (C), R109.2
unnamed: R106.2, R108.1, RV101.2, RV101.3
unnamed: R112.1, U105.2 (ALERT/RDY)
unnamed: R113.2, U105.1 (ADDR)
unnamed: R114.2, U105.10 (SCL)
unnamed: R115.2, U105.9 (SDA)

Notes on the sheet:
100K I2C digital pot for processor controlled gain adjustment
Low Pass RC filter 50Hz
Low Pass RC filter 50Hz R103 not used if U101 placed
Trim for zero offset out of amplifier
MIC_OUT - 40mV PP loud speech Bias at 760mV for 1.5V input at 820 ohm resistor Trimmer to provide from 1.0 to 0.5 Volt ref (410 to 1640 total ohms from MIC_REF to ground
Consider ADS1219 (24-bit) rather than ADS1115
P3V3 input line is switched from SD_CARD power switch. This could have big sags and will need heavy filtering. Using the switched side allows us to turn off all the circuitry when going to deep sleep Filter Clock connects to PA30
Clocked Butterworth low pass filter for antialias. Can be set with fixed capacitor on CLK or driven from uProcessor PA30
ADDR: 0x48

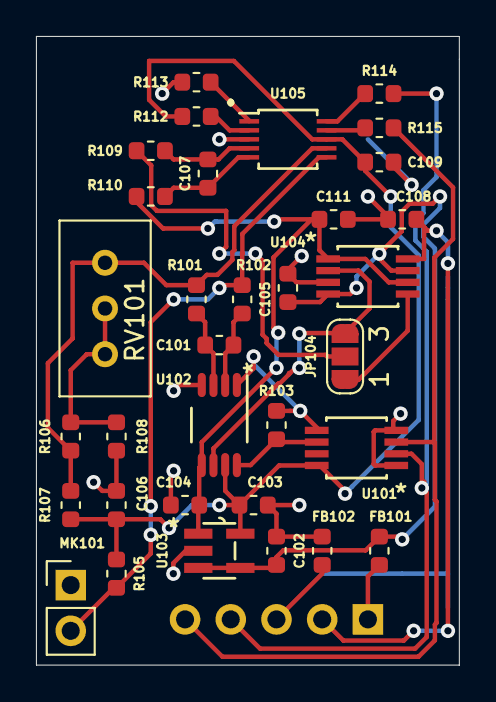
[picture p66: board Sapphire_AnalogMic.kicad_pcb from above]

Board: 2 copper layers, 23.5 x 34.9 mm, 34 parts (1 on the bottom side), 25 nets.
