ChrisHayward-dev/SapphireKicad/SapphineMinimalR6.kicad_pcb

## KiCad design SapphineMinimalR6.kicad_pcb (2022-09-22)

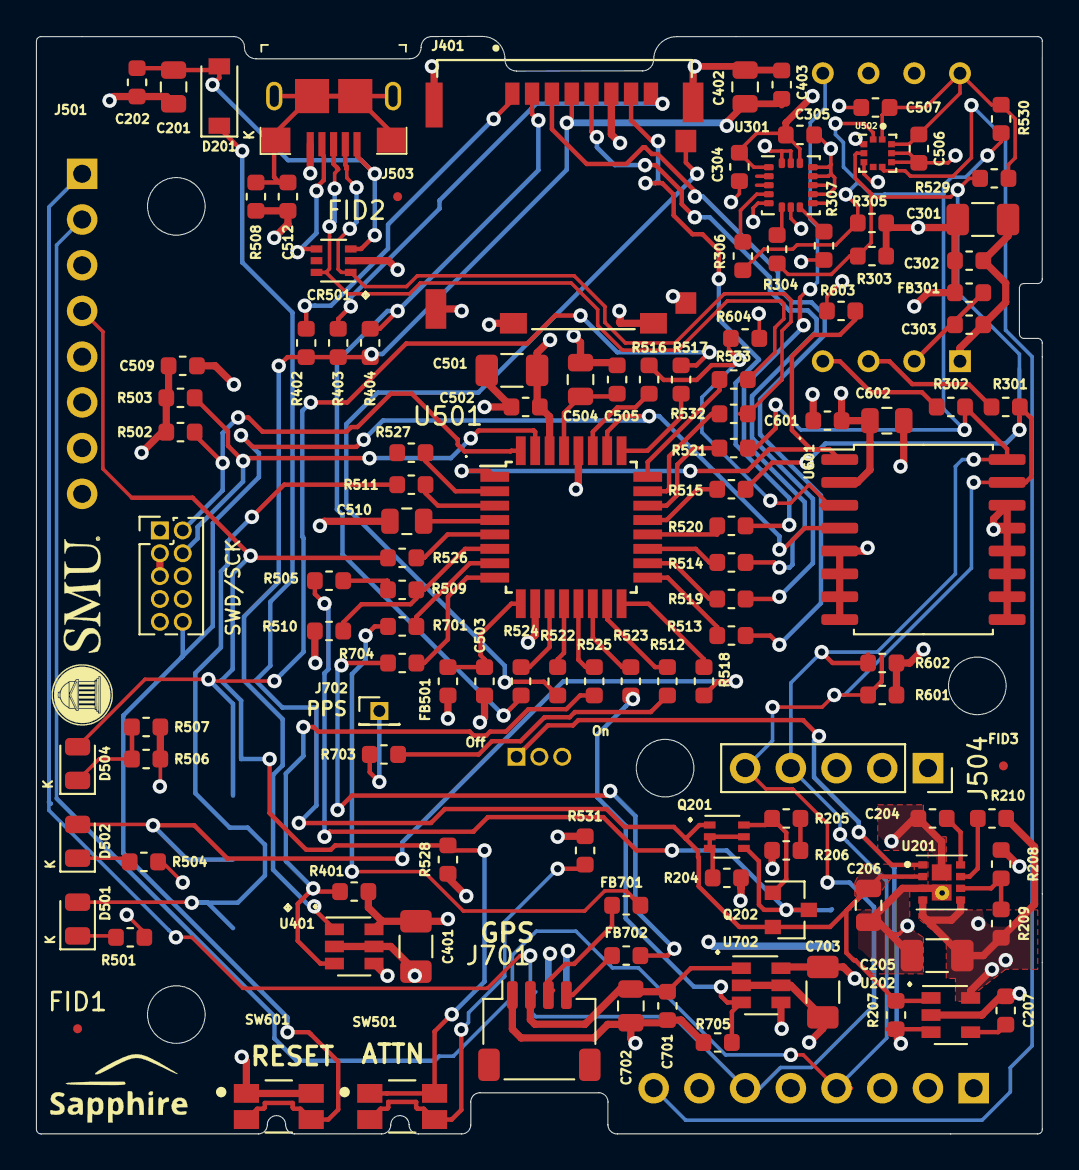
[picture p67: board SapphineMinimalR6.kicad_pcb from above]

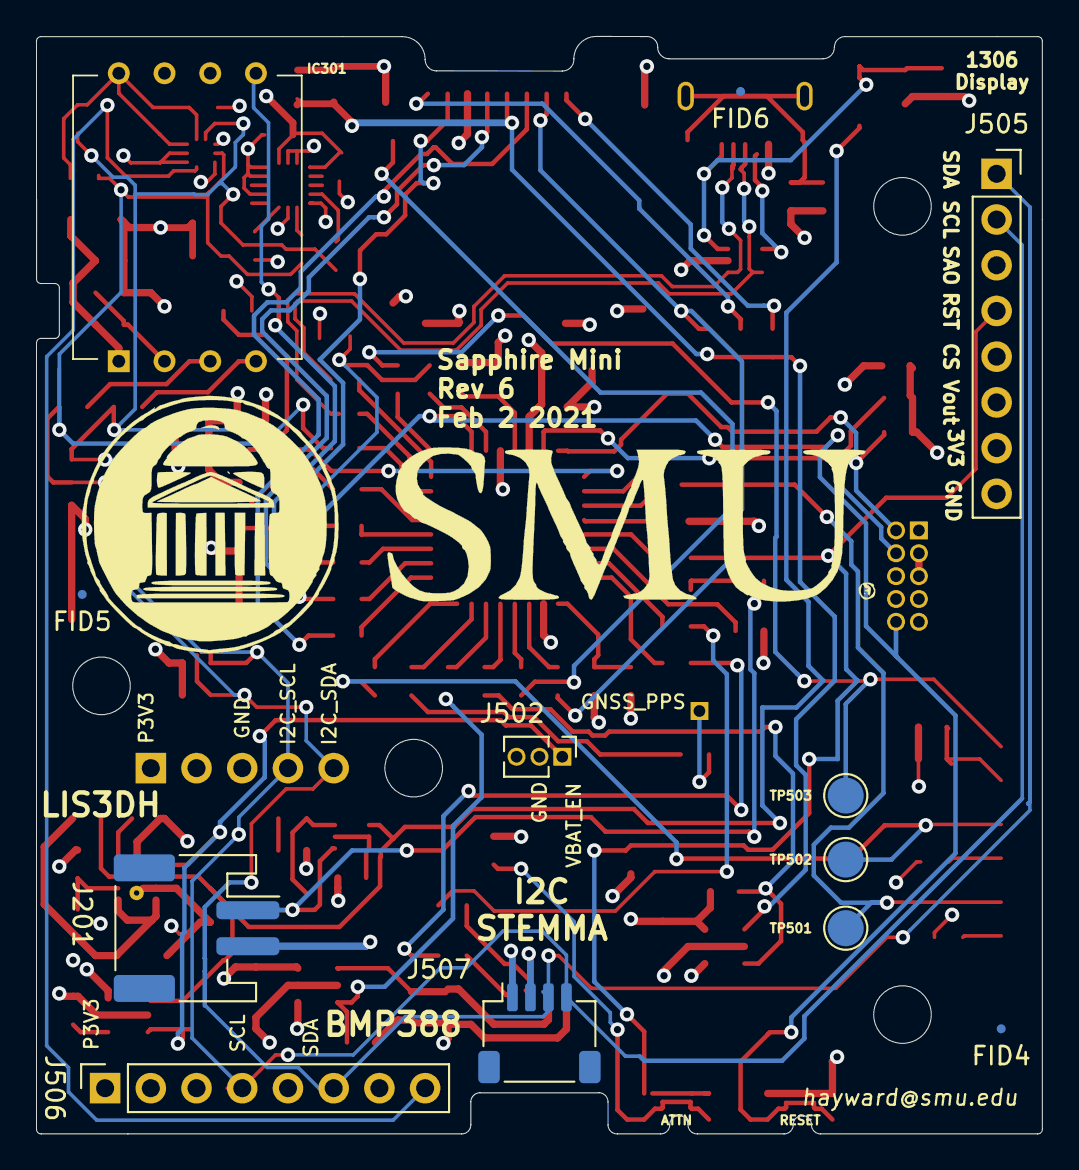
[picture p68: board SapphineMinimalR6.kicad_pcb from below]

Board: 4 copper layers, 55.9 x 61.0 mm, 130 parts (12 on the bottom side), 83 nets.

Parts:
C201, C206: 10uF; C_0805_2012Metric
C202, C207, C302, C303, C304, C305, C403, C502, C503, C505, C506, C507, C509, C512, C601, C701: 100nF; C_0603_1608Metric
C204: 560pF; C_0603_1608Metric
C205, C301, C401, C501, C703: 22uF; C_1206_3216Metric
C402, C504, C510, C602, C702: 1uF; C_0805_2012Metric
CR501: TPD4E1U06DCKR; SOT-363_SC-70-6
D201: MBR180; D_SOD-123
D501, D502: RED LED; LED_0805_2012Metric
D504: GREEN LED; LED_0805_2012Metric
FB301, FB501, FB701, FB702: 600; R_0603_1608Metric
FID1, FID2, FID3, FID4, FID5, FID6: Fiducial_0.5mm_Mask1mm
IC301: DLHR-F50D-E1BD-C-NAV8; DLHRF50DE1BDCNAV8
J201: JST; JST_PH_S2B-PH-SM4-TB_1x02-1MP_P2.00mm_Horizontal
J401: 503182-1852; MOLEX_503182-1852
J501: Conn_02x05_Odd_Even; PinHeader_2x05_P1.27mm_Vertical
J502: Conn_01x03_Male; PinHeader_1x03_P1.27mm_Vertical
J503: USB_B_Micro; USB_Micro_B_Female_10118193-0001LF
J504: Conn_01x05_Female; PinSocket_1x05_P2.54mm_Vertical
J505, J506: Conn_01x08_Female; PinSocket_1x08_P2.54mm_Vertical
J507, J701: Conn_01x04_Male; JST_SH_SM04B-SRSS-TB_1x04-1MP_P1.00mm_Horizontal
J702: Conn_01x01_Male; PinHeader_1x01_P1.27mm_Vertical
Q201: BC857BS; SOT-363_SC-70-6
Q202: IRLML6402TRPBF; SOT-23
R204, R205, R207, R208, R210, R401, R402, R403, R505, R509, R705: 100K; R_0603_1608Metric
R206, R404, R502, R503, R510, R528, R603, R604: 47K5; R_0603_1608Metric
R209: 309K; R_0603_1608Metric
R301, R302, R304, R306, R511, R512, R513, R515, R516, R517, R518, R519, R520, R521, R523, R524, R525, R526, R527, R532, R533, R701, R703, R704: 47; R_0603_1608Metric
R303, R305, R307: 10K; R_0603_1608Metric
R501, R504, R506, R507, R514, R522, R531: 2K; R_0603_1608Metric
R508, R529, R530, R601, R602: 4K75; R_0603_1608Metric
SW501: SW_Push_Dual; SW_EVQ-P7J01P
SW601: SW_Push_Dual_EVQ-P7J01P; SW_EVQ-P7J01P
TP501, TP502, TP503: TestPoint; TestPoint_Pad_D2.0mm
U201: TPS82150; TPS82130SILT
U202: SPX3819M5-L-3-3; SOT-23-5
U301: LIS3DH; LGA-16_3x3mm_P0.5mm_LayoutBorder3x5y
U401, U702: TPS22929D; SOT-23-6
U501: ATSAMD21E18A-AUT; TQFP-32_7x7mm_P0.8mm
U502: BMP388; PQFN50P200X200X80-10N
U601: DS3231SN; SOIC-16W_7.5x10.3mm_P1.27mm

Connections:
/P3V3: C205.1, C301.1, C302.1, C304.1, C305.1, C401.1, C501.1, C502.1, C506.1, C507.1, C509.1, C601.1, C602.1, C703.1, FB301.2, FB501.2, IC301.8, J501.1, J504.1, J505.7, J506.1, J507.2, R209.2, R210.1, R303.2, R305.2, R307.2, R401.1, R502.2, R503.2, R529.1, R530.1, R531.1, R601.1, R602.1, R603.1, R604.1, U201.4, U201.5, U202.5, U301.1, U301.14, U401.4, U401.6, U501.30, U502.1, U502.10, U601.2, U702.4, U702.6
/SapphireMini_DLHR/DLHR_EOC: IC301.5, R514.2
/SapphireMini_DLHR/I2C_SCL: J504.4, J505.2, J506.4, J507.4, R302.2, R303.1, R304.2, R521.2, R530.2, R602.2, U502.2, U601.16
/SapphireMini_DLHR/I2C_SDA: J504.5, J505.1, J506.6, J507.3, R301.2, R305.1, R306.2, R515.2, R529.2, R601.2, U502.4, U601.15
/SapphireMini_DS3231/32KHz: R603.2, U501.1, U601.1
/SapphireMini_DS3231/RESET: J501.10, SW601.1_2, SW601.2_2, U501.26, U601.4
/SapphireMini_GNSS/GNSS_PWR: R523.2, R705.2, U702.3
/SapphireMini_GNSS/RS232_RXD: R701.2, U501.7
/SapphireMini_GNSS/TIMEMARK: R512.2, R703.1
/SapphireMini_Power/PWR_IN: C206.1, D201.1, Q201.1, Q202.2, R207.2, U201.2, U202.1
/SapphireMini_Power/VBAT: J201.1, Q201.4, Q202.3, R505.1
/SapphireMini_Power/VBAT_EN: J502.1, R207.1, U201.1, U202.3
/SapphireMini_Proc/1306RST: J505.4, R526.2, R528.1, SW501.1_1, SW501.2_1
/SapphireMini_Proc/AREF: C510.1, U501.4
/SapphireMini_Proc/BMP_INT: J506.8, U502.7
/SapphireMini_Proc/D+: CR501.6, J503.3, R533.2
/SapphireMini_Proc/D-: CR501.1, J503.2, R532.2
/SapphireMini_Proc/GREEN_LED: D504.2, R517.2, TP503.1
/SapphireMini_Proc/LOCAL_PPS: R516.2, R604.2, U601.3
/SapphireMini_Proc/RED_LED: D501.2, R511.2, TP501.1
/SapphireMini_Proc/RED_LED2: D502.2, R518.2, TP502.1
/SapphireMini_Proc/RS232_RXD5: R704.1, U501.8
/SapphireMini_Proc/SD_CD: J401.SW, R522.2
/SapphireMini_Proc/SD_CS: J401.2, R404.2, R524.2
/SapphireMini_Proc/SD_PWR: R401.2, R525.2, U401.3
/SapphireMini_Proc/SPI_MISO: J401.7, R520.2
/SapphireMini_Proc/SPI_MOSI: J401.3, R513.2
/SapphireMini_Proc/SPI_SCK: J401.5, R519.2
/SapphireMini_Proc/SWCLK: J501.4, R503.1, U501.31
/SapphireMini_Proc/SWDIO: J501.2, R502.1, U501.32
/SapphireMini_Proc/VBAT_MON: R509.2, R510.1, U501.6
/SapphireMini_Proc/VBUS: C201.1, C202.1, CR501.3, D201.2, J503.1
GND: C201.2, C202.2, C204.2, C205.2, C206.2, C207.2, C301.2, C302.2, C303.2, C304.2, C305.2, C401.2, C402.2, C403.2, C501.2, C502.2, C503.2, C504.2, C505.2, C506.2, C507.2, C509.2, C510.2, C512.2, C601.2, C602.2, C701.2, C702.2, C703.2, CR501.2, IC301.1, J201.2, J401.6, J401.DT, J401.P1, J401.P2, J401.P3, J401.P4, J401.P5, J501.3, J501.5, J501.9, J502.2, J503.5, J504.3, J505.8, J506.3, J507.1, J701.4, R204.2, R206.2, R208.1, R501.2, R504.2, R506.2, R507.2, R508.1, R510.2, R528.2, R705.1, SW601.1_1, SW601.2_1, U201.3, U201.9, U202.2, U301.5, U301.7, U301.10, U301.12, U301.13, U301.15, U301.16, U401.2, U401.5, U501.10, U501.28, U502.3, U502.5, U502.8, U502.9, U601.5, U601.6, U601.7, U601.8, U601.9, U601.10, U601.11, U601.12, U601.13, U601.14, U702.2, U702.5
unnamed: C204.1, U201.8
unnamed: C207.1, U202.4
unnamed: C303.1, FB301.1, IC301.2
unnamed: C402.1, C403.1, J401.4, R402.2, R403.1, R404.1, U401.1
unnamed: C503.1, FB501.1, U501.9
unnamed: C504.1, C505.1, U501.29
unnamed: C512.1, J503.6, R508.2
unnamed: C701.1, C702.1, J701.1, U702.1
unnamed: CR501.4, J503.4
unnamed: D501.1, R501.1
unnamed: D502.1, R504.1
unnamed: D504.1, R506.1, R507.1
unnamed: FB701.1, J701.2
unnamed: FB701.2, R701.1
unnamed: FB702.1, R704.2
unnamed: FB702.2, J701.3
unnamed: IC301.3, R301.1
unnamed: IC301.4, R302.1
unnamed: J401.1, R402.1
unnamed: J401.8, R403.2
unnamed: J702.1, R703.2
unnamed: Q201.2, Q201.3, Q201.5, R204.1
unnamed: Q201.6, Q202.1, R205.1
unnamed: R205.2, R206.1
unnamed: R208.2, R209.1, U201.6
unnamed: R210.2, U201.7
unnamed: R304.1, U301.4
unnamed: R306.1, U301.6
unnamed: R307.1, U301.8
unnamed: R505.2, R509.1
unnamed: R511.1, U501.3
unnamed: R512.1, U501.15
unnamed: R513.1, U501.17
unnamed: R514.1, U501.19
unnamed: R515.1, U501.21
unnamed: R516.1, U501.27
unnamed: R517.1, U501.25
unnamed: R518.1, U501.16
unnamed: R519.1, U501.18
unnamed: R520.1, U501.20
unnamed: R521.1, U501.22
unnamed: R522.1, U501.12
unnamed: R523.1, U501.14
unnamed: R524.1, U501.11
unnamed: R525.1, U501.13
unnamed: R526.1, U501.5
unnamed: R527.1, U501.2
unnamed: R531.2, SW501.1_2, SW501.2_2
unnamed: R532.1, U501.23
unnamed: R533.1, U501.24
