ChrisHayward-dev/SapphireKicad/(commit log)

2022-09-22 Initial Commit from first 100 production
    [FirstPlace.kicad_pcb, FirstRoute.kicad_pcb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]
2022-09-25 From RA_Old Modified"
    [014441219.stp, 10118193-0001LF--3DModel-STEP-56544.STEP, 2908-05WB-MG--3DModel-STEP-56544.stp, 3220-10-0100.igs, 5031821852--3DModel-STEP-56544.STEP, 74439344010_STP_WE-XHMI-6030_rev1.stp, Adafruit LIS3DH.step, Adafruit Winc1500.step]
2022-09-26 end of day
    [SapphineMinimal.kicad_sch, SapphireMini_DLHR.kicad_sch, SapphireMini_DS3231.kicad_sch, SapphireMini_GNSS.kicad_sch, SapphireMini_Pwr.kicad_sch, SapphireMini_SD.kicad_sch, file63357570.kicad_sch, file63A74EF1.kicad_sch]
2022-09-26 3d references'
    [SapphineMinimal.kicad_pcb, SapphineMinimal.kicad_sch, SapphireMini_DLHR.kicad_sch, SapphireMini_DS3231.kicad_sch, SapphireMini_GNSS.kicad_sch, SapphireMini_Pwr.kicad_sch, SapphireMini_SD.kicad_sch, file63357570.kicad_sch]
2022-09-26 Corrected to get clean review on schematic
    [SapphireMini_DS3231.kicad_sch, SapphireMini_GNSS.kicad_sch, SapphireMini_Proc.kicad_sch, SapphireMini_WIFI.kicad_sch]
2022-09-27 Minor changes to annotation
    [SapphineMinimal.kicad_sch, SapphireMini_DLHR.kicad_sch, SapphireMini_DS3231.kicad_sch, SapphireMini_GNSS.kicad_sch, SapphireMini_Proc.kicad_sch, SapphireMini_Pwr.kicad_sch, SapphireMini_SD.kicad_sch, SapphireMini_WIFI.kicad_sch]
2022-09-28 daily update
    [SapphineMinimal.kicad_sch, SapphireMini_Proc.kicad_sch, SapphireMini_SD.kicad_sch, SapphireMini_WIFI.kicad_sch]
2022-09-28 Footprints complete. Starting layout
    [SapphineMinimal.kicad_pcb, SapphineMinimal.kicad_sch, SapphireMini_DLHR.kicad_sch, SapphireMini_DS3231.kicad_sch, SapphireMini_GNSS.kicad_sch, SapphireMini_Proc.kicad_sch, SapphireMini_Pwr.kicad_sch, SapphireMini_SD.kicad_sch]
2022-09-29 replacing w/ resistor array
    [SapphineMinimal.kicad_pcb, SapphineMinimal.kicad_sch, SapphireMini_DLHR.kicad_sch, SapphireMini_Proc.kicad_sch]
2022-09-29 Working on update to power controllers
    [SapphineMinimal.kicad_pcb, SapphineMinimal.kicad_sch, SapphireMini_GNSS.kicad_sch, SapphireMini_Proc.kicad_sch, SapphireMini_Pwr.kicad_sch, SapphireMini_SD.kicad_sch, SapphireMini_WIFI.kicad_sch]
2022-10-03 Fully routed. Needs DRC check and cleanup
    [SapphineMinimal.kicad_pcb, SapphireMini_DLHR.kicad_sch, SapphireMini_Pwr.kicad_sch, SapphireMini_SD.kicad_sch, SapphireMini_WIFI.kicad_sch]
2022-10-03 Clean PCB but Added new clock to schematic
    [EXB-2HV470JV.STEP, IND_TAIYO_NR3012_TAY.step, MR45V064B.step, SAM-M8Q-0-10.step, SM04B-SRSS-TB_LF__SN_.step, SapphineMinimal.kicad_pcb, SapphineMinimal.kicad_sch, SapphireMini_DS3231.kicad_sch]
2022-10-04 Updating for parts avail
    [RV8803.kicad_sch, SapphineMinimal.kicad_sch, SapphireMini_DLHR.kicad_sch, SapphireMini_DS3231.kicad_sch, SapphireMini_GNSS.kicad_sch, SapphireMini_Proc.kicad_sch, SapphireMini_Pwr.kicad_sch, SapphireMini_SD.kicad_sch]
2022-10-13 Skematic updated for power and 1PSI sensor
    [5525DSO-DB001DS.step, SapphineMinimal.kicad_pcb, SapphineMinimal.kicad_sch, SapphireMini_DLHR.kicad_sch, SapphireMini_GNSS.kicad_sch, SapphireMini_Proc.kicad_sch, SapphireMini_Pwr.kicad_sch, SapphireMini_SD.kicad_sch]
2022-10-15 Start of layout
    [JST_SH_SM04B-SRSS-TB_1x04-1MP_P1.00mm_Horizontal.stp, RV8803.kicad_sch, SapphineMinimal.kicad_pcb, SapphineMinimal.kicad_sch, SapphireMini_DLHR.kicad_sch, SapphireMini_GNSS.kicad_sch, SapphireMini_Proc.kicad_sch, SapphireMini_Pwr.kicad_sch]
2022-10-16 Completed board Rev 1
    [AdafruitAirlift.kicad_pcb, AdafruitAirlift.kicad_sch, RV8803.kicad_sch, SapphineMinimal.kicad_pcb, SapphineMinimal.kicad_sch, SapphireMini_DLHR.kicad_sch, SapphireMini_GNSS.kicad_sch, SapphireMini_Proc.kicad_sch]
2022-10-17 updated new layout - no routing
    [MS5525DSO.kicad_sch, RV8803.kicad_sch, SapphineMinimal.kicad_pcb, SapphineMinimal.kicad_sch, SapphireMini_DLHR.kicad_sch, SapphireMini_GNSS.kicad_sch, SapphireMini_Proc.kicad_sch, SapphireMini_Pwr.kicad_sch]
2022-10-24 6 Layer Routing
    [MS5525DSO.kicad_sch, RV8803.kicad_sch, SapphineMinimal.kicad_sch, SapphireMini_DLHR.kicad_sch, SapphireMini_GNSS.kicad_sch, SapphireMini_Proc.kicad_sch, SapphireMini_Pwr.kicad_sch, SapphireMini_SD.kicad_sch]
2022-10-26 Added optional RSCK footprint
    [SapphireMini_DLHR.kicad_sch, SapphireMini_Proc.kicad_sch, SapphireMini_SD.kicad_sch, SapphireMini_WIFI.kicad_sch]
2022-10-26 Fixing board problems
    [SapphineMinimal.kicad_sch, SapphireMini_Pwr.kicad_sch, SapphireMini_SD.kicad_sch]
2022-10-27 Updated clean pcb
2022-10-28 updates to power plane
2022-10-28 Release to OSH Park
    [SapphineMinimal.kicad_sch, SapphireMini_DLHR.kicad_sch, SapphireMini_GNSS.kicad_sch, SapphireMini_Proc.kicad_sch, SapphireMini_Pwr.kicad_sch, SapphireMini_SD.kicad_sch, SapphireMini_WIFI.kicad_sch]
2022-10-28 Updates for Circuit Hub estimates
    [SapphineMinimal-B_Courtyard.gbr, SapphineMinimal-B_Cu.gbr, SapphineMinimal-B_Fab.gbr, SapphineMinimal-B_Mask.gbr, SapphineMinimal-B_Paste.gbr, SapphineMinimal-B_Silkscreen.gbr, SapphineMinimal-Edge_Cuts.gbr, SapphineMinimal-F_Courtyard.gbr]
2023-01-30 Updated PCB comments
    [SapphineMinimal.sch, SapphireMini_Proc.kicad_sch, SapphireMini_Pwr.kicad_sch, SapphireMini_SD.kicad_sch]
2023-02-19 M2 with notes before board updates
2023-02-19 Updated to fix noted problems
    [RV8803.kicad_sch, SapphineMinimal.kicad_sch, SapphireMini_DLHR.kicad_sch, SapphireMini_GNSS.kicad_sch, SapphireMini_Proc.kicad_sch, SapphireMini_Pwr.kicad_sch, SapphireMini_SD.kicad_sch]
2023-02-20 M2R2 basic DRC passed
    [LGA-12_STM.step, RSCSK2043R3D01004T.stp, SapphineMinimal.kicad_sch, SapphireMini_DLHR.kicad_sch, SapphireMini_Proc.kicad_sch, SapphireMini_Pwr.kicad_sch, SapphireMini_SD.kicad_sch]
2023-02-21 4 Layer Hand Solder version
2023-02-21 Sapphire M2R2 submitted to OSH Park 2/21/2023
    [SapphineMinimal-B_Courtyard.gbr, SapphineMinimal-B_Cu.gbr, SapphineMinimal-B_Fab.gbr, SapphineMinimal-B_Mask.gbr, SapphineMinimal-B_Paste.gbr, SapphineMinimal-B_Silkscreen.gbr, SapphineMinimal-Edge_Cuts.gbr, SapphineMinimal-F_Courtyard.gbr]
2023-02-22 HTML assembly bom created
    [SapphineMinimal.kicad_pcb]
2023-03-04 Design R2 sent to OSH Park
    [SapphineMinimal.kicad_pcb, SapphireMini_DLHR.kicad_sch, SapphirePowerSubsystem.kicad_pcb, SapphirePowerSubsystem.kicad_sch]
2023-03-06 End of Weekend
    [DS3231_sch.kicad_sch, SapphineMinimal.kicad_pcb, SapphineMinimal.kicad_sch, SapphireMini_Proc.kicad_sch, SapphireMini_Pwr.kicad_sch]
2023-03-06 Partial Routing
    [DS3231_sch.kicad_sch, SapphineMinimal.kicad_pcb, SapphineMinimal.kicad_sch, SapphireMini_DLHR.kicad_sch, SapphireMini_Pwr.kicad_sch]
2023-03-07 Clean DRC
    [SapphineMinimal.kicad_pcb]
2023-03-07 Midst of pretying layout
    [SapphineMinimal.kicad_pcb, SapphineMinimal.kicad_sch, SapphireMini_WIFI.kicad_sch]
2023-03-08 Prior to handsolder footprints
    [SapphineMinimal.kicad_pcb]
2023-03-11 Added hand solder pads
    [SapphineMinimal.kicad_pcb]
2023-03-12 Added slot for wiring
    [DS3231_sch.kicad_sch, SapphineMinimal.kicad_pcb, SapphireMini_DLHR.kicad_sch, SapphireMini_SD.kicad_sch, SapphireMini_WIFI.kicad_sch]
2023-04-23 Board Assembled w/ errors. Ready for redo
    [SapphineMinimal.kicad_pcb, SapphireMini_Pwr.kicad_sch]
2023-05-02 Board ready for final check
    [DS3231_sch.kicad_sch, SapphineMinimal.kicad_pcb, SapphineMinimal.kicad_sch, SapphireMini_DLHR.kicad_sch, SapphireMini_GNSS.kicad_sch, SapphireMini_Proc.kicad_sch, SapphireMini_Pwr.kicad_sch, SapphireMini_SD.kicad_sch]
2023-05-03 OSH Park 5-3-2023
    [FirstPlace.kicad_pcb, FirstRoute.kicad_pcb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]
2023-06-07 Updated to correct wiring of IIM42351
    [SapphineMinimal.kicad_pcb, SapphineMinimal.kicad_sch, SapphireMini_DLHR.kicad_sch, SapphireMini_GNSS.kicad_sch, SapphireMini_Proc.kicad_sch]
2023-06-19 Updated for 32KHz input on IIM42351
    [SapphineMinimal.kicad_sch, SapphireMini_DLHR.kicad_sch]
2024-02-04 After M2 at home. Not sure what changes are
    [SapphineMinimal.kicad_pcb, SapphireMini_DLHR.kicad_sch, SapphireMini_Proc.kicad_sch]
